miradolejs/c-band-downlink-analysis/measurement_stations/hardware/photos/README.md

# Hardware Photographs

This gallery documents the antenna installations, equipment setups, and custom electronics developed for the measurement stations.

Some photographs show assembly and testing stages. The final hardware configuration is specified in the [component list](../component_list.csv) and [measurement methodology](../../../docs/measurement_methodology.md).

## Urban antenna installation — Zlín

Front view of the urban antenna


*Front view of the urban antenna installation, with the faculty building and rooftop structures in the background.*

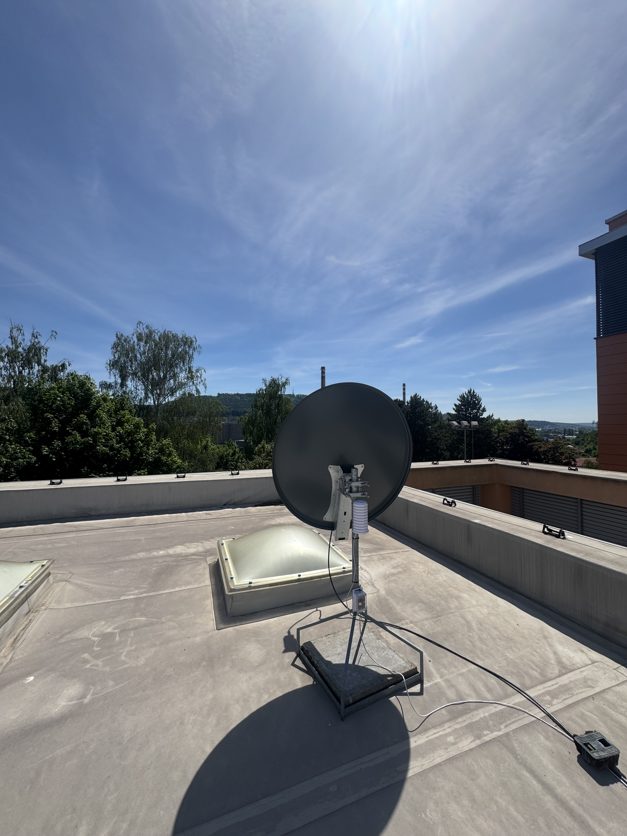
[picture p4: measurement_stations/hardware/photos/urban_antenna_rear.jpeg]
Rear view of the urban antenna


*Rear view showing the antenna support, environmental sensor radiation shield, outdoor enclosure, and cable routing.*

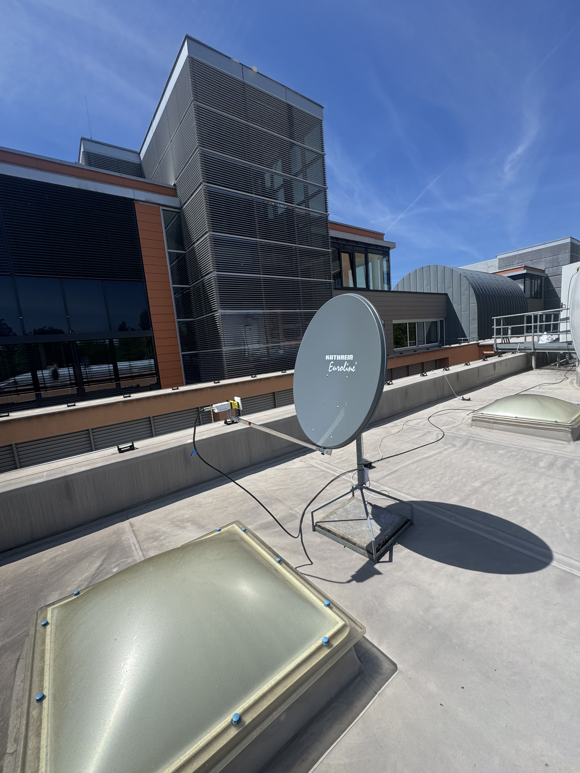
[picture p5: measurement_stations/hardware/photos/urban_antenna_side.jpeg]
Side view of the urban antenna


*Side view of the reflector, LNB assembly, and ballasted antenna support.*

## Rural antenna installation — Hošťálková

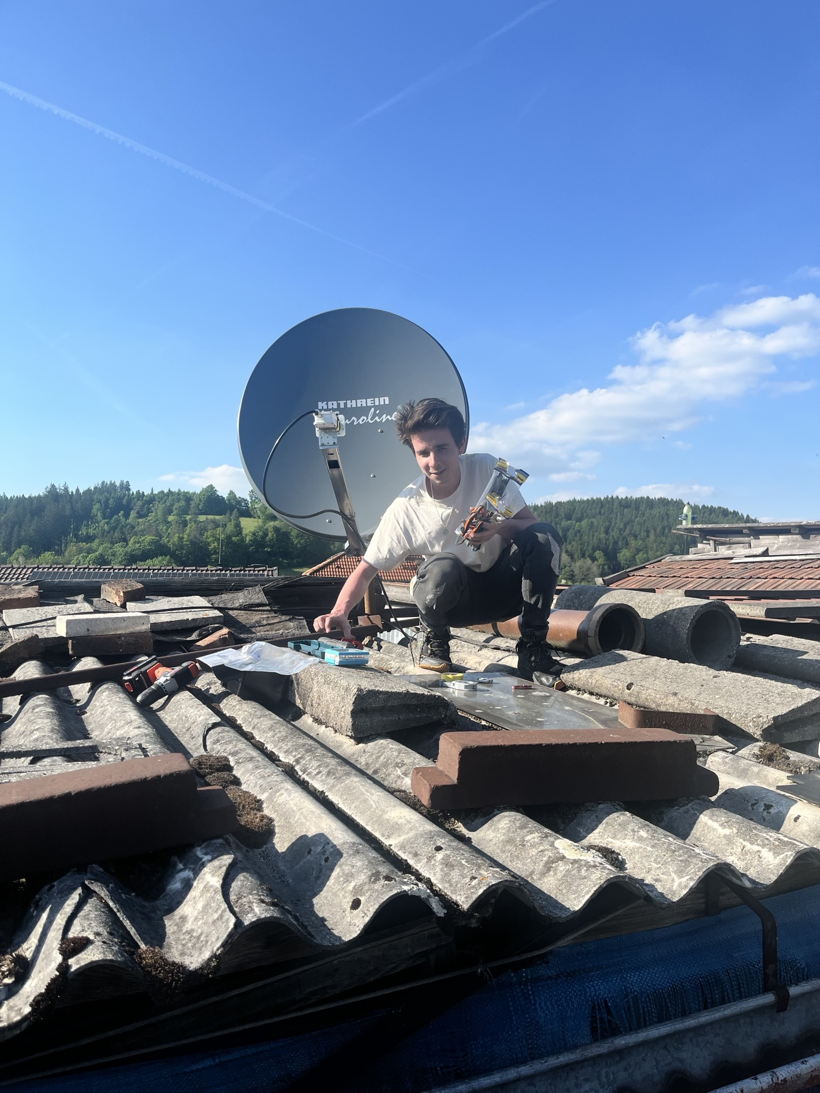
[picture p6: measurement_stations/hardware/photos/rural_antenna_installation.jpeg]
Installation of the rural antenna


*Installation work on the rural antenna, with nearby rooftops and wooded slopes in the background.*

## Rural site context — map imagery

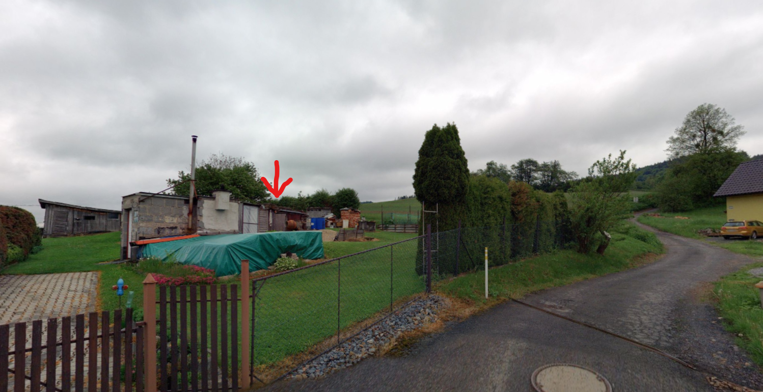
[picture p7: measurement_stations/hardware/photos/rural_installation_location.png]
Rural installation location


*Panorama image from [Mapy.com](https://mapy.com/) showing the rural installation area. The arrow marking the antenna installation location was added by the project team.*

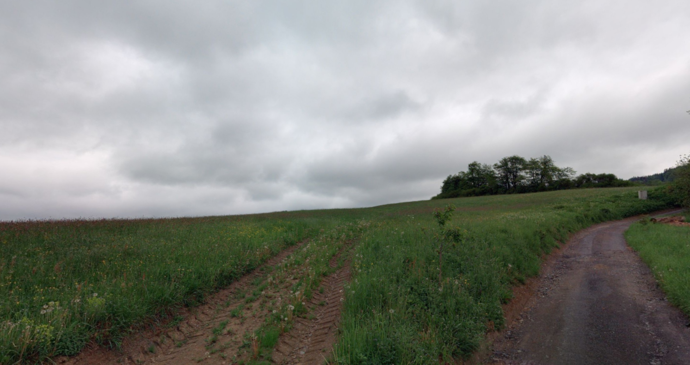
[picture p8: measurement_stations/hardware/photos/rural_reception_view.png]
Approximate rural reception direction


*Panorama image from [Mapy.com](https://mapy.com/) illustrating the approximate reception direction. The viewpoint differs from the antenna position and does not represent an exact boresight or measured horizon profile.*

## Equipment setups

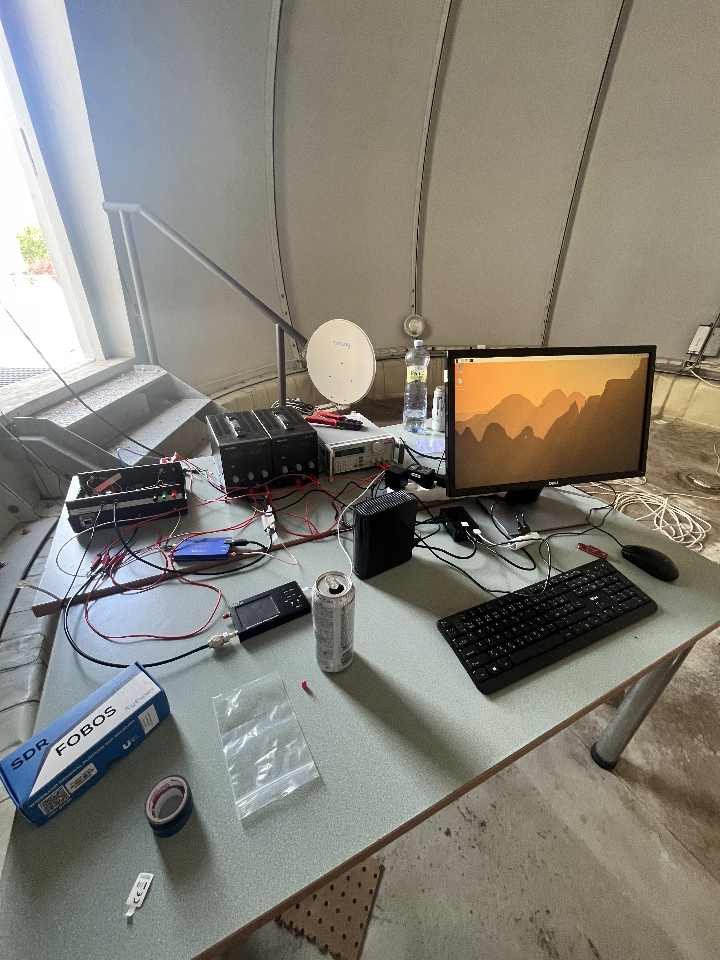
[picture p9: measurement_stations/hardware/photos/urban_equipment_setup.jpeg]
Urban equipment setup


*Equipment arrangement at the urban site during station setup, including power supplies, receiving equipment, storage, and the local computer interface.*

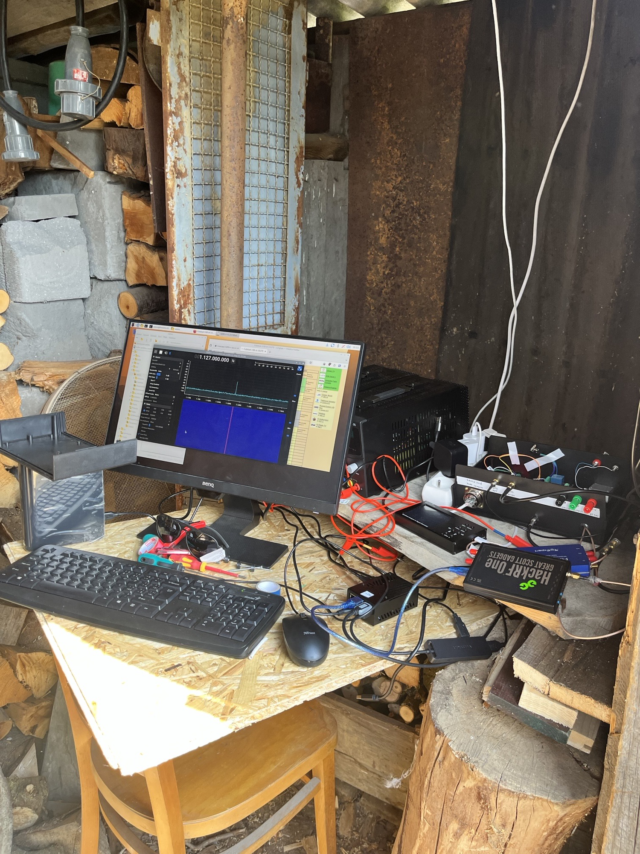
[picture p10: measurement_stations/hardware/photos/rural_equipment_setup.jpeg]
Rural equipment setup


*Equipment arrangement at the rural site during setup and testing. Additional test equipment visible in the photograph, including a HackRF One, is not part of the documented final FOBOS SDR acquisition chain.*

## Custom control electronics

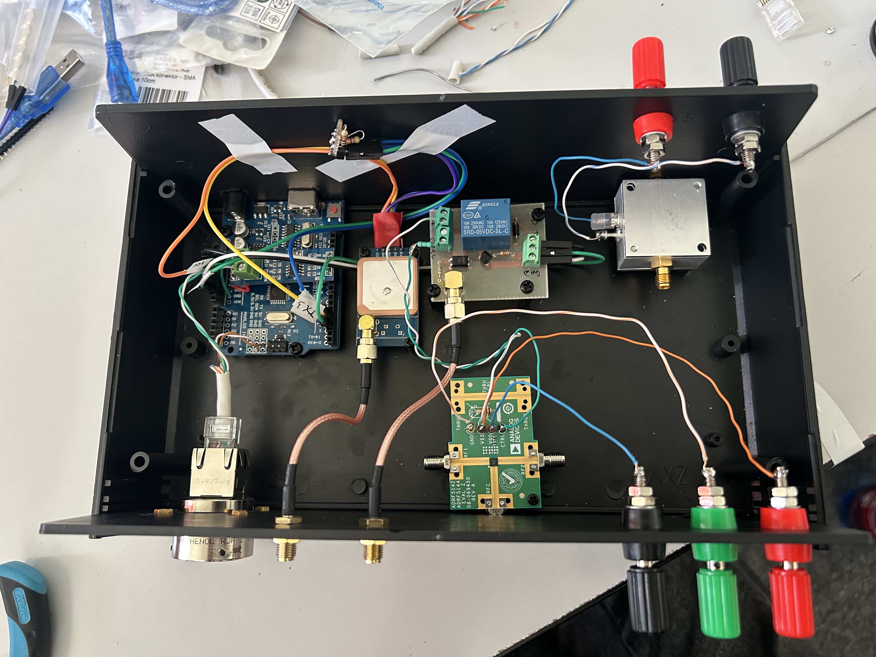
[picture p11: measurement_stations/hardware/photos/control_enclosure_interior.jpeg]
Interior of the control enclosure


*Internal arrangement of the control enclosure during assembly, showing microcontroller electronics, the GPS module, custom PPS control circuitry, RF switch board, bias tee, and panel connections.*

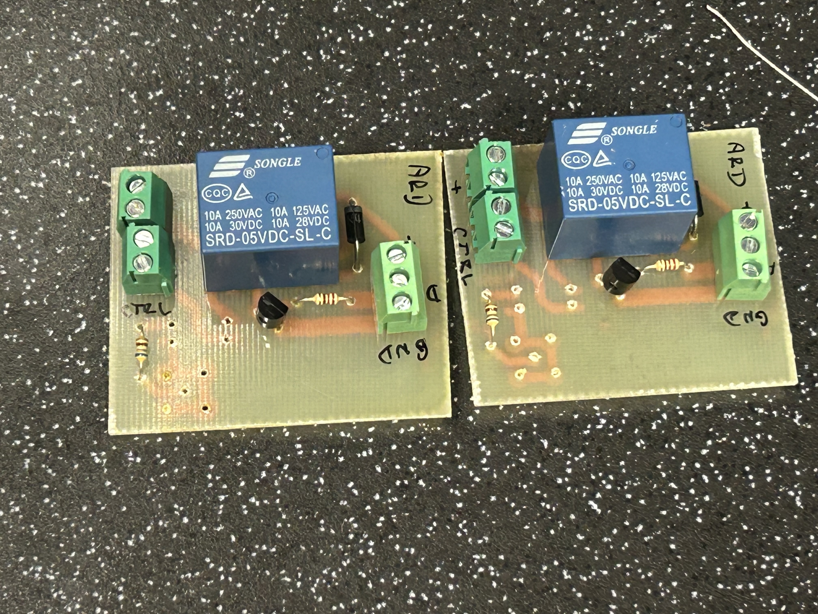
[picture p12: measurement_stations/hardware/photos/pps_control_boards_assembly.jpeg]
PPS control boards during assembly


*Two custom PPS control boards during assembly. The photograph shows the relay, transistor, protection diode, resistors, and terminal blocks; component population is not yet complete.*

## Enclosure panels

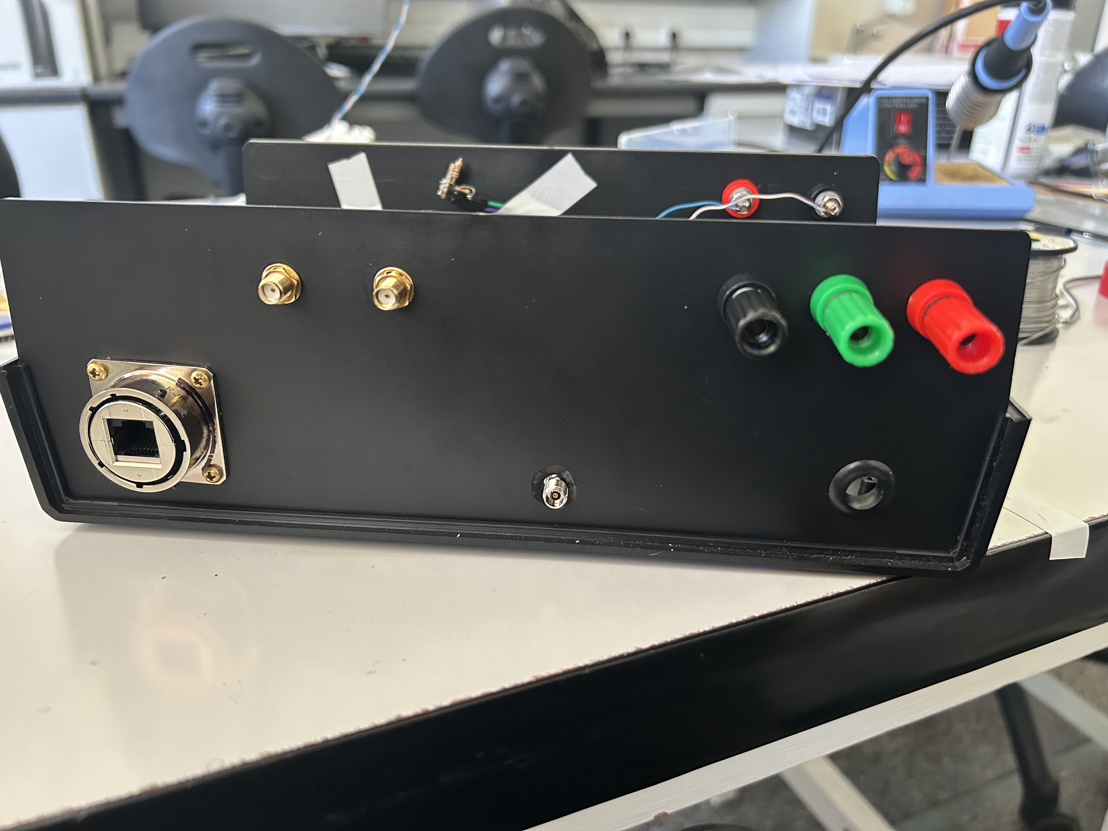
[picture p13: measurement_stations/hardware/photos/control_enclosure_panel_a.jpeg]
Control enclosure panel A


*One enclosure panel during assembly, showing the external signal, telemetry, and power connections.*

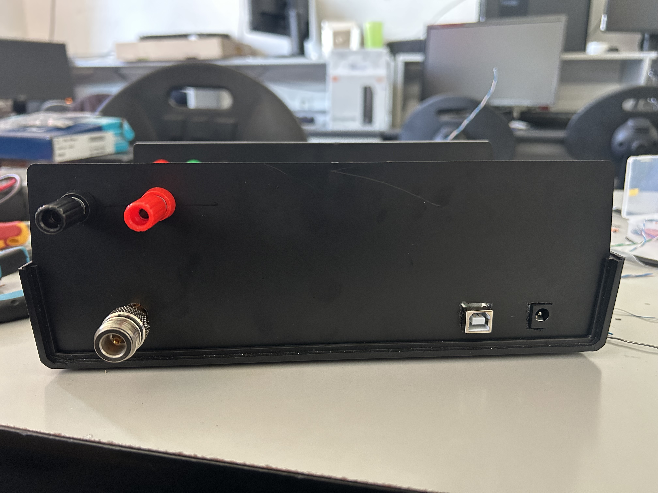
[picture p14: measurement_stations/hardware/photos/control_enclosure_panel_b.jpeg]
Control enclosure panel B


*Opposite enclosure panel during assembly, showing the N-type connector, USB interface, DC connector, and power terminals.*

## Environmental monitoring electronics

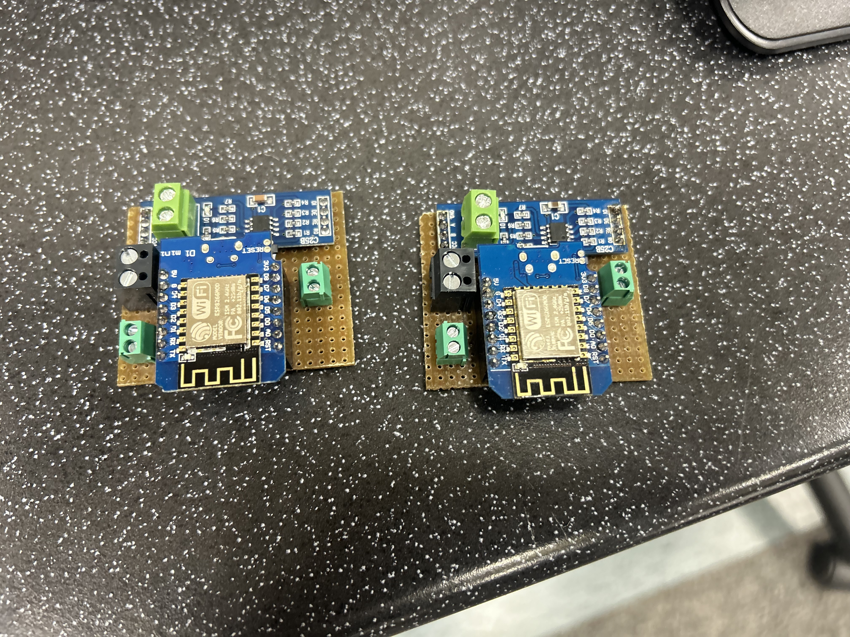
[picture p15: measurement_stations/hardware/photos/environmental_interface_boards.jpeg]
Environmental interface boards


*Two environmental interface assemblies based on Wemos D1 mini boards and RS-485 converter modules, with terminal connections for external wiring.*

## Related documentation

- [Hardware overview](../README.md)
- [Component list](../component_list.csv)
- [Station locations](../../../docs/station_locations.md)
- [Measurement methodology](../../../docs/measurement_methodology.md)
