miradolejs/c-band-downlink-analysis/results/downlink_frames/pps_inventory/2026-09-25_2026-09-30/PPS_overview.png

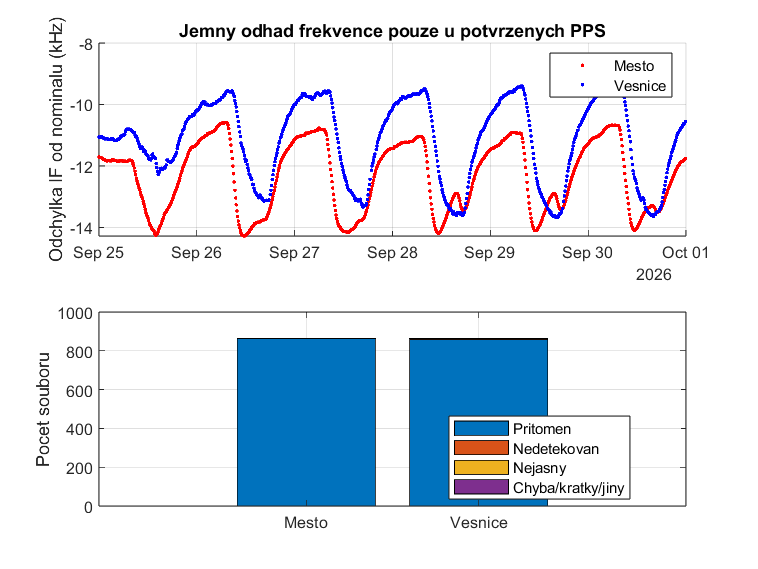
results/downlink_frames/pps_inventory/2026-09-25_2026-09-30/PPS_overview.png
