miradolejs/c-band-downlink-analysis/measurement_stations/hardware/component_list.csv

Category | Component | Model | Specification | Function | Quantity_City | Quantity_Village | Quantity_Total | Unit | Parent_Assembly | Notes
Reception | Parabolic reflector | Kathrein KEA 1000/G | 100 cm; aluminium reflector; graphite colour | Collect C-band satellite signals | 1 | 1 | 2 | piece
Reception | LNB | Norsat 3620N | C-band; linear polarization; LO 5150 MHz; 50 ohm output | Amplify and downconvert the received signal | 1 | 1 | 2 | piece
Reception | Bias tee | ZFBT-4R2GW-FT+ | 24 V DC supplied to the LNB | Supply DC power to the LNB and block DC towards the SDR | 1 | 1 | 2 | piece
Power | Linear laboratory power supply | VOLTCRAFT LPS1305 | LNB: 24 V DC; RF switch: +3.3 V and -3.3 V relative to common ground | Power the LNB and RF switch | 3 | 3 | 6 | piece |  | One supply for the 24 V LNB feed; two supplies for the RF switch bipolar supply (+3.3 V / -3.3 V).
Reception | Main coaxial cable | SSB Electronic Ecoflex 10 | 50 ohm | Connect the LNB to the SDR receiving chain | 17 | 10 | 27 | m |  | Cable length differs between sites.
Reception | N connector | SSB Electronic 7383 | For Ecoflex 10 / Aircom cable | Terminate the main coaxial cable | 2 | 2 | 4 | piece
Reception | SMA female to N female adapter | Amphenol 242115 |  | Adapt the bias tee connections | 2 | 2 | 4 | piece
Reception | SDR receiver | FOBOS SDR |  | Digitize the received IF signal | 1 | 1 | 2 | piece
Marker control | AND control assembly | Custom design | Relay and optocoupler implementation | Combine the Arduino enable signal and GPSDO PPS | 1 | 1 | 2 | piece |  | Assembly reference only; individual parts are listed separately. Quantity inferred as one assembly per station.
Marker control | Relay | Songle SRD-05VDC-SL-C | 5 V coil | Gate the control path under Arduino control | 1 | 1 | 2 | piece | Custom AND control assembly
Marker control | NPN transistor | 2N2222 | 40 V; 600 mA; TO-92 | Drive the relay from the Arduino | 1 | 1 | 2 | piece | Custom AND control assembly | Ratings reproduced from the supplied component list.
Marker control | Optocoupler | BPC-817 |  | Control the RF switch from PPS with galvanic isolation | 1 | 1 | 2 | piece | Custom AND control assembly
Marker control | Resistor | RC0204 | 680 ohm; 0.125 W; 5%; carbon | Limit optocoupler input current | 1 | 1 | 2 | piece | Custom AND control assembly
Marker control | Resistor | RC0204 | 220 ohm; 0.25 W; 5% | Limit transistor base current | 1 | 1 | 2 | piece | Custom AND control assembly
Marker control | Two-position PCB terminal block | CY350-3.5-2P | 3.5 mm pitch; green | Connect the RF switch | 2 | 2 | 4 | piece | Custom AND control assembly
Marker control | Three-position PCB terminal block | CY350-3.5-3P | 3.5 mm pitch; green | Connect the Arduino | 1 | 1 | 2 | piece | Custom AND control assembly
Marker control | PCB SMA connector | Taoglas PCB.SMAFRA.HT |  | Connect the GPSDO PPS input | 1 | 1 | 2 | piece | Custom AND control assembly
Control and telemetry | Microcontroller board | UNO R3 clone | ATmega328P; CH340 USB interface | Control PPS injection; collect environmental readings; forward data to Raspberry Pi | 1 | 1 | 2 | piece
Control and telemetry | Temperature and humidity sensor | AHT10 |  | Measure air temperature and relative humidity | 1 | 1 | 2 | piece
Control and telemetry | GPS receiver module | NEO-7M |  | Provide timing information to the Arduino | 1 | 1 | 2 | piece
Control and telemetry | Outdoor sensor microcontroller | WeMos D1 Mini | ESP8266 | Read the environmental sensor near the antenna | 1 | 1 | 2 | piece
Control and telemetry | TTL to RS-485 converter | MAX485 module |  | Provide the serial link between Wemos and Arduino | 2 | 2 | 4 | piece
Control and telemetry | GPS antenna for NEO-7M | EAN 8596425189878 | Magnetic base; 3 m cable; SMA connector | Receive GNSS signals for the Arduino GPS module | 1 | 1 | 2 | piece |  | Separate from the GPS antenna included with the GPSDO.
Enclosures | Outdoor enclosure | Not specified | IP66; ABS V0 body; PC V0 transparent cover; 132.2 x 68.7 x 50.1 mm | House the Wemos D1 mini | 1 | 1 | 2 | piece
Enclosures | Sensor radiation shield | TFA Dostmann 98.1114.02 |  | Shield the AHT10 environmental sensor | 1 | 1 | 2 | piece
Enclosures | Silica gel desiccant sachet | Not specified | 10 g per sachet; 72 x 57 x 3 mm | Reduce moisture inside the Wemos enclosure | 3 | 3 | 6 | piece |  | Three sachets per station.
Acquisition computer | Single-board computer | Raspberry Pi 5 | 16 GB RAM | Control IQ acquisition and metadata recording | 1 | 1 | 2 | piece
Acquisition computer | Computer and NVMe enclosure | Pimoroni case for NVMe Base and Raspberry Pi 5 |  | House the Raspberry Pi and NVMe Base | 1 | 1 | 2 | piece
Acquisition computer | NVMe adapter board | Pimoroni NVMe Base for Raspberry Pi 5 |  | Connect the NVMe SSD to Raspberry Pi | 1 | 1 | 2 | piece
Acquisition computer | Active cooler | Raspberry Pi 5 Active Cooler |  | Cool the Raspberry Pi | 1 | 1 | 2 | piece
Power | Raspberry Pi power supply | Raspberry Pi 27W USB-C Power Supply | EU plug; black | Power the Raspberry Pi | 1 | 1 | 2 | piece
Acquisition computer | Monitor cable | Raspberry Pi micro-HDMI cable | 1 m; black | Connect a monitor during setup or maintenance | 1 | 1 | 2 | piece
Storage | NVMe SSD | PATRIOT P310 | 240 GB; M.2 NVMe | Provide temporary recording storage during HDD replacement | 1 | 1 | 2 | piece
Storage | External hard disk | WD Elements Desktop WDBWLG0160HBK-EESN | 16 TB per drive; 3.5 inch | Store recorded IQ data | 2 | 2 | 4 | piece |  | Two drives used per station and exchanged manually. Acquisition was split between drives to allow analysis of collected data while recording continued. One 16 TB drive per station would have provided sufficient capacity for the documented campaign.
Timing reference | GPSDO with external GPS antenna | Leo Bodnar LBE-1425 | Two-port | Provide the SDR 10 MHz reference and PPS marker timing | 1 | 1 | 2 | piece |  | Quantity is a kit including its GPS antenna.
Marker injection | RF signal generator / spectrum analyzer | HTOOL SA8 |  | Generate the continuous-wave RF marker signal | 1 | 1 | 2 | piece
Marker injection | RF switch evaluation board | ADRF5144-EVALZ |  | Gate the RF marker according to the PPS control signal | 1 | 1 | 2 | piece
Interconnects | Banana test lead | VOLTCRAFT | 4 mm plugs at both ends; 1 m | Connect laboratory power supplies to the RF switch and bias tee | 6 | 6 | 12 | piece
Interconnects | SMA coaxial cable | CSE-SGAM-305-SGAM |  | Connect timing references and RF components | 5 | 5 | 10 | piece |  | PPS to AND assembly; 10 MHz to SDR; SDR to bias tee; generator to switch; switch output for capacitive injection.
Enclosures | Electronics enclosure | Z15 / KP13 | 148 x 250 x 90 mm; side panels | House the RF switch; bias tee; Arduino; NEO-7M; AND assembly | 1 | 1 | 2 | piece
Interconnects | SMA male to SMA female extension | Not specified | 10 cm | Route the GPS module and AND assembly SMA connections to the enclosure panel | 2 | 2 | 4 | piece
Interconnects | Panel banana terminal | Not specified |  | Expose RF switch and bias tee power connections on the enclosure panel | 5 | 5 | 10 | piece
