miradolejs/c-band-downlink-analysis/results/downlink_frames/pps_inventory/2026-09-25_2026-09-30/PPS_all_files.csv

Measurement_ID | Source_File | File_Name | Day_Folder | File_Start_Time | Filename_Time_Valid | File_Size_Bytes | Analyzed_Duration_s | Complete_First5s | Status | PPS_Detected | Pulse_Count | Candidate_Pulse_Count | Marker_IF_Hz | Marker_Offset_Hz | Pulse_Frequency_Spread_Hz | Coarse_Candidate_IF_Hz | FFT_Bin_Width_Hz | Max_Period_Residual_s | Median_Line_SNR_dB | Median_Temporal_Contrast_dB | Clipped_Sample_Fraction | Metadata_Status | Message | Location
250926/1013_000000_250926.raw | E:\iq_data\mesto_1_2509_3009_2026\250926\1013_000000_250926.raw | 1013_000000_250926.raw | 250926 | 25-Sep-2026 00:00:00 | 1 | 2391818240 | 5 | 1 | present | 1 | 4 | 4 | 1314988299.889 | -11700.111 | 0.011 | 1314988281.25 | 48.828125 | 0 | 34.415 | 34.435 | 0 | checked | Uzka prerusovana cara; pozadovany pocet pulzu splnuje periodu PPS. | city
250926/1014_001000_250926.raw | E:\iq_data\mesto_1_2509_3009_2026\250926\1014_001000_250926.raw | 1014_001000_250926.raw | 250926 | 25-Sep-2026 00:10:00 | 1 | 2399158272 | 5 | 1 | present | 1 | 4 | 5 | 1314988285.219 | -11714.781 | 0.078 | 1314988281.25 | 48.828125 | 0 | 34.846 | 34.279 | 0 | checked | Uzka prerusovana cara; pozadovany pocet pulzu splnuje periodu PPS. | city
250926/1015_002000_250926.raw | E:\iq_data\mesto_1_2509_3009_2026\250926\1015_002000_250926.raw | 1015_002000_250926.raw | 250926 | 25-Sep-2026 00:20:00 | 1 | 2399158272 | 5 | 1 | present | 1 | 4 | 5 | 1314988276.015 | -11723.985 | 0.033 | 1314988281.25 | 48.828125 | 0 | 34.514 | 33.996 | 0 | checked | Uzka prerusovana cara; pozadovany pocet pulzu splnuje periodu PPS. | city
250926/1016_003000_250926.raw | E:\iq_data\mesto_1_2509_3009_2026\250926\1016_003000_250926.raw | 1016_003000_250926.raw | 250926 | 25-Sep-2026 00:30:00 | 1 | 2399158272 | 5 | 1 | present | 1 | 5 | 5 | 1314988272.384 | -11727.616 | 0.2 | 1314988281.25 | 48.828125 | 0.035 | 34.71 | 34.665 | 0 | checked | Uzka prerusovana cara; pozadovany pocet pulzu splnuje periodu PPS. | city
250926/1017_004000_250926.raw | E:\iq_data\mesto_1_2509_3009_2026\250926\1017_004000_250926.raw | 1017_004000_250926.raw | 250926 | 25-Sep-2026 00:40:00 | 1 | 2400206848 | 5 | 1 | present | 1 | 4 | 4 | 1314988257.318 | -11742.682 | 0.024 | 1314988232.42188 | 48.828125 | 0 | 34.801 | 34.237 | 0 | checked | Uzka prerusovana cara; pozadovany pocet pulzu splnuje periodu PPS. | city
250926/1018_005000_250926.raw | E:\iq_data\mesto_1_2509_3009_2026\250926\1018_005000_250926.raw | 1018_005000_250926.raw | 250926 | 25-Sep-2026 00:50:00 | 1 | 2399158272 | 5 | 1 | present | 1 | 4 | 4 | 1314988243.792 | -11756.208 | 0.006 | 1314988232.42188 | 48.828125 | 0 | 36.021 | 35.416 | 0 | checked | Uzka prerusovana cara; pozadovany pocet pulzu splnuje periodu PPS. | city
250926/1019_010000_250926.raw | E:\iq_data\mesto_1_2509_3009_2026\250926\1019_010000_250926.raw | 1019_010000_250926.raw | 250926 | 25-Sep-2026 01:00:00 | 1 | 2399158272 | 5 | 1 | present | 1 | 4 | 4 | 1314988223.779 | -11776.221 | 0.1 | 1314988232.42188 | 48.828125 | 0 | 34.222 | 34.139 | 0 | checked | Uzka prerusovana cara; pozadovany pocet pulzu splnuje periodu PPS. | city
250926/1020_011000_250926.raw | E:\iq_data\mesto_1_2509_3009_2026\250926\1020_011000_250926.raw | 1020_011000_250926.raw | 250926 | 25-Sep-2026 01:10:00 | 1 | 2399158272 | 5 | 1 | present | 1 | 4 | 5 | 1314988209.459 | -11790.541 | 0.023 | 1314988232.42188 | 48.828125 | 0 | 35.454 | 34.809 | 0 | checked | Uzka prerusovana cara; pozadovany pocet pulzu splnuje periodu PPS. | city
250926/1021_012000_250926.raw | E:\iq_data\mesto_1_2509_3009_2026\250926\1021_012000_250926.raw | 1021_012000_250926.raw | 250926 | 25-Sep-2026 01:20:00 | 1 | 2399158272 | 5 | 1 | present | 1 | 4 | 5 | 1314988201.726 | -11798.274 | 0.075 | 1314988183.59375 | 48.828125 | 0 | 35.235 | 35.396 | 0 | checked | Uzka prerusovana cara; pozadovany pocet pulzu splnuje periodu PPS. | city
250926/1022_013000_250926.raw | E:\iq_data\mesto_1_2509_3009_2026\250926\1022_013000_250926.raw | 1022_013000_250926.raw | 250926 | 25-Sep-2026 01:30:00 | 1 | 2399158272 | 5 | 1 | present | 1 | 4 | 4 | 1314988191.488 | -11808.512 | 0.034 | 1314988183.59375 | 48.828125 | 0 | 36.584 | 35.672 | 0 | checked | Uzka prerusovana cara; pozadovany pocet pulzu splnuje periodu PPS. | city
250926/1023_014000_250926.raw | E:\iq_data\mesto_1_2509_3009_2026\250926\1023_014000_250926.raw | 1023_014000_250926.raw | 250926 | 25-Sep-2026 01:40:00 | 1 | 2399158272 | 5 | 1 | present | 1 | 4 | 4 | 1314988182.336 | -11817.664 | 0.141 | 1314988183.59375 | 48.828125 | 0 | 35.283 | 35.212 | 0 | checked | Uzka prerusovana cara; pozadovany pocet pulzu splnuje periodu PPS. | city
250926/1024_015000_250926.raw | E:\iq_data\mesto_1_2509_3009_2026\250926\1024_015000_250926.raw | 1024_015000_250926.raw | 250926 | 25-Sep-2026 01:50:00 | 1 | 2399158272 | 5 | 1 | present | 1 | 4 | 5 | 1314988166.579 | -11833.421 | 0.024 | 1314988134.76563 | 48.828125 | 0 | 33.532 | 33.214 | 0 | checked | Uzka prerusovana cara; pozadovany pocet pulzu splnuje periodu PPS. | city
250926/1025_020000_250926.raw | E:\iq_data\mesto_1_2509_3009_2026\250926\1025_020000_250926.raw | 1025_020000_250926.raw | 250926 | 25-Sep-2026 02:00:00 | 1 | 2400206848 | 5 | 1 | present | 1 | 4 | 5 | 1314988160.245 | -11839.755 | 0.045 | 1314988183.59375 | 48.828125 | 0 | 35.231 | 35.453 | 0 | checked | Uzka prerusovana cara; pozadovany pocet pulzu splnuje periodu PPS. | city
250926/1026_021000_250926.raw | E:\iq_data\mesto_1_2509_3009_2026\250926\1026_021000_250926.raw | 1026_021000_250926.raw | 250926 | 25-Sep-2026 02:10:00 | 1 | 2399158272 | 5 | 1 | present | 1 | 4 | 5 | 1314988172.767 | -11827.233 | 0.057 | 1314988183.59375 | 48.828125 | 0 | 35.486 | 34.345 | 0 | checked | Uzka prerusovana cara; pozadovany pocet pulzu splnuje periodu PPS. | city
250926/1027_022000_250926.raw | E:\iq_data\mesto_1_2509_3009_2026\250926\1027_022000_250926.raw | 1027_022000_250926.raw | 250926 | 25-Sep-2026 02:20:00 | 1 | 2399158272 | 5 | 1 | present | 1 | 4 | 4 | 1314988173.758 | -11826.242 | 0.057 | 1314988183.59375 | 48.828125 | 0 | 35.354 | 34.926 | 0 | checked | Uzka prerusovana cara; pozadovany pocet pulzu splnuje periodu PPS. | city
250926/1028_023000_250926.raw | E:\iq_data\mesto_1_2509_3009_2026\250926\1028_023000_250926.raw | 1028_023000_250926.raw | 250926 | 25-Sep-2026 02:30:00 | 1 | 2395619328 | 5 | 1 | present | 1 | 4 | 4 | 1314988168.571 | -11831.429 | 0.071 | 1314988183.59375 | 48.828125 | 0 | 36.503 | 35.561 | 0 | checked | Uzka prerusovana cara; pozadovany pocet pulzu splnuje periodu PPS. | city
250926/1029_024000_250926.raw | E:\iq_data\mesto_1_2509_3009_2026\250926\1029_024000_250926.raw | 1029_024000_250926.raw | 250926 | 25-Sep-2026 02:40:00 | 1 | 2396389376 | 5 | 1 | present | 1 | 4 | 5 | 1314988170.002 | -11829.998 | 0.038 | 1314988183.59375 | 48.828125 | 0 | 36.773 | 35.933 | 0 | checked | Uzka prerusovana cara; pozadovany pocet pulzu splnuje periodu PPS. | city
250926/1030_025000_250926.raw | E:\iq_data\mesto_1_2509_3009_2026\250926\1030_025000_250926.raw | 1030_025000_250926.raw | 250926 | 25-Sep-2026 02:50:00 | 1 | 2399158272 | 5 | 1 | present | 1 | 5 | 5 | 1314988162.563 | -11837.437 | 0.085 | 1314988134.76563 | 48.828125 | 0.025 | 36.32 | 35.785 | 0 | checked | Uzka prerusovana cara; pozadovany pocet pulzu splnuje periodu PPS. | city
250926/1031_030000_250926.raw | E:\iq_data\mesto_1_2509_3009_2026\250926\1031_030000_250926.raw | 1031_030000_250926.raw | 250926 | 25-Sep-2026 03:00:00 | 1 | 2399158272 | 5 | 1 | present | 1 | 4 | 4 | 1314988174.951 | -11825.049 | 0.099 | 1314988183.59375 | 48.828125 | 0 | 37.039 | 35.751 | 0 | checked | Uzka prerusovana cara; pozadovany pocet pulzu splnuje periodu PPS. | city
250926/1032_031000_250926.raw | E:\iq_data\mesto_1_2509_3009_2026\250926\1032_031000_250926.raw | 1032_031000_250926.raw | 250926 | 25-Sep-2026 03:10:00 | 1 | 2399158272 | 5 | 1 | present | 1 | 4 | 5 | 1314988195.184 | -11804.816 | 0.085 | 1314988183.59375 | 48.828125 | 0 | 36.849 | 35.671 | 0 | checked | Uzka prerusovana cara; pozadovany pocet pulzu splnuje periodu PPS. | city
250926/1033_032000_250926.raw | E:\iq_data\mesto_1_2509_3009_2026\250926\1033_032000_250926.raw | 1033_032000_250926.raw | 250926 | 25-Sep-2026 03:20:00 | 1 | 2399158272 | 5 | 1 | present | 1 | 4 | 5 | 1314988202.949 | -11797.051 | 0.036 | 1314988183.59375 | 48.828125 | 0 | 36.821 | 35.749 | 0 | checked | Uzka prerusovana cara; pozadovany pocet pulzu splnuje periodu PPS. | city
250926/1034_033000_250926.raw | E:\iq_data\mesto_1_2509_3009_2026\250926\1034_033000_250926.raw | 1034_033000_250926.raw | 250926 | 25-Sep-2026 03:30:00 | 1 | 2399158272 | 5 | 1 | present | 1 | 4 | 4 | 1314988199.419 | -11800.581 | 0.024 | 1314988183.59375 | 48.828125 | 0 | 36.658 | 35.649 | 0 | checked | Uzka prerusovana cara; pozadovany pocet pulzu splnuje periodu PPS. | city
250926/1035_034000_250926.raw | E:\iq_data\mesto_1_2509_3009_2026\250926\1035_034000_250926.raw | 1035_034000_250926.raw | 250926 | 25-Sep-2026 03:40:00 | 1 | 2399158272 | 5 | 1 | present | 1 | 4 | 4 | 1314988194.832 | -11805.168 | 0.209 | 1314988183.59375 | 48.828125 | 0 | 36.51 | 35.679 | 0 | checked | Uzka prerusovana cara; pozadovany pocet pulzu splnuje periodu PPS. | city
250926/1036_035000_250926.raw | E:\iq_data\mesto_1_2509_3009_2026\250926\1036_035000_250926.raw | 1036_035000_250926.raw | 250926 | 25-Sep-2026 03:50:00 | 1 | 2399158272 | 5 | 1 | present | 1 | 4 | 5 | 1314988188.261 | -11811.739 | 0.013 | 1314988183.59375 | 48.828125 | 0 | 36.62 | 36.024 | 0 | checked | Uzka prerusovana cara; pozadovany pocet pulzu splnuje periodu PPS. | city
250926/1037_040000_250926.raw | E:\iq_data\mesto_1_2509_3009_2026\250926\1037_040000_250926.raw | 1037_040000_250926.raw | 250926 | 25-Sep-2026 04:00:00 | 1 | 2399158272 | 5 | 1 | present | 1 | 4 | 5 | 1314988181.541 | -11818.459 | 0.026 | 1314988183.59375 | 48.828125 | 0.005 | 37.029 | 35.827 | 0 | checked | Uzka prerusovana cara; pozadovany pocet pulzu splnuje periodu PPS. | city
250926/1038_041000_250926.raw | E:\iq_data\mesto_1_2509_3009_2026\250926\1038_041000_250926.raw | 1038_041000_250926.raw | 250926 | 25-Sep-2026 04:10:00 | 1 | 2399158272 | 5 | 1 | present | 1 | 4 | 4 | 1314988175.801 | -11824.199 | 0.049 | 1314988183.59375 | 48.828125 | 0 | 36.668 | 35.783 | 0 | checked | Uzka prerusovana cara; pozadovany pocet pulzu splnuje periodu PPS. | city
250926/1039_042000_250926.raw | E:\iq_data\mesto_1_2509_3009_2026\250926\1039_042000_250926.raw | 1039_042000_250926.raw | 250926 | 25-Sep-2026 04:20:00 | 1 | 2399158272 | 5 | 1 | present | 1 | 4 | 4 | 1314988161.794 | -11838.206 | 0.05 | 1314988183.59375 | 48.828125 | 0 | 36.536 | 36.17 | 0 | checked | Uzka prerusovana cara; pozadovany pocet pulzu splnuje periodu PPS. | city
250926/1040_043000_250926.raw | E:\iq_data\mesto_1_2509_3009_2026\250926\1040_043000_250926.raw | 1040_043000_250926.raw | 250926 | 25-Sep-2026 04:30:00 | 1 | 2399158272 | 5 | 1 | present | 1 | 4 | 5 | 1314988153.761 | -11846.239 | 0.038 | 1314988183.59375 | 48.828125 | 0.005 | 36.108 | 36.151 | 0 | checked | Uzka prerusovana cara; pozadovany pocet pulzu splnuje periodu PPS. | city
250926/1041_044000_250926.raw | E:\iq_data\mesto_1_2509_3009_2026\250926\1041_044000_250926.raw | 1041_044000_250926.raw | 250926 | 25-Sep-2026 04:40:00 | 1 | 2398109696 | 5 | 1 | present | 1 | 5 | 5 | 1314988151.785 | -11848.215 | 0.047 | 1314988134.76563 | 48.828125 | 0.03 | 36.453 | 35.828 | 0 | checked | Uzka prerusovana cara; pozadovany pocet pulzu splnuje periodu PPS. | city
250926/1042_045000_250926.raw | E:\iq_data\mesto_1_2509_3009_2026\250926\1042_045000_250926.raw | 1042_045000_250926.raw | 250926 | 25-Sep-2026 04:50:00 | 1 | 2399158272 | 5 | 1 | present | 1 | 4 | 4 | 1314988155.797 | -11844.203 | 0.074 | 1314988134.76563 | 48.828125 | 0 | 37.168 | 36.212 | 0 | checked | Uzka prerusovana cara; pozadovany pocet pulzu splnuje periodu PPS. | city
250926/1043_050000_250926.raw | E:\iq_data\mesto_1_2509_3009_2026\250926\1043_050000_250926.raw | 1043_050000_250926.raw | 250926 | 25-Sep-2026 05:00:00 | 1 | 2399158272 | 5 | 1 | present | 1 | 4 | 5 | 1314988163.223 | -11836.777 | 0.05 | 1314988183.59375 | 48.828125 | 0 | 36.728 | 35.693 | 0 | checked | Uzka prerusovana cara; pozadovany pocet pulzu splnuje periodu PPS. | city
250926/1044_051000_250926.raw | E:\iq_data\mesto_1_2509_3009_2026\250926\1044_051000_250926.raw | 1044_051000_250926.raw | 250926 | 25-Sep-2026 05:10:00 | 1 | 2399158272 | 5 | 1 | present | 1 | 5 | 5 | 1314988170.407 | -11829.593 | 0.146 | 1314988183.59375 | 48.828125 | 0.035 | 36.644 | 36.34 | 0 | checked | Uzka prerusovana cara; pozadovany pocet pulzu splnuje periodu PPS. | city
250926/1045_052000_250926.raw | E:\iq_data\mesto_1_2509_3009_2026\250926\1045_052000_250926.raw | 1045_052000_250926.raw | 250926 | 25-Sep-2026 05:20:00 | 1 | 2397585408 | 5 | 1 | present | 1 | 4 | 4 | 1314988170.83 | -11829.17 | 0.118 | 1314988183.59375 | 48.828125 | 0 | 35.386 | 35.599 | 0 | checked | Uzka prerusovana cara; pozadovany pocet pulzu splnuje periodu PPS. | city
250926/1046_053000_250926.raw | E:\iq_data\mesto_1_2509_3009_2026\250926\1046_053000_250926.raw | 1046_053000_250926.raw | 250926 | 25-Sep-2026 05:30:00 | 1 | 2399158272 | 5 | 1 | present | 1 | 4 | 4 | 1314988174.478 | -11825.522 | 0.059 | 1314988183.59375 | 48.828125 | 0 | 35.113 | 35.425 | 0 | checked | Uzka prerusovana cara; pozadovany pocet pulzu splnuje periodu PPS. | city
250926/1047_054000_250926.raw | E:\iq_data\mesto_1_2509_3009_2026\250926\1047_054000_250926.raw | 1047_054000_250926.raw | 250926 | 25-Sep-2026 05:40:00 | 1 | 2399158272 | 5 | 1 | present | 1 | 4 | 5 | 1314988167.124 | -11832.876 | 0.069 | 1314988183.59375 | 48.828125 | 0 | 35.458 | 35.542 | 0 | checked | Uzka prerusovana cara; pozadovany pocet pulzu splnuje periodu PPS. | city
250926/1048_055000_250926.raw | E:\iq_data\mesto_1_2509_3009_2026\250926\1048_055000_250926.raw | 1048_055000_250926.raw | 250926 | 25-Sep-2026 05:50:00 | 1 | 2399158272 | 5 | 1 | present | 1 | 4 | 5 | 1314988163.571 | -11836.429 | 0.044 | 1314988183.59375 | 48.828125 | 0 | 35.143 | 35.27 | 0 | checked | Uzka prerusovana cara; pozadovany pocet pulzu splnuje periodu PPS. | city
250926/1049_060000_250926.raw | E:\iq_data\mesto_1_2509_3009_2026\250926\1049_060000_250926.raw | 1049_060000_250926.raw | 250926 | 25-Sep-2026 06:00:00 | 1 | 2400272384 | 5 | 1 | present | 1 | 4 | 4 | 1314988157.882 | -11842.118 | 0.038 | 1314988134.76563 | 48.828125 | 0 | 35.151 | 35.05 | 0 | checked | Uzka prerusovana cara; pozadovany pocet pulzu splnuje periodu PPS. | city
250926/1050_061000_250926.raw | E:\iq_data\mesto_1_2509_3009_2026\250926\1050_061000_250926.raw | 1050_061000_250926.raw | 250926 | 25-Sep-2026 06:10:00 | 1 | 2399158272 | 5 | 1 | present | 1 | 4 | 5 | 1314988160.069 | -11839.931 | 0.06 | 1314988134.76563 | 48.828125 | 0 | 35.331 | 35.129 | 0 | checked | Uzka prerusovana cara; pozadovany pocet pulzu splnuje periodu PPS. | city
250926/1051_062000_250926.raw | E:\iq_data\mesto_1_2509_3009_2026\250926\1051_062000_250926.raw | 1051_062000_250926.raw | 250926 | 25-Sep-2026 06:20:00 | 1 | 2399158272 | 5 | 1 | present | 1 | 4 | 5 | 1314988160.172 | -11839.828 | 0.08 | 1314988183.59375 | 48.828125 | 0 | 34.488 | 34.969 | 0 | checked | Uzka prerusovana cara; pozadovany pocet pulzu splnuje periodu PPS. | city
250926/1052_063000_250926.raw | E:\iq_data\mesto_1_2509_3009_2026\250926\1052_063000_250926.raw | 1052_063000_250926.raw | 250926 | 25-Sep-2026 06:30:00 | 1 | 2399158272 | 5 | 1 | present | 1 | 4 | 4 | 1314988149.195 | -11850.805 | 0.137 | 1314988134.76563 | 48.828125 | 0 | 31.283 | 31.481 | 0 | checked | Uzka prerusovana cara; pozadovany pocet pulzu splnuje periodu PPS. | city
250926/1053_064000_250926.raw | E:\iq_data\mesto_1_2509_3009_2026\250926\1053_064000_250926.raw | 1053_064000_250926.raw | 250926 | 25-Sep-2026 06:40:00 | 1 | 2399158272 | 5 | 1 | present | 1 | 4 | 4 | 1314988151.418 | -11848.582 | 0.073 | 1314988134.76563 | 48.828125 | 0 | 32.36 | 33.717 | 0 | checked | Uzka prerusovana cara; pozadovany pocet pulzu splnuje periodu PPS. | city
250926/1054_065000_250926.raw | E:\iq_data\mesto_1_2509_3009_2026\250926\1054_065000_250926.raw | 1054_065000_250926.raw | 250926 | 25-Sep-2026 06:50:00 | 1 | 2399158272 | 5 | 1 | present | 1 | 4 | 5 | 1314988152.914 | -11847.086 | 0.246 | 1314988134.76563 | 48.828125 | 0 | 32.354 | 32.284 | 0 | checked | Uzka prerusovana cara; pozadovany pocet pulzu splnuje periodu PPS. | city
250926/1055_070000_250926.raw | E:\iq_data\mesto_1_2509_3009_2026\250926\1055_070000_250926.raw | 1055_070000_250926.raw | 250926 | 25-Sep-2026 07:00:00 | 1 | 2399158272 | 5 | 1 | present | 1 | 5 | 5 | 1314988162.478 | -11837.522 | 0.116 | 1314988134.76563 | 48.828125 | 0.035 | 27.447 | 26.893 | 0 | checked | Uzka prerusovana cara; pozadovany pocet pulzu splnuje periodu PPS. | city
250926/1056_071000_250926.raw | E:\iq_data\mesto_1_2509_3009_2026\250926\1056_071000_250926.raw | 1056_071000_250926.raw | 250926 | 25-Sep-2026 07:10:00 | 1 | 2399158272 | 5 | 1 | present | 1 | 4 | 4 | 1314988180.235 | -11819.765 | 0.068 | 1314988183.59375 | 48.828125 | 0 | 31.474 | 31.814 | 0 | checked | Uzka prerusovana cara; pozadovany pocet pulzu splnuje periodu PPS. | city
250926/1057_072000_250926.raw | E:\iq_data\mesto_1_2509_3009_2026\250926\1057_072000_250926.raw | 1057_072000_250926.raw | 250926 | 25-Sep-2026 07:20:00 | 1 | 2400272384 | 5 | 1 | present | 1 | 4 | 4 | 1314988186.327 | -11813.673 | 0.071 | 1314988183.59375 | 48.828125 | 0 | 33.237 | 32.408 | 0 | checked | Uzka prerusovana cara; pozadovany pocet pulzu splnuje periodu PPS. | city
250926/1058_073000_250926.raw | E:\iq_data\mesto_1_2509_3009_2026\250926\1058_073000_250926.raw | 1058_073000_250926.raw | 250926 | 25-Sep-2026 07:30:00 | 1 | 2399158272 | 5 | 1 | present | 1 | 4 | 4 | 1314988193.4 | -11806.6 | 0.085 | 1314988183.59375 | 48.828125 | 0 | 32.011 | 31.705 | 0 | checked | Uzka prerusovana cara; pozadovany pocet pulzu splnuje periodu PPS. | city
250926/1059_074000_250926.raw | E:\iq_data\mesto_1_2509_3009_2026\250926\1059_074000_250926.raw | 1059_074000_250926.raw | 250926 | 25-Sep-2026 07:40:00 | 1 | 2399158272 | 5 | 1 | present | 1 | 4 | 4 | 1314988185.361 | -11814.639 | 0.024 | 1314988183.59375 | 48.828125 | 0 | 33.906 | 33.647 | 0 | checked | Uzka prerusovana cara; pozadovany pocet pulzu splnuje periodu PPS. | city
250926/1060_075000_250926.raw | E:\iq_data\mesto_1_2509_3009_2026\250926\1060_075000_250926.raw | 1060_075000_250926.raw | 250926 | 25-Sep-2026 07:50:00 | 1 | 2399158272 | 5 | 1 | present | 1 | 4 | 5 | 1314988175.917 | -11824.083 | 0.143 | 1314988183.59375 | 48.828125 | 0 | 34.499 | 33.048 | 0 | checked | Uzka prerusovana cara; pozadovany pocet pulzu splnuje periodu PPS. | city
250926/1061_080000_250926.raw | E:\iq_data\mesto_1_2509_3009_2026\250926\1061_080000_250926.raw | 1061_080000_250926.raw | 250926 | 25-Sep-2026 08:00:00 | 1 | 2399158272 | 5 | 1 | present | 1 | 5 | 5 | 1314988177.873 | -11822.127 | 0.113 | 1314988183.59375 | 48.828125 | 0.035 | 32.344 | 31.819 | 0 | checked | Uzka prerusovana cara; pozadovany pocet pulzu splnuje periodu PPS. | city
250926/1062_081000_250926.raw | E:\iq_data\mesto_1_2509_3009_2026\250926\1062_081000_250926.raw | 1062_081000_250926.raw | 250926 | 25-Sep-2026 08:10:00 | 1 | 2399158272 | 5 | 1 | present | 1 | 4 | 4 | 1314988156.053 | -11843.947 | 0.074 | 1314988134.76563 | 48.828125 | 0 | 31.533 | 31.951 | 0 | checked | Uzka prerusovana cara; pozadovany pocet pulzu splnuje periodu PPS. | city
250926/1063_082000_250926.raw | E:\iq_data\mesto_1_2509_3009_2026\250926\1063_082000_250926.raw | 1063_082000_250926.raw | 250926 | 25-Sep-2026 08:20:00 | 1 | 2399158272 | 5 | 1 | present | 1 | 4 | 5 | 1314988082.864 | -11917.136 | 0.195 | 1314988085.9375 | 48.828125 | 0 | 29.737 | 31.181 | 0 | checked | Uzka prerusovana cara; pozadovany pocet pulzu splnuje periodu PPS. | city
250926/1064_083000_250926.raw | E:\iq_data\mesto_1_2509_3009_2026\250926\1064_083000_250926.raw | 1064_083000_250926.raw | 250926 | 25-Sep-2026 08:30:00 | 1 | 2399158272 | 5 | 1 | present | 1 | 5 | 5 | 1314988022.338 | -11977.662 | 0.239 | 1314988037.10938 | 48.828125 | 0.03 | 30.166 | 31.359 | 0 | checked | Uzka prerusovana cara; pozadovany pocet pulzu splnuje periodu PPS. | city
250926/1065_084000_250926.raw | E:\iq_data\mesto_1_2509_3009_2026\250926\1065_084000_250926.raw | 1065_084000_250926.raw | 250926 | 25-Sep-2026 08:40:00 | 1 | 2400206848 | 5 | 1 | present | 1 | 4 | 4 | 1314987936.169 | -12063.831 | 0.099 | 1314987939.45313 | 48.828125 | 0 | 29.052 | 31.618 | 0 | checked | Uzka prerusovana cara; pozadovany pocet pulzu splnuje periodu PPS. | city
250926/1066_085000_250926.raw | E:\iq_data\mesto_1_2509_3009_2026\250926\1066_085000_250926.raw | 1066_085000_250926.raw | 250926 | 25-Sep-2026 08:50:00 | 1 | 2399158272 | 5 | 1 | present | 1 | 4 | 4 | 1314987825.609 | -12174.391 | 0.331 | 1314987841.79688 | 48.828125 | 0 | 32.54 | 31.933 | 0 | checked | Uzka prerusovana cara; pozadovany pocet pulzu splnuje periodu PPS. | city
250926/1067_090000_250926.raw | E:\iq_data\mesto_1_2509_3009_2026\250926\1067_090000_250926.raw | 1067_090000_250926.raw | 250926 | 25-Sep-2026 09:00:00 | 1 | 2399158272 | 5 | 1 | present | 1 | 4 | 5 | 1314987711.497 | -12288.503 | 0.152 | 1314987695.3125 | 48.828125 | 0.005 | 33.46 | 33.057 | 0 | checked | Uzka prerusovana cara; pozadovany pocet pulzu splnuje periodu PPS. | city
250926/1068_091000_250926.raw | E:\iq_data\mesto_1_2509_3009_2026\250926\1068_091000_250926.raw | 1068_091000_250926.raw | 250926 | 25-Sep-2026 09:10:00 | 1 | 2399158272 | 5 | 1 | present | 1 | 5 | 5 | 1314987605.345 | -12394.655 | 0.43 | 1314987597.65625 | 48.828125 | 0.03 | 33.441 | 32.966 | 0 | checked | Uzka prerusovana cara; pozadovany pocet pulzu splnuje periodu PPS. | city
250926/1069_092000_250926.raw | E:\iq_data\mesto_1_2509_3009_2026\250926\1069_092000_250926.raw | 1069_092000_250926.raw | 250926 | 25-Sep-2026 09:20:00 | 1 | 2399158272 | 5 | 1 | present | 1 | 4 | 4 | 1314987508.504 | -12491.496 | 0.148 | 1314987500 | 48.828125 | 0 | 30.534 | 30.333 | 0 | checked | Uzka prerusovana cara; pozadovany pocet pulzu splnuje periodu PPS. | city
250926/1070_093000_250926.raw | E:\iq_data\mesto_1_2509_3009_2026\250926\1070_093000_250926.raw | 1070_093000_250926.raw | 250926 | 25-Sep-2026 09:30:00 | 1 | 2399158272 | 5 | 1 | present | 1 | 4 | 5 | 1314987424.966 | -12575.034 | 0.147 | 1314987402.34375 | 48.828125 | 0 | 29.924 | 31.251 | 0 | checked | Uzka prerusovana cara; pozadovany pocet pulzu splnuje periodu PPS. | city
250926/1071_094000_250926.raw | E:\iq_data\mesto_1_2509_3009_2026\250926\1071_094000_250926.raw | 1071_094000_250926.raw | 250926 | 25-Sep-2026 09:40:00 | 1 | 2399158272 | 5 | 1 | present | 1 | 4 | 5 | 1314987352.442 | -12647.558 | 0.176 | 1314987353.51563 | 48.828125 | 0 | 32.234 | 31.981 | 0 | checked | Uzka prerusovana cara; pozadovany pocet pulzu splnuje periodu PPS. | city
250926/1072_095000_250926.raw | E:\iq_data\mesto_1_2509_3009_2026\250926\1072_095000_250926.raw | 1072_095000_250926.raw | 250926 | 25-Sep-2026 09:50:00 | 1 | 2399158272 | 5 | 1 | present | 1 | 4 | 4 | 1314987291.122 | -12708.878 | 0.171 | 1314987304.6875 | 48.828125 | 0 | 33.634 | 32.496 | 0 | checked | Uzka prerusovana cara; pozadovany pocet pulzu splnuje periodu PPS. | city
250926/1073_100000_250926.raw | E:\iq_data\mesto_1_2509_3009_2026\250926\1073_100000_250926.raw | 1073_100000_250926.raw | 250926 | 25-Sep-2026 10:00:00 | 1 | 2400075776 | 5 | 1 | present | 1 | 4 | 4 | 1314987225.52 | -12774.48 | 0.053 | 1314987207.03125 | 48.828125 | 0 | 31.631 | 31.932 | 0 | checked | Uzka prerusovana cara; pozadovany pocet pulzu splnuje periodu PPS. | city
250926/1074_101000_250926.raw | E:\iq_data\mesto_1_2509_3009_2026\250926\1074_101000_250926.raw | 1074_101000_250926.raw | 250926 | 25-Sep-2026 10:10:00 | 1 | 2399158272 | 5 | 1 | present | 1 | 4 | 4 | 1314987144.138 | -12855.862 | 0.1 | 1314987109.375 | 48.828125 | 0 | 30.52 | 30.33 | 0 | checked | Uzka prerusovana cara; pozadovany pocet pulzu splnuje periodu PPS. | city
250926/1075_102000_250926.raw | E:\iq_data\mesto_1_2509_3009_2026\250926\1075_102000_250926.raw | 1075_102000_250926.raw | 250926 | 25-Sep-2026 10:20:00 | 1 | 2399158272 | 5 | 1 | present | 1 | 4 | 5 | 1314987065.371 | -12934.629 | 0.084 | 1314987060.54688 | 48.828125 | 0 | 31.661 | 31.076 | 0 | checked | Uzka prerusovana cara; pozadovany pocet pulzu splnuje periodu PPS. | city
250926/1076_103000_250926.raw | E:\iq_data\mesto_1_2509_3009_2026\250926\1076_103000_250926.raw | 1076_103000_250926.raw | 250926 | 25-Sep-2026 10:30:00 | 1 | 2399158272 | 5 | 1 | present | 1 | 5 | 5 | 1314987000.728 | -12999.272 | 0.259 | 1314987011.71875 | 48.828125 | 0.025 | 31.397 | 30.919 | 0 | checked | Uzka prerusovana cara; pozadovany pocet pulzu splnuje periodu PPS. | city
250926/1077_104000_250926.raw | E:\iq_data\mesto_1_2509_3009_2026\250926\1077_104000_250926.raw | 1077_104000_250926.raw | 250926 | 25-Sep-2026 10:40:00 | 1 | 2399158272 | 5 | 1 | present | 1 | 5 | 5 | 1314986927.544 | -13072.456 | 0.195 | 1314986914.0625 | 48.828125 | 0.025 | 30.189 | 30.188 | 0 | checked | Uzka prerusovana cara; pozadovany pocet pulzu splnuje periodu PPS. | city
250926/1078_105000_250926.raw | E:\iq_data\mesto_1_2509_3009_2026\250926\1078_105000_250926.raw | 1078_105000_250926.raw | 250926 | 25-Sep-2026 10:50:00 | 1 | 2399158272 | 5 | 1 | present | 1 | 4 | 4 | 1314986845.065 | -13154.935 | 0.268 | 1314986865.23438 | 48.828125 | 0.005 | 30.534 | 30.056 | 0 | checked | Uzka prerusovana cara; pozadovany pocet pulzu splnuje periodu PPS. | city
250926/1079_110000_250926.raw | E:\iq_data\mesto_1_2509_3009_2026\250926\1079_110000_250926.raw | 1079_110000_250926.raw | 250926 | 25-Sep-2026 11:00:00 | 1 | 2399158272 | 5 | 1 | present | 1 | 4 | 5 | 1314986762.052 | -13237.948 | 0.138 | 1314986767.57813 | 48.828125 | 0 | 28.026 | 27.229 | 0 | checked | Uzka prerusovana cara; pozadovany pocet pulzu splnuje periodu PPS. | city
250926/1080_111000_250926.raw | E:\iq_data\mesto_1_2509_3009_2026\250926\1080_111000_250926.raw | 1080_111000_250926.raw | 250926 | 25-Sep-2026 11:10:00 | 1 | 2399158272 | 5 | 1 | present | 1 | 4 | 5 | 1314986679.156 | -13320.844 | 0.23 | 1314986669.92188 | 48.828125 | 0 | 26.71 | 26.389 | 0 | checked | Uzka prerusovana cara; pozadovany pocet pulzu splnuje periodu PPS. | city
250926/1081_112000_250926.raw | E:\iq_data\mesto_1_2509_3009_2026\250926\1081_112000_250926.raw | 1081_112000_250926.raw | 250926 | 25-Sep-2026 11:20:00 | 1 | 2400272384 | 5 | 1 | present | 1 | 4 | 4 | 1314986577.208 | -13422.792 | 0.131 | 1314986572.26563 | 48.828125 | 0.005 | 30.978 | 29.714 | 0 | checked | Uzka prerusovana cara; pozadovany pocet pulzu splnuje periodu PPS. | city
250926/1082_113000_250926.raw | E:\iq_data\mesto_1_2509_3009_2026\250926\1082_113000_250926.raw | 1082_113000_250926.raw | 250926 | 25-Sep-2026 11:30:00 | 1 | 2399158272 | 5 | 1 | present | 1 | 4 | 5 | 1314986489.743 | -13510.257 | 0.07 | 1314986474.60938 | 48.828125 | 0 | 30.318 | 30.32 | 0 | checked | Uzka prerusovana cara; pozadovany pocet pulzu splnuje periodu PPS. | city
250926/1083_114000_250926.raw | E:\iq_data\mesto_1_2509_3009_2026\250926\1083_114000_250926.raw | 1083_114000_250926.raw | 250926 | 25-Sep-2026 11:40:00 | 1 | 2399158272 | 5 | 1 | present | 1 | 4 | 4 | 1314986422.958 | -13577.042 | 0.068 | 1314986425.78125 | 48.828125 | 0 | 30.515 | 30.735 | 0 | checked | Uzka prerusovana cara; pozadovany pocet pulzu splnuje periodu PPS. | city
250926/1084_115000_250926.raw | E:\iq_data\mesto_1_2509_3009_2026\250926\1084_115000_250926.raw | 1084_115000_250926.raw | 250926 | 25-Sep-2026 11:50:00 | 1 | 2399158272 | 5 | 1 | present | 1 | 4 | 4 | 1314986358.214 | -13641.786 | 0.307 | 1314986376.95313 | 48.828125 | 0 | 29.856 | 29.709 | 0 | checked | Uzka prerusovana cara; pozadovany pocet pulzu splnuje periodu PPS. | city
250926/1085_120000_250926.raw | E:\iq_data\mesto_1_2509_3009_2026\250926\1085_120000_250926.raw | 1085_120000_250926.raw | 250926 | 25-Sep-2026 12:00:00 | 1 | 2399158272 | 5 | 1 | present | 1 | 4 | 5 | 1314986302.871 | -13697.129 | 0.189 | 1314986328.125 | 48.828125 | 0 | 32.608 | 31.292 | 0 | checked | Uzka prerusovana cara; pozadovany pocet pulzu splnuje periodu PPS. | city
250926/1086_121000_250926.raw | E:\iq_data\mesto_1_2509_3009_2026\250926\1086_121000_250926.raw | 1086_121000_250926.raw | 250926 | 25-Sep-2026 12:10:00 | 1 | 2399158272 | 5 | 1 | present | 1 | 4 | 4 | 1314986240.168 | -13759.832 | 0.179 | 1314986230.46875 | 48.828125 | 0 | 29.944 | 29.114 | 0 | checked | Uzka prerusovana cara; pozadovany pocet pulzu splnuje periodu PPS. | city
250926/1087_122000_250926.raw | E:\iq_data\mesto_1_2509_3009_2026\250926\1087_122000_250926.raw | 1087_122000_250926.raw | 250926 | 25-Sep-2026 12:20:00 | 1 | 2399158272 | 5 | 1 | present | 1 | 4 | 4 | 1314986147.487 | -13852.513 | 0.13 | 1314986132.8125 | 48.828125 | 0 | 30.652 | 30.568 | 0 | checked | Uzka prerusovana cara; pozadovany pocet pulzu splnuje periodu PPS. | city
250926/1088_123000_250926.raw | E:\iq_data\mesto_1_2509_3009_2026\250926\1088_123000_250926.raw | 1088_123000_250926.raw | 250926 | 25-Sep-2026 12:30:00 | 1 | 2399158272 | 5 | 1 | present | 1 | 4 | 5 | 1314986098.45 | -13901.55 | 0.052 | 1314986132.8125 | 48.828125 | 0 | 31.224 | 31.635 | 0 | checked | Uzka prerusovana cara; pozadovany pocet pulzu splnuje periodu PPS. | city
250926/1089_124000_250926.raw | E:\iq_data\mesto_1_2509_3009_2026\250926\1089_124000_250926.raw | 1089_124000_250926.raw | 250926 | 25-Sep-2026 12:40:00 | 1 | 2400206848 | 5 | 1 | present | 1 | 5 | 5 | 1314986058.39 | -13941.61 | 0.03 | 1314986035.15625 | 48.828125 | 0.035 | 30.871 | 30.413 | 0 | checked | Uzka prerusovana cara; pozadovany pocet pulzu splnuje periodu PPS. | city
250926/1090_125000_250926.raw | E:\iq_data\mesto_1_2509_3009_2026\250926\1090_125000_250926.raw | 1090_125000_250926.raw | 250926 | 25-Sep-2026 12:50:00 | 1 | 2399158272 | 5 | 1 | present | 1 | 5 | 5 | 1314985993.064 | -14006.936 | 0.223 | 1314985986.32813 | 48.828125 | 0.025 | 32.496 | 31.257 | 0 | checked | Uzka prerusovana cara; pozadovany pocet pulzu splnuje periodu PPS. | city
250926/1091_130000_250926.raw | E:\iq_data\mesto_1_2509_3009_2026\250926\1091_130000_250926.raw | 1091_130000_250926.raw | 250926 | 25-Sep-2026 13:00:00 | 1 | 2399158272 | 5 | 1 | present | 1 | 4 | 4 | 1314985957.692 | -14042.308 | 0.072 | 1314985937.5 | 48.828125 | 0.005 | 32.928 | 31.585 | 0 | checked | Uzka prerusovana cara; pozadovany pocet pulzu splnuje periodu PPS. | city
250926/1092_131000_250926.raw | E:\iq_data\mesto_1_2509_3009_2026\250926\1092_131000_250926.raw | 1092_131000_250926.raw | 250926 | 25-Sep-2026 13:10:00 | 1 | 2399158272 | 5 | 1 | present | 1 | 4 | 5 | 1314985934.534 | -14065.466 | 0.141 | 1314985937.5 | 48.828125 | 0 | 29.969 | 31.219 | 0 | checked | Uzka prerusovana cara; pozadovany pocet pulzu splnuje periodu PPS. | city
250926/1093_132000_250926.raw | E:\iq_data\mesto_1_2509_3009_2026\250926\1093_132000_250926.raw | 1093_132000_250926.raw | 250926 | 25-Sep-2026 13:20:00 | 1 | 2399158272 | 5 | 1 | present | 1 | 4 | 5 | 1314985903.461 | -14096.539 | 0.04 | 1314985888.67188 | 48.828125 | 0 | 30.269 | 29.415 | 0 | checked | Uzka prerusovana cara; pozadovany pocet pulzu splnuje periodu PPS. | city
250926/1094_133000_250926.raw | E:\iq_data\mesto_1_2509_3009_2026\250926\1094_133000_250926.raw | 1094_133000_250926.raw | 250926 | 25-Sep-2026 13:30:00 | 1 | 2399158272 | 5 | 1 | present | 1 | 4 | 4 | 1314985878.981 | -14121.019 | 0.277 | 1314985888.67188 | 48.828125 | 0 | 33.073 | 32.124 | 0 | checked | Uzka prerusovana cara; pozadovany pocet pulzu splnuje periodu PPS. | city
250926/1095_134000_250926.raw | E:\iq_data\mesto_1_2509_3009_2026\250926\1095_134000_250926.raw | 1095_134000_250926.raw | 250926 | 25-Sep-2026 13:40:00 | 1 | 2399158272 | 5 | 1 | present | 1 | 4 | 4 | 1314985812.883 | -14187.117 | 0.156 | 1314985791.01563 | 48.828125 | 0.005 | 31.308 | 32.147 | 0 | checked | Uzka prerusovana cara; pozadovany pocet pulzu splnuje periodu PPS. | city
250926/1096_135000_250926.raw | E:\iq_data\mesto_1_2509_3009_2026\250926\1096_135000_250926.raw | 1096_135000_250926.raw | 250926 | 25-Sep-2026 13:50:00 | 1 | 2399158272 | 5 | 1 | present | 1 | 4 | 5 | 1314985756.641 | -14243.359 | 0.033 | 1314985742.1875 | 48.828125 | 0 | 32.534 | 32.474 | 0 | checked | Uzka prerusovana cara; pozadovany pocet pulzu splnuje periodu PPS. | city
250926/1097_140000_250926.raw | E:\iq_data\mesto_1_2509_3009_2026\250926\1097_140000_250926.raw | 1097_140000_250926.raw | 250926 | 25-Sep-2026 14:00:00 | 1 | 2399158272 | 5 | 1 | present | 1 | 5 | 5 | 1314985746.063 | -14253.937 | 0.127 | 1314985742.1875 | 48.828125 | 0.03 | 31.336 | 30.504 | 0 | checked | Uzka prerusovana cara; pozadovany pocet pulzu splnuje periodu PPS. | city
250926/1098_141000_250926.raw | E:\iq_data\mesto_1_2509_3009_2026\250926\1098_141000_250926.raw | 1098_141000_250926.raw | 250926 | 25-Sep-2026 14:10:00 | 1 | 2399158272 | 5 | 1 | present | 1 | 5 | 5 | 1314985765.86 | -14234.14 | 0.116 | 1314985791.01563 | 48.828125 | 0.035 | 28.744 | 29.12 | 0 | checked | Uzka prerusovana cara; pozadovany pocet pulzu splnuje periodu PPS. | city
250926/1099_142000_250926.raw | E:\iq_data\mesto_1_2509_3009_2026\250926\1099_142000_250926.raw | 1099_142000_250926.raw | 250926 | 25-Sep-2026 14:20:00 | 1 | 2399158272 | 5 | 1 | present | 1 | 4 | 4 | 1314985805.698 | -14194.302 | 0.191 | 1314985791.01563 | 48.828125 | 0 | 31.443 | 31.299 | 0 | checked | Uzka prerusovana cara; pozadovany pocet pulzu splnuje periodu PPS. | city
250926/1100_143000_250926.raw | E:\iq_data\mesto_1_2509_3009_2026\250926\1100_143000_250926.raw | 1100_143000_250926.raw | 250926 | 25-Sep-2026 14:30:00 | 1 | 2399158272 | 5 | 1 | present | 1 | 4 | 4 | 1314985860.91 | -14139.09 | 0.276 | 1314985888.67188 | 48.828125 | 0 | 31.944 | 31.141 | 0 | checked | Uzka prerusovana cara; pozadovany pocet pulzu splnuje periodu PPS. | city
250926/1101_144000_250926.raw | E:\iq_data\mesto_1_2509_3009_2026\250926\1101_144000_250926.raw | 1101_144000_250926.raw | 250926 | 25-Sep-2026 14:40:00 | 1 | 2399158272 | 5 | 1 | present | 1 | 4 | 5 | 1314985927.659 | -14072.341 | 0.102 | 1314985937.5 | 48.828125 | 0 | 30.101 | 29.934 | 0 | checked | Uzka prerusovana cara; pozadovany pocet pulzu splnuje periodu PPS. | city
250926/1102_145000_250926.raw | E:\iq_data\mesto_1_2509_3009_2026\250926\1102_145000_250926.raw | 1102_145000_250926.raw | 250926 | 25-Sep-2026 14:50:00 | 1 | 2399158272 | 5 | 1 | present | 1 | 5 | 5 | 1314985988.883 | -14011.117 | 0.279 | 1314985986.32813 | 48.828125 | 0.025 | 31.368 | 31.191 | 0 | checked | Uzka prerusovana cara; pozadovany pocet pulzu splnuje periodu PPS. | city
250926/1103_150000_250926.raw | E:\iq_data\mesto_1_2509_3009_2026\250926\1103_150000_250926.raw | 1103_150000_250926.raw | 250926 | 25-Sep-2026 15:00:00 | 1 | 2399158272 | 5 | 1 | present | 1 | 4 | 4 | 1314986041.093 | -13958.907 | 0.285 | 1314986035.15625 | 48.828125 | 0.005 | 31.406 | 30.648 | 0 | checked | Uzka prerusovana cara; pozadovany pocet pulzu splnuje periodu PPS. | city
250926/1104_151000_250926.raw | E:\iq_data\mesto_1_2509_3009_2026\250926\1104_151000_250926.raw | 1104_151000_250926.raw | 250926 | 25-Sep-2026 15:10:00 | 1 | 2399158272 | 5 | 1 | present | 1 | 4 | 4 | 1314986087.76 | -13912.24 | 0.152 | 1314986083.98438 | 48.828125 | 0 | 30.044 | 30.074 | 0 | checked | Uzka prerusovana cara; pozadovany pocet pulzu splnuje periodu PPS. | city
250926/1105_152000_250926.raw | E:\iq_data\mesto_1_2509_3009_2026\250926\1105_152000_250926.raw | 1105_152000_250926.raw | 250926 | 25-Sep-2026 15:20:00 | 1 | 2400272384 | 5 | 1 | present | 1 | 4 | 5 | 1314986141.446 | -13858.554 | 0.162 | 1314986132.8125 | 48.828125 | 0 | 29.999 | 30.497 | 0 | checked | Uzka prerusovana cara; pozadovany pocet pulzu splnuje periodu PPS. | city
250926/1106_153000_250926.raw | E:\iq_data\mesto_1_2509_3009_2026\250926\1106_153000_250926.raw | 1106_153000_250926.raw | 250926 | 25-Sep-2026 15:30:00 | 1 | 2399158272 | 5 | 1 | present | 1 | 4 | 5 | 1314986208.355 | -13791.645 | 0.109 | 1314986181.64063 | 48.828125 | 0 | 32.38 | 31.402 | 0 | checked | Uzka prerusovana cara; pozadovany pocet pulzu splnuje periodu PPS. | city
250926/1107_154000_250926.raw | E:\iq_data\mesto_1_2509_3009_2026\250926\1107_154000_250926.raw | 1107_154000_250926.raw | 250926 | 25-Sep-2026 15:40:00 | 1 | 2399158272 | 5 | 1 | present | 1 | 4 | 5 | 1314986272.085 | -13727.915 | 0.16 | 1314986279.29688 | 48.828125 | 0 | 30.443 | 29.896 | 0 | checked | Uzka prerusovana cara; pozadovany pocet pulzu splnuje periodu PPS. | city
250926/1108_155000_250926.raw | E:\iq_data\mesto_1_2509_3009_2026\250926\1108_155000_250926.raw | 1108_155000_250926.raw | 250926 | 25-Sep-2026 15:50:00 | 1 | 2399158272 | 5 | 1 | present | 1 | 5 | 5 | 1314986333.365 | -13666.635 | 0.306 | 1314986328.125 | 48.828125 | 0.03 | 32.848 | 32.288 | 0 | checked | Uzka prerusovana cara; pozadovany pocet pulzu splnuje periodu PPS. | city
250926/1109_160000_250926.raw | E:\iq_data\mesto_1_2509_3009_2026\250926\1109_160000_250926.raw | 1109_160000_250926.raw | 250926 | 25-Sep-2026 16:00:00 | 1 | 2399158272 | 5 | 1 | present | 1 | 4 | 4 | 1314986412.608 | -13587.392 | 0.04 | 1314986425.78125 | 48.828125 | 0 | 28.571 | 29.078 | 0 | checked | Uzka prerusovana cara; pozadovany pocet pulzu splnuje periodu PPS. | city
250926/1110_161000_250926.raw | E:\iq_data\mesto_1_2509_3009_2026\250926\1110_161000_250926.raw | 1110_161000_250926.raw | 250926 | 25-Sep-2026 16:10:00 | 1 | 2399158272 | 5 | 1 | present | 1 | 4 | 4 | 1314986460.772 | -13539.228 | 0.14 | 1314986474.60938 | 48.828125 | 0.005 | 33.378 | 31.493 | 0 | checked | Uzka prerusovana cara; pozadovany pocet pulzu splnuje periodu PPS. | city
250926/1111_162000_250926.raw | E:\iq_data\mesto_1_2509_3009_2026\250926\1111_162000_250926.raw | 1111_162000_250926.raw | 250926 | 25-Sep-2026 16:20:00 | 1 | 2399158272 | 5 | 1 | present | 1 | 4 | 5 | 1314986486.902 | -13513.098 | 0.127 | 1314986474.60938 | 48.828125 | 0 | 33.866 | 31.998 | 0 | checked | Uzka prerusovana cara; pozadovany pocet pulzu splnuje periodu PPS. | city
250926/1112_163000_250926.raw | E:\iq_data\mesto_1_2509_3009_2026\250926\1112_163000_250926.raw | 1112_163000_250926.raw | 250926 | 25-Sep-2026 16:30:00 | 1 | 2399158272 | 5 | 1 | present | 1 | 4 | 5 | 1314986519.371 | -13480.629 | 0.132 | 1314986523.4375 | 48.828125 | 0 | 32.548 | 31.271 | 0 | checked | Uzka prerusovana cara; pozadovany pocet pulzu splnuje periodu PPS. | city
250926/1113_164000_250926.raw | E:\iq_data\mesto_1_2509_3009_2026\250926\1113_164000_250926.raw | 1113_164000_250926.raw | 250926 | 25-Sep-2026 16:40:00 | 1 | 2400272384 | 5 | 1 | present | 1 | 5 | 5 | 1314986553.844 | -13446.156 | 0.062 | 1314986572.26563 | 48.828125 | 0.03 | 33.329 | 31.177 | 0 | checked | Uzka prerusovana cara; pozadovany pocet pulzu splnuje periodu PPS. | city
250926/1114_165000_250926.raw | E:\iq_data\mesto_1_2509_3009_2026\250926\1114_165000_250926.raw | 1114_165000_250926.raw | 250926 | 25-Sep-2026 16:50:00 | 1 | 2399158272 | 5 | 1 | present | 1 | 4 | 5 | 1314986593.957 | -13406.043 | 0.012 | 1314986621.09375 | 48.828125 | 0 | 28.229 | 28.672 | 0 | checked | Uzka prerusovana cara; pozadovany pocet pulzu splnuje periodu PPS. | city
250926/1115_170000_250926.raw | E:\iq_data\mesto_1_2509_3009_2026\250926\1115_170000_250926.raw | 1115_170000_250926.raw | 250926 | 25-Sep-2026 17:00:00 | 1 | 2399158272 | 5 | 1 | present | 1 | 5 | 5 | 1314986639.056 | -13360.944 | 0.08 | 1314986621.09375 | 48.828125 | 0.03 | 31.907 | 31.437 | 0 | checked | Uzka prerusovana cara; pozadovany pocet pulzu splnuje periodu PPS. | city
250926/1116_171000_250926.raw | E:\iq_data\mesto_1_2509_3009_2026\250926\1116_171000_250926.raw | 1116_171000_250926.raw | 250926 | 25-Sep-2026 17:10:00 | 1 | 2399158272 | 5 | 1 | present | 1 | 4 | 4 | 1314986678.779 | -13321.221 | 0.155 | 1314986669.92188 | 48.828125 | 0 | 33.168 | 32.396 | 0 | checked | Uzka prerusovana cara; pozadovany pocet pulzu splnuje periodu PPS. | city
250926/1117_172000_250926.raw | E:\iq_data\mesto_1_2509_3009_2026\250926\1117_172000_250926.raw | 1117_172000_250926.raw | 250926 | 25-Sep-2026 17:20:00 | 1 | 2399158272 | 5 | 1 | present | 1 | 4 | 5 | 1314986715.944 | -13284.056 | 0.046 | 1314986718.75 | 48.828125 | 0 | 32.078 | 32.93 | 0 | checked | Uzka prerusovana cara; pozadovany pocet pulzu splnuje periodu PPS. | city
250926/1118_173000_250926.raw | E:\iq_data\mesto_1_2509_3009_2026\250926\1118_173000_250926.raw | 1118_173000_250926.raw | 250926 | 25-Sep-2026 17:30:00 | 1 | 2399158272 | 5 | 1 | present | 1 | 4 | 5 | 1314986749.813 | -13250.187 | 0.076 | 1314986767.57813 | 48.828125 | 0 | 33.039 | 32.445 | 0 | checked | Uzka prerusovana cara; pozadovany pocet pulzu splnuje periodu PPS. | city
250926/1119_174000_250926.raw | E:\iq_data\mesto_1_2509_3009_2026\250926\1119_174000_250926.raw | 1119_174000_250926.raw | 250926 | 25-Sep-2026 17:40:00 | 1 | 2399158272 | 5 | 1 | present | 1 | 4 | 4 | 1314986801.12 | -13198.88 | 0.313 | 1314986816.40625 | 48.828125 | 0 | 27.993 | 27.078 | 0 | checked | Uzka prerusovana cara; pozadovany pocet pulzu splnuje periodu PPS. | city
250926/1120_175000_250926.raw | E:\iq_data\mesto_1_2509_3009_2026\250926\1120_175000_250926.raw | 1120_175000_250926.raw | 250926 | 25-Sep-2026 17:50:00 | 1 | 2399158272 | 5 | 1 | present | 1 | 4 | 5 | 1314986853.842 | -13146.158 | 0.016 | 1314986816.40625 | 48.828125 | 0 | 30.044 | 31.371 | 0 | checked | Uzka prerusovana cara; pozadovany pocet pulzu splnuje periodu PPS. | city
250926/1121_180000_250926.raw | E:\iq_data\mesto_1_2509_3009_2026\250926\1121_180000_250926.raw | 1121_180000_250926.raw | 250926 | 25-Sep-2026 18:00:00 | 1 | 2400272384 | 5 | 1 | present | 1 | 5 | 5 | 1314986912.739 | -13087.261 | 0.159 | 1314986914.0625 | 48.828125 | 0.03 | 32.014 | 31.671 | 0 | checked | Uzka prerusovana cara; pozadovany pocet pulzu splnuje periodu PPS. | city
250926/1122_181000_250926.raw | E:\iq_data\mesto_1_2509_3009_2026\250926\1122_181000_250926.raw | 1122_181000_250926.raw | 250926 | 25-Sep-2026 18:10:00 | 1 | 2399158272 | 5 | 1 | present | 1 | 4 | 5 | 1314986976.945 | -13023.055 | 0.044 | 1314986962.89063 | 48.828125 | 0 | 32.889 | 32.183 | 0 | checked | Uzka prerusovana cara; pozadovany pocet pulzu splnuje periodu PPS. | city
250926/1123_182000_250926.raw | E:\iq_data\mesto_1_2509_3009_2026\250926\1123_182000_250926.raw | 1123_182000_250926.raw | 250926 | 25-Sep-2026 18:20:00 | 1 | 2399158272 | 5 | 1 | present | 1 | 5 | 5 | 1314987041.879 | -12958.121 | 0.14 | 1314987060.54688 | 48.828125 | 0.035 | 28.778 | 28.491 | 0 | checked | Uzka prerusovana cara; pozadovany pocet pulzu splnuje periodu PPS. | city
250926/1124_183000_250926.raw | E:\iq_data\mesto_1_2509_3009_2026\250926\1124_183000_250926.raw | 1124_183000_250926.raw | 250926 | 25-Sep-2026 18:30:00 | 1 | 2399158272 | 5 | 1 | present | 1 | 4 | 4 | 1314987094.632 | -12905.368 | 0.025 | 1314987109.375 | 48.828125 | 0 | 32.648 | 32.938 | 0 | checked | Uzka prerusovana cara; pozadovany pocet pulzu splnuje periodu PPS. | city
250926/1125_184000_250926.raw | E:\iq_data\mesto_1_2509_3009_2026\250926\1125_184000_250926.raw | 1125_184000_250926.raw | 250926 | 25-Sep-2026 18:40:00 | 1 | 2399158272 | 5 | 1 | present | 1 | 4 | 4 | 1314987145.224 | -12854.776 | 0.171 | 1314987158.20313 | 48.828125 | 0 | 34.216 | 33.9 | 0 | checked | Uzka prerusovana cara; pozadovany pocet pulzu splnuje periodu PPS. | city
250926/1126_185000_250926.raw | E:\iq_data\mesto_1_2509_3009_2026\250926\1126_185000_250926.raw | 1126_185000_250926.raw | 250926 | 25-Sep-2026 18:50:00 | 1 | 2399158272 | 5 | 1 | present | 1 | 4 | 5 | 1314987210.077 | -12789.923 | 0.279 | 1314987207.03125 | 48.828125 | 0 | 33.561 | 32.604 | 0 | checked | Uzka prerusovana cara; pozadovany pocet pulzu splnuje periodu PPS. | city
250926/1127_190000_250926.raw | E:\iq_data\mesto_1_2509_3009_2026\250926\1127_190000_250926.raw | 1127_190000_250926.raw | 250926 | 25-Sep-2026 19:00:00 | 1 | 2399158272 | 5 | 1 | present | 1 | 5 | 5 | 1314987269.902 | -12730.098 | 0.207 | 1314987255.85938 | 48.828125 | 0.035 | 33.914 | 33.213 | 0 | checked | Uzka prerusovana cara; pozadovany pocet pulzu splnuje periodu PPS. | city
250926/1128_191000_250926.raw | E:\iq_data\mesto_1_2509_3009_2026\250926\1128_191000_250926.raw | 1128_191000_250926.raw | 250926 | 25-Sep-2026 19:10:00 | 1 | 2399158272 | 5 | 1 | present | 1 | 4 | 4 | 1314987335.107 | -12664.893 | 0.09 | 1314987353.51563 | 48.828125 | 0 | 34.342 | 33.635 | 0 | checked | Uzka prerusovana cara; pozadovany pocet pulzu splnuje periodu PPS. | city
250926/1129_192000_250926.raw | E:\iq_data\mesto_1_2509_3009_2026\250926\1129_192000_250926.raw | 1129_192000_250926.raw | 250926 | 25-Sep-2026 19:20:00 | 1 | 2400206848 | 5 | 1 | present | 1 | 4 | 4 | 1314987399.995 | -12600.005 | 0.142 | 1314987402.34375 | 48.828125 | 0 | 32.791 | 32.825 | 0 | checked | Uzka prerusovana cara; pozadovany pocet pulzu splnuje periodu PPS. | city
250926/1130_193000_250926.raw | E:\iq_data\mesto_1_2509_3009_2026\250926\1130_193000_250926.raw | 1130_193000_250926.raw | 250926 | 25-Sep-2026 19:30:00 | 1 | 2399158272 | 5 | 1 | present | 1 | 4 | 4 | 1314987460.644 | -12539.356 | 0.13 | 1314987451.17188 | 48.828125 | 0 | 33.737 | 33.073 | 0 | checked | Uzka prerusovana cara; pozadovany pocet pulzu splnuje periodu PPS. | city
250926/1131_194000_250926.raw | E:\iq_data\mesto_1_2509_3009_2026\250926\1131_194000_250926.raw | 1131_194000_250926.raw | 250926 | 25-Sep-2026 19:40:00 | 1 | 2399158272 | 5 | 1 | present | 1 | 4 | 5 | 1314987519.719 | -12480.281 | 0.148 | 1314987548.82813 | 48.828125 | 0 | 34.033 | 32.352 | 0 | checked | Uzka prerusovana cara; pozadovany pocet pulzu splnuje periodu PPS. | city
250926/1132_195000_250926.raw | E:\iq_data\mesto_1_2509_3009_2026\250926\1132_195000_250926.raw | 1132_195000_250926.raw | 250926 | 25-Sep-2026 19:50:00 | 1 | 2399158272 | 5 | 1 | present | 1 | 5 | 5 | 1314987592.648 | -12407.352 | 0.164 | 1314987597.65625 | 48.828125 | 0.035 | 33.53 | 33.571 | 0 | checked | Uzka prerusovana cara; pozadovany pocet pulzu splnuje periodu PPS. | city
250926/1133_200000_250926.raw | E:\iq_data\mesto_1_2509_3009_2026\250926\1133_200000_250926.raw | 1133_200000_250926.raw | 250926 | 25-Sep-2026 20:00:00 | 1 | 2399158272 | 5 | 1 | present | 1 | 4 | 4 | 1314987679.088 | -12320.912 | 0.212 | 1314987695.3125 | 48.828125 | 0 | 31.589 | 32.107 | 0 | checked | Uzka prerusovana cara; pozadovany pocet pulzu splnuje periodu PPS. | city
250926/1134_201000_250926.raw | E:\iq_data\mesto_1_2509_3009_2026\250926\1134_201000_250926.raw | 1134_201000_250926.raw | 250926 | 25-Sep-2026 20:10:00 | 1 | 2399158272 | 5 | 1 | present | 1 | 4 | 5 | 1314987765.13 | -12234.87 | 0.162 | 1314987744.14063 | 48.828125 | 0 | 32.62 | 33.052 | 0 | checked | Uzka prerusovana cara; pozadovany pocet pulzu splnuje periodu PPS. | city
250926/1135_202000_250926.raw | E:\iq_data\mesto_1_2509_3009_2026\250926\1135_202000_250926.raw | 1135_202000_250926.raw | 250926 | 25-Sep-2026 20:20:00 | 1 | 2399158272 | 5 | 1 | present | 1 | 4 | 5 | 1314987844.766 | -12155.234 | 0.139 | 1314987841.79688 | 48.828125 | 0 | 32.341 | 32.026 | 0 | checked | Uzka prerusovana cara; pozadovany pocet pulzu splnuje periodu PPS. | city
250926/1136_203000_250926.raw | E:\iq_data\mesto_1_2509_3009_2026\250926\1136_203000_250926.raw | 1136_203000_250926.raw | 250926 | 25-Sep-2026 20:30:00 | 1 | 2399158272 | 5 | 1 | present | 1 | 4 | 4 | 1314987917.497 | -12082.503 | 0.036 | 1314987939.45313 | 48.828125 | 0 | 31.301 | 32.562 | 0 | checked | Uzka prerusovana cara; pozadovany pocet pulzu splnuje periodu PPS. | city
250926/1137_204000_250926.raw | E:\iq_data\mesto_1_2509_3009_2026\250926\1137_204000_250926.raw | 1137_204000_250926.raw | 250926 | 25-Sep-2026 20:40:00 | 1 | 2400239616 | 5 | 1 | present | 1 | 4 | 4 | 1314987977.53 | -12022.47 | 0.023 | 1314987988.28125 | 48.828125 | 0 | 30.423 | 31.59 | 0 | checked | Uzka prerusovana cara; pozadovany pocet pulzu splnuje periodu PPS. | city
250926/1138_205000_250926.raw | E:\iq_data\mesto_1_2509_3009_2026\250926\1138_205000_250926.raw | 1138_205000_250926.raw | 250926 | 25-Sep-2026 20:50:00 | 1 | 2399158272 | 5 | 1 | present | 1 | 4 | 5 | 1314988035.749 | -11964.251 | 0.175 | 1314988037.10938 | 48.828125 | 0 | 32.185 | 30.986 | 0 | checked | Uzka prerusovana cara; pozadovany pocet pulzu splnuje periodu PPS. | city
250926/1139_210000_250926.raw | E:\iq_data\mesto_1_2509_3009_2026\250926\1139_210000_250926.raw | 1139_210000_250926.raw | 250926 | 25-Sep-2026 21:00:00 | 1 | 2399158272 | 5 | 1 | present | 1 | 5 | 5 | 1314988096.289 | -11903.711 | 0.118 | 1314988085.9375 | 48.828125 | 0.035 | 28.882 | 28.395 | 0 | checked | Uzka prerusovana cara; pozadovany pocet pulzu splnuje periodu PPS. | city
250926/1140_211000_250926.raw | E:\iq_data\mesto_1_2509_3009_2026\250926\1140_211000_250926.raw | 1140_211000_250926.raw | 250926 | 25-Sep-2026 21:10:00 | 1 | 2399158272 | 5 | 1 | present | 1 | 4 | 4 | 1314988145.301 | -11854.699 | 0.075 | 1314988134.76563 | 48.828125 | 0 | 29.56 | 29.986 | 0 | checked | Uzka prerusovana cara; pozadovany pocet pulzu splnuje periodu PPS. | city
250926/1141_212000_250926.raw | E:\iq_data\mesto_1_2509_3009_2026\250926\1141_212000_250926.raw | 1141_212000_250926.raw | 250926 | 25-Sep-2026 21:20:00 | 1 | 2399158272 | 5 | 1 | present | 1 | 4 | 4 | 1314988192.925 | -11807.075 | 0.042 | 1314988183.59375 | 48.828125 | 0 | 33.612 | 33.278 | 0 | checked | Uzka prerusovana cara; pozadovany pocet pulzu splnuje periodu PPS. | city
250926/1142_213000_250926.raw | E:\iq_data\mesto_1_2509_3009_2026\250926\1142_213000_250926.raw | 1142_213000_250926.raw | 250926 | 25-Sep-2026 21:30:00 | 1 | 2399158272 | 5 | 1 | present | 1 | 4 | 4 | 1314988242.748 | -11757.252 | 0.125 | 1314988232.42188 | 48.828125 | 0 | 33.695 | 32.751 | 0 | checked | Uzka prerusovana cara; pozadovany pocet pulzu splnuje periodu PPS. | city
250926/1143_214000_250926.raw | E:\iq_data\mesto_1_2509_3009_2026\250926\1143_214000_250926.raw | 1143_214000_250926.raw | 250926 | 25-Sep-2026 21:40:00 | 1 | 2399158272 | 5 | 1 | present | 1 | 4 | 5 | 1314988308.284 | -11691.716 | 0.222 | 1314988281.25 | 48.828125 | 0 | 33.669 | 32.591 | 0 | checked | Uzka prerusovana cara; pozadovany pocet pulzu splnuje periodu PPS. | city
250926/1144_215000_250926.raw | E:\iq_data\mesto_1_2509_3009_2026\250926\1144_215000_250926.raw | 1144_215000_250926.raw | 250926 | 25-Sep-2026 21:50:00 | 1 | 2399158272 | 5 | 1 | present | 1 | 5 | 5 | 1314988376.583 | -11623.417 | 0.158 | 1314988378.90625 | 48.828125 | 0.035 | 34.805 | 34.404 | 0 | checked | Uzka prerusovana cara; pozadovany pocet pulzu splnuje periodu PPS. | city
250926/1145_220000_250926.raw | E:\iq_data\mesto_1_2509_3009_2026\250926\1145_220000_250926.raw | 1145_220000_250926.raw | 250926 | 25-Sep-2026 22:00:00 | 1 | 2400206848 | 5 | 1 | present | 1 | 4 | 4 | 1314988435.445 | -11564.555 | 0.163 | 1314988427.73438 | 48.828125 | 0 | 33.3 | 33.057 | 0 | checked | Uzka prerusovana cara; pozadovany pocet pulzu splnuje periodu PPS. | city
250926/1146_221000_250926.raw | E:\iq_data\mesto_1_2509_3009_2026\250926\1146_221000_250926.raw | 1146_221000_250926.raw | 250926 | 25-Sep-2026 22:10:00 | 1 | 2399158272 | 5 | 1 | present | 1 | 4 | 4 | 1314988490.157 | -11509.843 | 0.089 | 1314988476.5625 | 48.828125 | 0 | 34.326 | 33.83 | 0 | checked | Uzka prerusovana cara; pozadovany pocet pulzu splnuje periodu PPS. | city
250926/1147_222000_250926.raw | E:\iq_data\mesto_1_2509_3009_2026\250926\1147_222000_250926.raw | 1147_222000_250926.raw | 250926 | 25-Sep-2026 22:20:00 | 1 | 2399158272 | 5 | 1 | present | 1 | 4 | 4 | 1314988528.602 | -11471.398 | 0.129 | 1314988525.39063 | 48.828125 | 0 | 33.765 | 33.277 | 0 | checked | Uzka prerusovana cara; pozadovany pocet pulzu splnuje periodu PPS. | city
250926/1148_223000_250926.raw | E:\iq_data\mesto_1_2509_3009_2026\250926\1148_223000_250926.raw | 1148_223000_250926.raw | 250926 | 25-Sep-2026 22:30:00 | 1 | 2399158272 | 5 | 1 | present | 1 | 4 | 5 | 1314988564.959 | -11435.041 | 0.144 | 1314988574.21875 | 48.828125 | 0 | 33.279 | 33.047 | 0 | checked | Uzka prerusovana cara; pozadovany pocet pulzu splnuje periodu PPS. | city
250926/1149_224000_250926.raw | E:\iq_data\mesto_1_2509_3009_2026\250926\1149_224000_250926.raw | 1149_224000_250926.raw | 250926 | 25-Sep-2026 22:40:00 | 1 | 2399158272 | 5 | 1 | present | 1 | 4 | 5 | 1314988588.139 | -11411.861 | 0.083 | 1314988574.21875 | 48.828125 | 0 | 33.378 | 33.297 | 0 | checked | Uzka prerusovana cara; pozadovany pocet pulzu splnuje periodu PPS. | city
250926/1150_225000_250926.raw | E:\iq_data\mesto_1_2509_3009_2026\250926\1150_225000_250926.raw | 1150_225000_250926.raw | 250926 | 25-Sep-2026 22:50:00 | 1 | 2399158272 | 5 | 1 | present | 1 | 4 | 4 | 1314988615.74 | -11384.26 | 0.067 | 1314988623.04688 | 48.828125 | 0 | 32.477 | 33.309 | 0 | checked | Uzka prerusovana cara; pozadovany pocet pulzu splnuje periodu PPS. | city
250926/1151_230000_250926.raw | E:\iq_data\mesto_1_2509_3009_2026\250926\1151_230000_250926.raw | 1151_230000_250926.raw | 250926 | 25-Sep-2026 23:00:00 | 1 | 2399158272 | 5 | 1 | present | 1 | 4 | 4 | 1314988611.873 | -11388.127 | 0.055 | 1314988623.04688 | 48.828125 | 0 | 33.761 | 33.845 | 0 | checked | Uzka prerusovana cara; pozadovany pocet pulzu splnuje periodu PPS. | city
250926/1152_231000_250926.raw | E:\iq_data\mesto_1_2509_3009_2026\250926\1152_231000_250926.raw | 1152_231000_250926.raw | 250926 | 25-Sep-2026 23:10:00 | 1 | 2399158272 | 5 | 1 | present | 1 | 4 | 5 | 1314988626.423 | -11373.577 | 0.123 | 1314988623.04688 | 48.828125 | 0 | 34.268 | 33.508 | 0 | checked | Uzka prerusovana cara; pozadovany pocet pulzu splnuje periodu PPS. | city
250926/1153_232000_250926.raw | E:\iq_data\mesto_1_2509_3009_2026\250926\1153_232000_250926.raw | 1153_232000_250926.raw | 250926 | 25-Sep-2026 23:20:00 | 1 | 2400272384 | 5 | 1 | present | 1 | 5 | 5 | 1314988637.682 | -11362.318 | 0.062 | 1314988623.04688 | 48.828125 | 0.035 | 34.346 | 34.229 | 0 | checked | Uzka prerusovana cara; pozadovany pocet pulzu splnuje periodu PPS. | city
250926/1154_233000_250926.raw | E:\iq_data\mesto_1_2509_3009_2026\250926\1154_233000_250926.raw | 1154_233000_250926.raw | 250926 | 25-Sep-2026 23:30:00 | 1 | 2399158272 | 5 | 1 | present | 1 | 4 | 5 | 1314988653.424 | -11346.576 | 0.1 | 1314988671.875 | 48.828125 | 0 | 33.159 | 33.795 | 0 | checked | Uzka prerusovana cara; pozadovany pocet pulzu splnuje periodu PPS. | city
250926/1155_234000_250926.raw | E:\iq_data\mesto_1_2509_3009_2026\250926\1155_234000_250926.raw | 1155_234000_250926.raw | 250926 | 25-Sep-2026 23:40:00 | 1 | 2399158272 | 5 | 1 | present | 1 | 4 | 5 | 1314988677.349 | -11322.651 | 0.105 | 1314988671.875 | 48.828125 | 0 | 33.911 | 33.247 | 0 | checked | Uzka prerusovana cara; pozadovany pocet pulzu splnuje periodu PPS. | city
250926/1156_235000_250926.raw | E:\iq_data\mesto_1_2509_3009_2026\250926\1156_235000_250926.raw | 1156_235000_250926.raw | 250926 | 25-Sep-2026 23:50:00 | 1 | 2399158272 | 5 | 1 | present | 1 | 4 | 4 | 1314988685.213 | -11314.787 | 0.042 | 1314988671.875 | 48.828125 | 0.005 | 34.151 | 34.368 | 0 | checked | Uzka prerusovana cara; pozadovany pocet pulzu splnuje periodu PPS. | city
260926/1157_000000_260926.raw | E:\iq_data\mesto_1_2509_3009_2026\260926\1157_000000_260926.raw | 1157_000000_260926.raw | 260926 | 26-Sep-2026 00:00:00 | 1 | 2399158272 | 5 | 1 | present | 1 | 4 | 5 | 1314988702.092 | -11297.908 | 0.045 | 1314988720.70313 | 48.828125 | 0.005 | 35.039 | 35.012 | 0 | checked | Uzka prerusovana cara; pozadovany pocet pulzu splnuje periodu PPS. | city
260926/1158_001000_260926.raw | E:\iq_data\mesto_1_2509_3009_2026\260926\1158_001000_260926.raw | 1158_001000_260926.raw | 260926 | 26-Sep-2026 00:10:00 | 1 | 2399158272 | 5 | 1 | present | 1 | 4 | 5 | 1314988728.803 | -11271.197 | 0.11 | 1314988720.70313 | 48.828125 | 0 | 34.176 | 33.744 | 0 | checked | Uzka prerusovana cara; pozadovany pocet pulzu splnuje periodu PPS. | city
260926/1159_002000_260926.raw | E:\iq_data\mesto_1_2509_3009_2026\260926\1159_002000_260926.raw | 1159_002000_260926.raw | 260926 | 26-Sep-2026 00:20:00 | 1 | 2399158272 | 5 | 1 | present | 1 | 5 | 5 | 1314988752.478 | -11247.522 | 0.168 | 1314988769.53125 | 48.828125 | 0.035 | 35.516 | 34.642 | 0 | checked | Uzka prerusovana cara; pozadovany pocet pulzu splnuje periodu PPS. | city
260926/1160_003000_260926.raw | E:\iq_data\mesto_1_2509_3009_2026\260926\1160_003000_260926.raw | 1160_003000_260926.raw | 260926 | 26-Sep-2026 00:30:00 | 1 | 2399158272 | 5 | 1 | present | 1 | 4 | 4 | 1314988805.543 | -11194.457 | 0.155 | 1314988818.35938 | 48.828125 | 0 | 35.451 | 35.233 | 0 | checked | Uzka prerusovana cara; pozadovany pocet pulzu splnuje periodu PPS. | city
260926/1161_004000_260926.raw | E:\iq_data\mesto_1_2509_3009_2026\260926\1161_004000_260926.raw | 1161_004000_260926.raw | 260926 | 26-Sep-2026 00:40:00 | 1 | 2399158272 | 5 | 1 | present | 1 | 4 | 4 | 1314988837.613 | -11162.387 | 0.046 | 1314988818.35938 | 48.828125 | 0 | 36.113 | 34.743 | 0 | checked | Uzka prerusovana cara; pozadovany pocet pulzu splnuje periodu PPS. | city
260926/1162_005000_260926.raw | E:\iq_data\mesto_1_2509_3009_2026\260926\1162_005000_260926.raw | 1162_005000_260926.raw | 260926 | 26-Sep-2026 00:50:00 | 1 | 2399158272 | 5 | 1 | present | 1 | 4 | 5 | 1314988871.589 | -11128.411 | 0.08 | 1314988867.1875 | 48.828125 | 0 | 36.334 | 35.338 | 0 | checked | Uzka prerusovana cara; pozadovany pocet pulzu splnuje periodu PPS. | city
260926/1163_010000_260926.raw | E:\iq_data\mesto_1_2509_3009_2026\260926\1163_010000_260926.raw | 1163_010000_260926.raw | 260926 | 26-Sep-2026 01:00:00 | 1 | 2399158272 | 5 | 1 | present | 1 | 4 | 5 | 1314988876.238 | -11123.762 | 0.032 | 1314988867.1875 | 48.828125 | 0 | 35.883 | 35.084 | 0 | checked | Uzka prerusovana cara; pozadovany pocet pulzu splnuje periodu PPS. | city
260926/1164_011000_260926.raw | E:\iq_data\mesto_1_2509_3009_2026\260926\1164_011000_260926.raw | 1164_011000_260926.raw | 260926 | 26-Sep-2026 01:10:00 | 1 | 2399158272 | 5 | 1 | present | 1 | 5 | 5 | 1314988898.642 | -11101.358 | 0.028 | 1314988916.01563 | 48.828125 | 0.03 | 35.914 | 35.297 | 0 | checked | Uzka prerusovana cara; pozadovany pocet pulzu splnuje periodu PPS. | city
260926/1165_012000_260926.raw | E:\iq_data\mesto_1_2509_3009_2026\260926\1165_012000_260926.raw | 1165_012000_260926.raw | 260926 | 26-Sep-2026 01:20:00 | 1 | 2396454912 | 5 | 1 | present | 1 | 4 | 4 | 1314988907.122 | -11092.878 | 0.07 | 1314988916.01563 | 48.828125 | 0 | 35.911 | 35.076 | 0 | checked | Uzka prerusovana cara; pozadovany pocet pulzu splnuje periodu PPS. | city
260926/1166_013000_260926.raw | E:\iq_data\mesto_1_2509_3009_2026\260926\1166_013000_260926.raw | 1166_013000_260926.raw | 260926 | 26-Sep-2026 01:30:00 | 1 | 2399158272 | 5 | 1 | present | 1 | 4 | 5 | 1314988922.721 | -11077.279 | 0.087 | 1314988916.01563 | 48.828125 | 0 | 36.111 | 35.387 | 0 | checked | Uzka prerusovana cara; pozadovany pocet pulzu splnuje periodu PPS. | city
260926/1167_014000_260926.raw | E:\iq_data\mesto_1_2509_3009_2026\260926\1167_014000_260926.raw | 1167_014000_260926.raw | 260926 | 26-Sep-2026 01:40:00 | 1 | 2399158272 | 5 | 1 | present | 1 | 4 | 5 | 1314988945.399 | -11054.601 | 0.051 | 1314988964.84375 | 48.828125 | 0 | 36.076 | 35.391 | 0 | checked | Uzka prerusovana cara; pozadovany pocet pulzu splnuje periodu PPS. | city
260926/1168_015000_260926.raw | E:\iq_data\mesto_1_2509_3009_2026\260926\1168_015000_260926.raw | 1168_015000_260926.raw | 260926 | 26-Sep-2026 01:50:00 | 1 | 2399158272 | 5 | 1 | present | 1 | 4 | 4 | 1314988958.486 | -11041.514 | 0.072 | 1314988964.84375 | 48.828125 | 0 | 36.362 | 34.882 | 0 | checked | Uzka prerusovana cara; pozadovany pocet pulzu splnuje periodu PPS. | city
260926/1169_020000_260926.raw | E:\iq_data\mesto_1_2509_3009_2026\260926\1169_020000_260926.raw | 1169_020000_260926.raw | 260926 | 26-Sep-2026 02:00:00 | 1 | 2399158272 | 5 | 1 | present | 1 | 4 | 4 | 1314988961.18 | -11038.82 | 0.079 | 1314988964.84375 | 48.828125 | 0 | 36.623 | 35.912 | 0 | checked | Uzka prerusovana cara; pozadovany pocet pulzu splnuje periodu PPS. | city
260926/1170_021000_260926.raw | E:\iq_data\mesto_1_2509_3009_2026\260926\1170_021000_260926.raw | 1170_021000_260926.raw | 260926 | 26-Sep-2026 02:10:00 | 1 | 2399158272 | 5 | 1 | present | 1 | 4 | 5 | 1314988987.67 | -11012.33 | 0.044 | 1314989013.67188 | 48.828125 | 0.005 | 34.711 | 34.327 | 0 | checked | Uzka prerusovana cara; pozadovany pocet pulzu splnuje periodu PPS. | city
260926/1171_022000_260926.raw | E:\iq_data\mesto_1_2509_3009_2026\260926\1171_022000_260926.raw | 1171_022000_260926.raw | 260926 | 26-Sep-2026 02:20:00 | 1 | 2399158272 | 5 | 1 | present | 1 | 5 | 5 | 1314989004.322 | -10995.678 | 0.046 | 1314989013.67188 | 48.828125 | 0.035 | 35.086 | 34.656 | 0 | checked | Uzka prerusovana cara; pozadovany pocet pulzu splnuje periodu PPS. | city
260926/1172_023000_260926.raw | E:\iq_data\mesto_1_2509_3009_2026\260926\1172_023000_260926.raw | 1172_023000_260926.raw | 260926 | 26-Sep-2026 02:30:00 | 1 | 2399158272 | 5 | 1 | present | 1 | 4 | 4 | 1314989023.363 | -10976.637 | 0.082 | 1314989013.67188 | 48.828125 | 0 | 36.444 | 35.716 | 0 | checked | Uzka prerusovana cara; pozadovany pocet pulzu splnuje periodu PPS. | city
260926/1173_024000_260926.raw | E:\iq_data\mesto_1_2509_3009_2026\260926\1173_024000_260926.raw | 1173_024000_260926.raw | 260926 | 26-Sep-2026 02:40:00 | 1 | 2399158272 | 5 | 1 | present | 1 | 4 | 4 | 1314989051.041 | -10948.959 | 0.066 | 1314989062.5 | 48.828125 | 0 | 36.932 | 36.09 | 0 | checked | Uzka prerusovana cara; pozadovany pocet pulzu splnuje periodu PPS. | city
260926/1174_025000_260926.raw | E:\iq_data\mesto_1_2509_3009_2026\260926\1174_025000_260926.raw | 1174_025000_260926.raw | 260926 | 26-Sep-2026 02:50:00 | 1 | 2399158272 | 5 | 1 | present | 1 | 4 | 5 | 1314989067.712 | -10932.288 | 0.012 | 1314989062.5 | 48.828125 | 0 | 36.915 | 35.804 | 0 | checked | Uzka prerusovana cara; pozadovany pocet pulzu splnuje periodu PPS. | city
260926/1175_030000_260926.raw | E:\iq_data\mesto_1_2509_3009_2026\260926\1175_030000_260926.raw | 1175_030000_260926.raw | 260926 | 26-Sep-2026 03:00:00 | 1 | 2399158272 | 5 | 1 | present | 1 | 5 | 5 | 1314989063.769 | -10936.231 | 0.019 | 1314989062.5 | 48.828125 | 0.03 | 36.626 | 36.04 | 0 | checked | Uzka prerusovana cara; pozadovany pocet pulzu splnuje periodu PPS. | city
260926/1176_031000_260926.raw | E:\iq_data\mesto_1_2509_3009_2026\260926\1176_031000_260926.raw | 1176_031000_260926.raw | 260926 | 26-Sep-2026 03:10:00 | 1 | 2399158272 | 5 | 1 | present | 1 | 4 | 4 | 1314989071.744 | -10928.256 | 0.055 | 1314989062.5 | 48.828125 | 0 | 36.957 | 36.19 | 0 | checked | Uzka prerusovana cara; pozadovany pocet pulzu splnuje periodu PPS. | city
260926/1177_032000_260926.raw | E:\iq_data\mesto_1_2509_3009_2026\260926\1177_032000_260926.raw | 1177_032000_260926.raw | 260926 | 26-Sep-2026 03:20:00 | 1 | 2399158272 | 5 | 1 | present | 1 | 4 | 4 | 1314989084.948 | -10915.052 | 0.027 | 1314989062.5 | 48.828125 | 0 | 36.61 | 35.831 | 0 | checked | Uzka prerusovana cara; pozadovany pocet pulzu splnuje periodu PPS. | city
260926/1178_033000_260926.raw | E:\iq_data\mesto_1_2509_3009_2026\260926\1178_033000_260926.raw | 1178_033000_260926.raw | 260926 | 26-Sep-2026 03:30:00 | 1 | 2399158272 | 5 | 1 | present | 1 | 4 | 5 | 1314989091.661 | -10908.339 | 0.048 | 1314989111.32813 | 48.828125 | 0 | 35.325 | 35.825 | 0 | checked | Uzka prerusovana cara; pozadovany pocet pulzu splnuje periodu PPS. | city
260926/1179_034000_260926.raw | E:\iq_data\mesto_1_2509_3009_2026\260926\1179_034000_260926.raw | 1179_034000_260926.raw | 260926 | 26-Sep-2026 03:40:00 | 1 | 2399158272 | 5 | 1 | present | 1 | 4 | 5 | 1314989092.198 | -10907.802 | 0.069 | 1314989111.32813 | 48.828125 | 0 | 35.01 | 35.496 | 0 | checked | Uzka prerusovana cara; pozadovany pocet pulzu splnuje periodu PPS. | city
260926/1180_035000_260926.raw | E:\iq_data\mesto_1_2509_3009_2026\260926\1180_035000_260926.raw | 1180_035000_260926.raw | 260926 | 26-Sep-2026 03:50:00 | 1 | 2399158272 | 5 | 1 | present | 1 | 4 | 4 | 1314989115.435 | -10884.565 | 0.122 | 1314989111.32813 | 48.828125 | 0 | 35.251 | 35.818 | 0 | checked | Uzka prerusovana cara; pozadovany pocet pulzu splnuje periodu PPS. | city
260926/1181_040000_260926.raw | E:\iq_data\mesto_1_2509_3009_2026\260926\1181_040000_260926.raw | 1181_040000_260926.raw | 260926 | 26-Sep-2026 04:00:00 | 1 | 2399158272 | 5 | 1 | present | 1 | 4 | 4 | 1314989127.668 | -10872.332 | 0.078 | 1314989111.32813 | 48.828125 | 0.005 | 35.437 | 35.583 | 0 | checked | Uzka prerusovana cara; pozadovany pocet pulzu splnuje periodu PPS. | city
260926/1182_041000_260926.raw | E:\iq_data\mesto_1_2509_3009_2026\260926\1182_041000_260926.raw | 1182_041000_260926.raw | 260926 | 26-Sep-2026 04:10:00 | 1 | 2396340224 | 5 | 1 | present | 1 | 4 | 4 | 1314989135.946 | -10864.054 | 0.114 | 1314989111.32813 | 48.828125 | 0 | 35.461 | 34.693 | 0 | checked | Uzka prerusovana cara; pozadovany pocet pulzu splnuje periodu PPS. | city
260926/1183_042000_260926.raw | E:\iq_data\mesto_1_2509_3009_2026\260926\1183_042000_260926.raw | 1183_042000_260926.raw | 260926 | 26-Sep-2026 04:20:00 | 1 | 2399158272 | 5 | 1 | present | 1 | 4 | 5 | 1314989164.961 | -10835.039 | 0.059 | 1314989160.15625 | 48.828125 | 0 | 35.68 | 35.574 | 0 | checked | Uzka prerusovana cara; pozadovany pocet pulzu splnuje periodu PPS. | city
260926/1184_043000_260926.raw | E:\iq_data\mesto_1_2509_3009_2026\260926\1184_043000_260926.raw | 1184_043000_260926.raw | 260926 | 26-Sep-2026 04:30:00 | 1 | 2399158272 | 5 | 1 | present | 1 | 4 | 4 | 1314989183.938 | -10816.062 | 0.033 | 1314989208.98438 | 48.828125 | 0 | 36.384 | 36.14 | 0 | checked | Uzka prerusovana cara; pozadovany pocet pulzu splnuje periodu PPS. | city
260926/1185_044000_260926.raw | E:\iq_data\mesto_1_2509_3009_2026\260926\1185_044000_260926.raw | 1185_044000_260926.raw | 260926 | 26-Sep-2026 04:40:00 | 1 | 2399158272 | 5 | 1 | present | 1 | 4 | 4 | 1314989208.184 | -10791.816 | 0.07 | 1314989208.98438 | 48.828125 | 0 | 36.809 | 36.484 | 0 | checked | Uzka prerusovana cara; pozadovany pocet pulzu splnuje periodu PPS. | city
260926/1186_045000_260926.raw | E:\iq_data\mesto_1_2509_3009_2026\260926\1186_045000_260926.raw | 1186_045000_260926.raw | 260926 | 26-Sep-2026 04:50:00 | 1 | 2399158272 | 5 | 1 | present | 1 | 4 | 5 | 1314989240.559 | -10759.441 | 0.048 | 1314989257.8125 | 48.828125 | 0 | 36.237 | 36.186 | 0 | checked | Uzka prerusovana cara; pozadovany pocet pulzu splnuje periodu PPS. | city
260926/1187_050000_260926.raw | E:\iq_data\mesto_1_2509_3009_2026\260926\1187_050000_260926.raw | 1187_050000_260926.raw | 260926 | 26-Sep-2026 05:00:00 | 1 | 2399158272 | 5 | 1 | present | 1 | 4 | 5 | 1314989288.819 | -10711.181 | 0.105 | 1314989306.64063 | 48.828125 | 0 | 37.015 | 35.689 | 0 | checked | Uzka prerusovana cara; pozadovany pocet pulzu splnuje periodu PPS. | city
260926/1188_051000_260926.raw | E:\iq_data\mesto_1_2509_3009_2026\260926\1188_051000_260926.raw | 1188_051000_260926.raw | 260926 | 26-Sep-2026 05:10:00 | 1 | 2399158272 | 5 | 1 | present | 1 | 4 | 4 | 1314989303.86 | -10696.14 | 0.013 | 1314989306.64063 | 48.828125 | 0 | 37.009 | 36.032 | 0 | checked | Uzka prerusovana cara; pozadovany pocet pulzu splnuje periodu PPS. | city
260926/1189_052000_260926.raw | E:\iq_data\mesto_1_2509_3009_2026\260926\1189_052000_260926.raw | 1189_052000_260926.raw | 260926 | 26-Sep-2026 05:20:00 | 1 | 2398633984 | 5 | 1 | present | 1 | 4 | 4 | 1314989312.858 | -10687.142 | 0.276 | 1314989306.64063 | 48.828125 | 0 | 36.53 | 35.989 | 0 | checked | Uzka prerusovana cara; pozadovany pocet pulzu splnuje periodu PPS. | city
260926/1190_053000_260926.raw | E:\iq_data\mesto_1_2509_3009_2026\260926\1190_053000_260926.raw | 1190_053000_260926.raw | 260926 | 26-Sep-2026 05:30:00 | 1 | 2399158272 | 5 | 1 | present | 1 | 4 | 5 | 1314989355.27 | -10644.73 | 0.074 | 1314989355.46875 | 48.828125 | 0 | 37.179 | 36.012 | 0 | checked | Uzka prerusovana cara; pozadovany pocet pulzu splnuje periodu PPS. | city
260926/1191_054000_260926.raw | E:\iq_data\mesto_1_2509_3009_2026\260926\1191_054000_260926.raw | 1191_054000_260926.raw | 260926 | 26-Sep-2026 05:40:00 | 1 | 2399158272 | 5 | 1 | present | 1 | 5 | 5 | 1314989365.21 | -10634.79 | 0.072 | 1314989355.46875 | 48.828125 | 0.035 | 36.71 | 36.153 | 0 | checked | Uzka prerusovana cara; pozadovany pocet pulzu splnuje periodu PPS. | city
260926/1192_055000_260926.raw | E:\iq_data\mesto_1_2509_3009_2026\260926\1192_055000_260926.raw | 1192_055000_260926.raw | 260926 | 26-Sep-2026 05:50:00 | 1 | 2399158272 | 5 | 1 | present | 1 | 4 | 4 | 1314989374.841 | -10625.159 | 0.137 | 1314989404.29688 | 48.828125 | 0 | 36.198 | 35.289 | 0 | checked | Uzka prerusovana cara; pozadovany pocet pulzu splnuje periodu PPS. | city
260926/1193_060000_260926.raw | E:\iq_data\mesto_1_2509_3009_2026\260926\1193_060000_260926.raw | 1193_060000_260926.raw | 260926 | 26-Sep-2026 06:00:00 | 1 | 2399158272 | 5 | 1 | present | 1 | 4 | 4 | 1314989393.093 | -10606.907 | 0.145 | 1314989404.29688 | 48.828125 | 0.005 | 36.706 | 36.143 | 0 | checked | Uzka prerusovana cara; pozadovany pocet pulzu splnuje periodu PPS. | city
260926/1194_061000_260926.raw | E:\iq_data\mesto_1_2509_3009_2026\260926\1194_061000_260926.raw | 1194_061000_260926.raw | 260926 | 26-Sep-2026 06:10:00 | 1 | 2399158272 | 5 | 1 | present | 1 | 4 | 5 | 1314989396.103 | -10603.897 | 0.043 | 1314989404.29688 | 48.828125 | 0 | 35.857 | 35.578 | 0 | checked | Uzka prerusovana cara; pozadovany pocet pulzu splnuje periodu PPS. | city
260926/1195_062000_260926.raw | E:\iq_data\mesto_1_2509_3009_2026\260926\1195_062000_260926.raw | 1195_062000_260926.raw | 260926 | 26-Sep-2026 06:20:00 | 1 | 2399158272 | 5 | 1 | present | 1 | 4 | 4 | 1314989392.132 | -10607.868 | 0.061 | 1314989404.29688 | 48.828125 | 0 | 36.631 | 35.749 | 0 | checked | Uzka prerusovana cara; pozadovany pocet pulzu splnuje periodu PPS. | city
260926/1196_063000_260926.raw | E:\iq_data\mesto_1_2509_3009_2026\260926\1196_063000_260926.raw | 1196_063000_260926.raw | 260926 | 26-Sep-2026 06:30:00 | 1 | 2399158272 | 5 | 1 | present | 1 | 4 | 4 | 1314989393.949 | -10606.051 | 0.01 | 1314989404.29688 | 48.828125 | 0 | 35.315 | 35.367 | 0 | checked | Uzka prerusovana cara; pozadovany pocet pulzu splnuje periodu PPS. | city
260926/1197_064000_260926.raw | E:\iq_data\mesto_1_2509_3009_2026\260926\1197_064000_260926.raw | 1197_064000_260926.raw | 260926 | 26-Sep-2026 06:40:00 | 1 | 2399158272 | 5 | 1 | present | 1 | 4 | 5 | 1314989414.344 | -10585.656 | 0.063 | 1314989404.29688 | 48.828125 | 0 | 34.953 | 34.308 | 0 | checked | Uzka prerusovana cara; pozadovany pocet pulzu splnuje periodu PPS. | city
260926/1198_065000_260926.raw | E:\iq_data\mesto_1_2509_3009_2026\260926\1198_065000_260926.raw | 1198_065000_260926.raw | 260926 | 26-Sep-2026 06:50:00 | 1 | 2399158272 | 5 | 1 | present | 1 | 5 | 5 | 1314989409.587 | -10590.413 | 0.032 | 1314989404.29688 | 48.828125 | 0.035 | 34.24 | 33.892 | 0 | checked | Uzka prerusovana cara; pozadovany pocet pulzu splnuje periodu PPS. | city
260926/1199_070000_260926.raw | E:\iq_data\mesto_1_2509_3009_2026\260926\1199_070000_260926.raw | 1199_070000_260926.raw | 260926 | 26-Sep-2026 07:00:00 | 1 | 2399158272 | 5 | 1 | present | 1 | 4 | 4 | 1314989408.863 | -10591.137 | 0.154 | 1314989404.29688 | 48.828125 | 0 | 35.559 | 35.347 | 0 | checked | Uzka prerusovana cara; pozadovany pocet pulzu splnuje periodu PPS. | city
260926/1200_071000_260926.raw | E:\iq_data\mesto_1_2509_3009_2026\260926\1200_071000_260926.raw | 1200_071000_260926.raw | 260926 | 26-Sep-2026 07:10:00 | 1 | 2399158272 | 5 | 1 | present | 1 | 4 | 4 | 1314989408.938 | -10591.062 | 0.017 | 1314989404.29688 | 48.828125 | 0 | 35.026 | 35.747 | 0 | checked | Uzka prerusovana cara; pozadovany pocet pulzu splnuje periodu PPS. | city
260926/1201_072000_260926.raw | E:\iq_data\mesto_1_2509_3009_2026\260926\1201_072000_260926.raw | 1201_072000_260926.raw | 260926 | 26-Sep-2026 07:20:00 | 1 | 2399158272 | 5 | 1 | present | 1 | 4 | 4 | 1314989419.412 | -10580.588 | 0.096 | 1314989453.125 | 48.828125 | 0 | 34.487 | 34.933 | 0 | checked | Uzka prerusovana cara; pozadovany pocet pulzu splnuje periodu PPS. | city
260926/1202_073000_260926.raw | E:\iq_data\mesto_1_2509_3009_2026\260926\1202_073000_260926.raw | 1202_073000_260926.raw | 260926 | 26-Sep-2026 07:30:00 | 1 | 2399158272 | 5 | 1 | present | 1 | 4 | 5 | 1314989388.768 | -10611.232 | 0.04 | 1314989404.29688 | 48.828125 | 0 | 34.953 | 34.869 | 0 | checked | Uzka prerusovana cara; pozadovany pocet pulzu splnuje periodu PPS. | city
260926/1203_074000_260926.raw | E:\iq_data\mesto_1_2509_3009_2026\260926\1203_074000_260926.raw | 1203_074000_260926.raw | 260926 | 26-Sep-2026 07:40:00 | 1 | 2399158272 | 5 | 1 | present | 1 | 5 | 5 | 1314989321.752 | -10678.248 | 0.02 | 1314989306.64063 | 48.828125 | 0.025 | 33.958 | 34.189 | 0 | checked | Uzka prerusovana cara; pozadovany pocet pulzu splnuje periodu PPS. | city
260926/1204_075000_260926.raw | E:\iq_data\mesto_1_2509_3009_2026\260926\1204_075000_260926.raw | 1204_075000_260926.raw | 260926 | 26-Sep-2026 07:50:00 | 1 | 2399158272 | 5 | 1 | present | 1 | 4 | 4 | 1314989214.424 | -10785.576 | 0.315 | 1314989208.98438 | 48.828125 | 0.005 | 33.856 | 34.157 | 0 | checked | Uzka prerusovana cara; pozadovany pocet pulzu splnuje periodu PPS. | city
260926/1205_080000_260926.raw | E:\iq_data\mesto_1_2509_3009_2026\260926\1205_080000_260926.raw | 1205_080000_260926.raw | 260926 | 26-Sep-2026 08:00:00 | 1 | 2399158272 | 5 | 1 | present | 1 | 4 | 5 | 1314989054.62 | -10945.38 | 0.423 | 1314989062.5 | 48.828125 | 0 | 33.985 | 33.978 | 0 | checked | Uzka prerusovana cara; pozadovany pocet pulzu splnuje periodu PPS. | city
260926/1206_081000_260926.raw | E:\iq_data\mesto_1_2509_3009_2026\260926\1206_081000_260926.raw | 1206_081000_260926.raw | 260926 | 26-Sep-2026 08:10:00 | 1 | 2399158272 | 5 | 1 | present | 1 | 4 | 5 | 1314988876.602 | -11123.398 | 0.438 | 1314988867.1875 | 48.828125 | 0 | 34.743 | 34.149 | 0 | checked | Uzka prerusovana cara; pozadovany pocet pulzu splnuje periodu PPS. | city
260926/1207_082000_260926.raw | E:\iq_data\mesto_1_2509_3009_2026\260926\1207_082000_260926.raw | 1207_082000_260926.raw | 260926 | 26-Sep-2026 08:20:00 | 1 | 2399158272 | 5 | 1 | present | 1 | 4 | 4 | 1314988679.405 | -11320.595 | 0.448 | 1314988671.875 | 48.828125 | 0 | 33.863 | 33.086 | 0 | checked | Uzka prerusovana cara; pozadovany pocet pulzu splnuje periodu PPS. | city
260926/1208_083000_260926.raw | E:\iq_data\mesto_1_2509_3009_2026\260926\1208_083000_260926.raw | 1208_083000_260926.raw | 260926 | 26-Sep-2026 08:30:00 | 1 | 2399158272 | 5 | 1 | present | 1 | 4 | 4 | 1314988467.125 | -11532.875 | 0.508 | 1314988476.5625 | 48.828125 | 0 | 34.336 | 33.98 | 0 | checked | Uzka prerusovana cara; pozadovany pocet pulzu splnuje periodu PPS. | city
260926/1209_084000_260926.raw | E:\iq_data\mesto_1_2509_3009_2026\260926\1209_084000_260926.raw | 1209_084000_260926.raw | 260926 | 26-Sep-2026 08:40:00 | 1 | 2399158272 | 5 | 1 | present | 1 | 4 | 4 | 1314988241.903 | -11758.097 | 0.536 | 1314988232.42188 | 48.828125 | 0 | 33.844 | 33.547 | 0 | checked | Uzka prerusovana cara; pozadovany pocet pulzu splnuje periodu PPS. | city
260926/1210_085000_260926.raw | E:\iq_data\mesto_1_2509_3009_2026\260926\1210_085000_260926.raw | 1210_085000_260926.raw | 260926 | 26-Sep-2026 08:50:00 | 1 | 2399158272 | 5 | 1 | present | 1 | 4 | 5 | 1314987995.672 | -12004.328 | 0.505 | 1314987988.28125 | 48.828125 | 0 | 33.88 | 33.604 | 0 | checked | Uzka prerusovana cara; pozadovany pocet pulzu splnuje periodu PPS. | city
260926/1211_090000_260926.raw | E:\iq_data\mesto_1_2509_3009_2026\260926\1211_090000_260926.raw | 1211_090000_260926.raw | 260926 | 26-Sep-2026 09:00:00 | 1 | 2399158272 | 5 | 1 | present | 1 | 5 | 5 | 1314987748.059 | -12251.941 | 0.801 | 1314987744.14063 | 48.828125 | 0.035 | 34.306 | 33.827 | 0 | checked | Uzka prerusovana cara; pozadovany pocet pulzu splnuje periodu PPS. | city
260926/1212_091000_260926.raw | E:\iq_data\mesto_1_2509_3009_2026\260926\1212_091000_260926.raw | 1212_091000_260926.raw | 260926 | 26-Sep-2026 09:10:00 | 1 | 2399158272 | 5 | 1 | present | 1 | 4 | 4 | 1314987481.064 | -12518.936 | 0.694 | 1314987500 | 48.828125 | 0 | 32.834 | 33.279 | 0 | checked | Uzka prerusovana cara; pozadovany pocet pulzu splnuje periodu PPS. | city
260926/1213_092000_260926.raw | E:\iq_data\mesto_1_2509_3009_2026\260926\1213_092000_260926.raw | 1213_092000_260926.raw | 260926 | 26-Sep-2026 09:20:00 | 1 | 2399158272 | 5 | 1 | present | 1 | 4 | 5 | 1314987210.363 | -12789.637 | 0.735 | 1314987207.03125 | 48.828125 | 0 | 33.178 | 31.983 | 0 | checked | Uzka prerusovana cara; pozadovany pocet pulzu splnuje periodu PPS. | city
260926/1214_093000_260926.raw | E:\iq_data\mesto_1_2509_3009_2026\260926\1214_093000_260926.raw | 1214_093000_260926.raw | 260926 | 26-Sep-2026 09:30:00 | 1 | 2399158272 | 5 | 1 | present | 1 | 5 | 5 | 1314986959.845 | -13040.155 | 0.502 | 1314986962.89063 | 48.828125 | 0.035 | 33.158 | 32.599 | 0 | checked | Uzka prerusovana cara; pozadovany pocet pulzu splnuje periodu PPS. | city
260926/1215_094000_260926.raw | E:\iq_data\mesto_1_2509_3009_2026\260926\1215_094000_260926.raw | 1215_094000_260926.raw | 260926 | 26-Sep-2026 09:40:00 | 1 | 2399158272 | 5 | 1 | present | 1 | 4 | 4 | 1314986737.065 | -13262.935 | 0.346 | 1314986718.75 | 48.828125 | 0 | 33.64 | 32.967 | 0 | checked | Uzka prerusovana cara; pozadovany pocet pulzu splnuje periodu PPS. | city
260926/1216_095000_260926.raw | E:\iq_data\mesto_1_2509_3009_2026\260926\1216_095000_260926.raw | 1216_095000_260926.raw | 260926 | 26-Sep-2026 09:50:00 | 1 | 2399158272 | 5 | 1 | present | 1 | 4 | 4 | 1314986539.537 | -13460.463 | 0.508 | 1314986523.4375 | 48.828125 | 0 | 34.027 | 33.37 | 0 | checked | Uzka prerusovana cara; pozadovany pocet pulzu splnuje periodu PPS. | city
260926/1217_100000_260926.raw | E:\iq_data\mesto_1_2509_3009_2026\260926\1217_100000_260926.raw | 1217_100000_260926.raw | 260926 | 26-Sep-2026 10:00:00 | 1 | 2397061120 | 5 | 1 | present | 1 | 4 | 5 | 1314986363.029 | -13636.971 | 0.373 | 1314986376.95313 | 48.828125 | 0 | 31.352 | 31.419 | 0 | checked | Uzka prerusovana cara; pozadovany pocet pulzu splnuje periodu PPS. | city
260926/1218_101000_260926.raw | E:\iq_data\mesto_1_2509_3009_2026\260926\1218_101000_260926.raw | 1218_101000_260926.raw | 260926 | 26-Sep-2026 10:10:00 | 1 | 2399158272 | 5 | 1 | present | 1 | 4 | 5 | 1314986210.792 | -13789.208 | 0.257 | 1314986230.46875 | 48.828125 | 0 | 34.452 | 33.423 | 0 | checked | Uzka prerusovana cara; pozadovany pocet pulzu splnuje periodu PPS. | city
260926/1219_102000_260926.raw | E:\iq_data\mesto_1_2509_3009_2026\260926\1219_102000_260926.raw | 1219_102000_260926.raw | 260926 | 26-Sep-2026 10:20:00 | 1 | 2399158272 | 5 | 1 | present | 1 | 5 | 5 | 1314986087.476 | -13912.524 | 0.415 | 1314986083.98438 | 48.828125 | 0.025 | 34.027 | 33.463 | 0 | checked | Uzka prerusovana cara; pozadovany pocet pulzu splnuje periodu PPS. | city
260926/1220_103000_260926.raw | E:\iq_data\mesto_1_2509_3009_2026\260926\1220_103000_260926.raw | 1220_103000_260926.raw | 260926 | 26-Sep-2026 10:30:00 | 1 | 2399158272 | 5 | 1 | present | 1 | 4 | 4 | 1314985982.731 | -14017.269 | 0.175 | 1314985986.32813 | 48.828125 | 0 | 33.312 | 32.86 | 0 | checked | Uzka prerusovana cara; pozadovany pocet pulzu splnuje periodu PPS. | city
260926/1221_104000_260926.raw | E:\iq_data\mesto_1_2509_3009_2026\260926\1221_104000_260926.raw | 1221_104000_260926.raw | 260926 | 26-Sep-2026 10:40:00 | 1 | 2399158272 | 5 | 1 | present | 1 | 4 | 5 | 1314985899.929 | -14100.071 | 0.079 | 1314985888.67188 | 48.828125 | 0 | 31.59 | 32.011 | 0 | checked | Uzka prerusovana cara; pozadovany pocet pulzu splnuje periodu PPS. | city
260926/1222_105000_260926.raw | E:\iq_data\mesto_1_2509_3009_2026\260926\1222_105000_260926.raw | 1222_105000_260926.raw | 260926 | 26-Sep-2026 10:50:00 | 1 | 2399158272 | 5 | 1 | present | 1 | 4 | 5 | 1314985832.862 | -14167.138 | 0.072 | 1314985839.84375 | 48.828125 | 0 | 32.296 | 30.345 | 0 | checked | Uzka prerusovana cara; pozadovany pocet pulzu splnuje periodu PPS. | city
260926/1223_110000_260926.raw | E:\iq_data\mesto_1_2509_3009_2026\260926\1223_110000_260926.raw | 1223_110000_260926.raw | 260926 | 26-Sep-2026 11:00:00 | 1 | 2399158272 | 5 | 1 | present | 1 | 4 | 4 | 1314985783.124 | -14216.876 | 0.248 | 1314985791.01563 | 48.828125 | 0 | 32.64 | 32.108 | 0 | checked | Uzka prerusovana cara; pozadovany pocet pulzu splnuje periodu PPS. | city
260926/1224_111000_260926.raw | E:\iq_data\mesto_1_2509_3009_2026\260926\1224_111000_260926.raw | 1224_111000_260926.raw | 260926 | 26-Sep-2026 11:10:00 | 1 | 2399158272 | 5 | 1 | present | 1 | 4 | 4 | 1314985756.772 | -14243.228 | 0.076 | 1314985742.1875 | 48.828125 | 0 | 29.85 | 29.776 | 0 | checked | Uzka prerusovana cara; pozadovany pocet pulzu splnuje periodu PPS. | city
260926/1225_112000_260926.raw | E:\iq_data\mesto_1_2509_3009_2026\260926\1225_112000_260926.raw | 1225_112000_260926.raw | 260926 | 26-Sep-2026 11:20:00 | 1 | 2399158272 | 5 | 1 | present | 1 | 4 | 4 | 1314985735.663 | -14264.337 | 0.026 | 1314985742.1875 | 48.828125 | 0.005 | 32.321 | 31.809 | 0 | checked | Uzka prerusovana cara; pozadovany pocet pulzu splnuje periodu PPS. | city
260926/1226_113000_260926.raw | E:\iq_data\mesto_1_2509_3009_2026\260926\1226_113000_260926.raw | 1226_113000_260926.raw | 260926 | 26-Sep-2026 11:30:00 | 1 | 2399158272 | 5 | 1 | present | 1 | 4 | 5 | 1314985723.189 | -14276.811 | 0.053 | 1314985742.1875 | 48.828125 | 0 | 33.157 | 33.052 | 0 | checked | Uzka prerusovana cara; pozadovany pocet pulzu splnuje periodu PPS. | city
260926/1227_114000_260926.raw | E:\iq_data\mesto_1_2509_3009_2026\260926\1227_114000_260926.raw | 1227_114000_260926.raw | 260926 | 26-Sep-2026 11:40:00 | 1 | 2399158272 | 5 | 1 | present | 1 | 5 | 5 | 1314985723.926 | -14276.074 | 0.057 | 1314985742.1875 | 48.828125 | 0.03 | 32.663 | 32.675 | 0 | checked | Uzka prerusovana cara; pozadovany pocet pulzu splnuje periodu PPS. | city
260926/1228_115000_260926.raw | E:\iq_data\mesto_1_2509_3009_2026\260926\1228_115000_260926.raw | 1228_115000_260926.raw | 260926 | 26-Sep-2026 11:50:00 | 1 | 2399158272 | 5 | 1 | present | 1 | 4 | 4 | 1314985731.501 | -14268.499 | 0.051 | 1314985742.1875 | 48.828125 | 0 | 32.613 | 32.15 | 0 | checked | Uzka prerusovana cara; pozadovany pocet pulzu splnuje periodu PPS. | city
260926/1229_120000_260926.raw | E:\iq_data\mesto_1_2509_3009_2026\260926\1229_120000_260926.raw | 1229_120000_260926.raw | 260926 | 26-Sep-2026 12:00:00 | 1 | 2399158272 | 5 | 1 | present | 1 | 4 | 4 | 1314985744.173 | -14255.827 | 0.033 | 1314985742.1875 | 48.828125 | 0 | 32.941 | 31.643 | 0 | checked | Uzka prerusovana cara; pozadovany pocet pulzu splnuje periodu PPS. | city
260926/1230_121000_260926.raw | E:\iq_data\mesto_1_2509_3009_2026\260926\1230_121000_260926.raw | 1230_121000_260926.raw | 260926 | 26-Sep-2026 12:10:00 | 1 | 2399158272 | 5 | 1 | present | 1 | 4 | 5 | 1314985762.002 | -14237.998 | 0.05 | 1314985742.1875 | 48.828125 | 0 | 32.54 | 31.993 | 0 | checked | Uzka prerusovana cara; pozadovany pocet pulzu splnuje periodu PPS. | city
260926/1231_122000_260926.raw | E:\iq_data\mesto_1_2509_3009_2026\260926\1231_122000_260926.raw | 1231_122000_260926.raw | 260926 | 26-Sep-2026 12:20:00 | 1 | 2399158272 | 5 | 1 | present | 1 | 4 | 5 | 1314985783.238 | -14216.762 | 0.072 | 1314985791.01563 | 48.828125 | 0 | 33.028 | 32.831 | 0 | checked | Uzka prerusovana cara; pozadovany pocet pulzu splnuje periodu PPS. | city
260926/1232_123000_260926.raw | E:\iq_data\mesto_1_2509_3009_2026\260926\1232_123000_260926.raw | 1232_123000_260926.raw | 260926 | 26-Sep-2026 12:30:00 | 1 | 2399158272 | 5 | 1 | present | 1 | 4 | 4 | 1314985807.387 | -14192.613 | 0.07 | 1314985791.01563 | 48.828125 | 0 | 33.316 | 33.403 | 0 | checked | Uzka prerusovana cara; pozadovany pocet pulzu splnuje periodu PPS. | city
260926/1233_124000_260926.raw | E:\iq_data\mesto_1_2509_3009_2026\260926\1233_124000_260926.raw | 1233_124000_260926.raw | 260926 | 26-Sep-2026 12:40:00 | 1 | 2399158272 | 5 | 1 | present | 1 | 4 | 4 | 1314985834.469 | -14165.531 | 0.047 | 1314985839.84375 | 48.828125 | 0 | 34.824 | 33.983 | 0 | checked | Uzka prerusovana cara; pozadovany pocet pulzu splnuje periodu PPS. | city
260926/1234_125000_260926.raw | E:\iq_data\mesto_1_2509_3009_2026\260926\1234_125000_260926.raw | 1234_125000_260926.raw | 260926 | 26-Sep-2026 12:50:00 | 1 | 2399158272 | 5 | 1 | present | 1 | 4 | 5 | 1314985865.895 | -14134.105 | 0.079 | 1314985888.67188 | 48.828125 | 0.005 | 33.283 | 33.671 | 0 | checked | Uzka prerusovana cara; pozadovany pocet pulzu splnuje periodu PPS. | city
260926/1235_130000_260926.raw | E:\iq_data\mesto_1_2509_3009_2026\260926\1235_130000_260926.raw | 1235_130000_260926.raw | 260926 | 26-Sep-2026 13:00:00 | 1 | 2399158272 | 5 | 1 | present | 1 | 4 | 5 | 1314985903.474 | -14096.526 | 0.041 | 1314985888.67188 | 48.828125 | 0.005 | 33.875 | 33.743 | 0 | checked | Uzka prerusovana cara; pozadovany pocet pulzu splnuje periodu PPS. | city
260926/1236_131000_260926.raw | E:\iq_data\mesto_1_2509_3009_2026\260926\1236_131000_260926.raw | 1236_131000_260926.raw | 260926 | 26-Sep-2026 13:10:00 | 1 | 2399158272 | 5 | 1 | present | 1 | 4 | 4 | 1314985940.085 | -14059.915 | 0.127 | 1314985937.5 | 48.828125 | 0 | 32.227 | 33.648 | 0 | checked | Uzka prerusovana cara; pozadovany pocet pulzu splnuje periodu PPS. | city
260926/1237_132000_260926.raw | E:\iq_data\mesto_1_2509_3009_2026\260926\1237_132000_260926.raw | 1237_132000_260926.raw | 260926 | 26-Sep-2026 13:20:00 | 1 | 2399158272 | 5 | 1 | present | 1 | 4 | 4 | 1314985969.281 | -14030.719 | 0.021 | 1314985986.32813 | 48.828125 | 0 | 34.754 | 33.545 | 0 | checked | Uzka prerusovana cara; pozadovany pocet pulzu splnuje periodu PPS. | city
260926/1238_133000_260926.raw | E:\iq_data\mesto_1_2509_3009_2026\260926\1238_133000_260926.raw | 1238_133000_260926.raw | 260926 | 26-Sep-2026 13:30:00 | 1 | 2399158272 | 5 | 1 | present | 1 | 4 | 5 | 1314986002.842 | -13997.158 | 0.112 | 1314985986.32813 | 48.828125 | 0 | 33.716 | 33.786 | 0 | checked | Uzka prerusovana cara; pozadovany pocet pulzu splnuje periodu PPS. | city
260926/1239_134000_260926.raw | E:\iq_data\mesto_1_2509_3009_2026\260926\1239_134000_260926.raw | 1239_134000_260926.raw | 260926 | 26-Sep-2026 13:40:00 | 1 | 2399158272 | 5 | 1 | present | 1 | 4 | 5 | 1314986030.829 | -13969.171 | 0.092 | 1314986035.15625 | 48.828125 | 0 | 32.789 | 33.266 | 0 | checked | Uzka prerusovana cara; pozadovany pocet pulzu splnuje periodu PPS. | city
260926/1240_135000_260926.raw | E:\iq_data\mesto_1_2509_3009_2026\260926\1240_135000_260926.raw | 1240_135000_260926.raw | 260926 | 26-Sep-2026 13:50:00 | 1 | 2399158272 | 5 | 1 | present | 1 | 4 | 4 | 1314986056.091 | -13943.909 | 0.048 | 1314986035.15625 | 48.828125 | 0 | 33.877 | 32.959 | 0 | checked | Uzka prerusovana cara; pozadovany pocet pulzu splnuje periodu PPS. | city
260926/1241_140000_260926.raw | E:\iq_data\mesto_1_2509_3009_2026\260926\1241_140000_260926.raw | 1241_140000_260926.raw | 260926 | 26-Sep-2026 14:00:00 | 1 | 2399158272 | 5 | 1 | present | 1 | 4 | 4 | 1314986086.746 | -13913.254 | 0.093 | 1314986083.98438 | 48.828125 | 0 | 32.019 | 32.142 | 0 | checked | Uzka prerusovana cara; pozadovany pocet pulzu splnuje periodu PPS. | city
260926/1242_141000_260926.raw | E:\iq_data\mesto_1_2509_3009_2026\260926\1242_141000_260926.raw | 1242_141000_260926.raw | 260926 | 26-Sep-2026 14:10:00 | 1 | 2399158272 | 5 | 1 | present | 1 | 4 | 4 | 1314986119.477 | -13880.523 | 0.191 | 1314986132.8125 | 48.828125 | 0 | 33.801 | 33.286 | 0 | checked | Uzka prerusovana cara; pozadovany pocet pulzu splnuje periodu PPS. | city
260926/1243_142000_260926.raw | E:\iq_data\mesto_1_2509_3009_2026\260926\1243_142000_260926.raw | 1243_142000_260926.raw | 260926 | 26-Sep-2026 14:20:00 | 1 | 2399158272 | 5 | 1 | present | 1 | 4 | 5 | 1314986138.447 | -13861.553 | 0.062 | 1314986132.8125 | 48.828125 | 0 | 32.464 | 31.854 | 0 | checked | Uzka prerusovana cara; pozadovany pocet pulzu splnuje periodu PPS. | city
260926/1244_143000_260926.raw | E:\iq_data\mesto_1_2509_3009_2026\260926\1244_143000_260926.raw | 1244_143000_260926.raw | 260926 | 26-Sep-2026 14:30:00 | 1 | 2399158272 | 5 | 1 | present | 1 | 4 | 4 | 1314986148.579 | -13851.421 | 0.06 | 1314986132.8125 | 48.828125 | 0 | 34.093 | 33.431 | 0 | checked | Uzka prerusovana cara; pozadovany pocet pulzu splnuje periodu PPS. | city
260926/1245_144000_260926.raw | E:\iq_data\mesto_1_2509_3009_2026\260926\1245_144000_260926.raw | 1245_144000_260926.raw | 260926 | 26-Sep-2026 14:40:00 | 1 | 2399158272 | 5 | 1 | present | 1 | 4 | 4 | 1314986154.257 | -13845.743 | 0.098 | 1314986181.64063 | 48.828125 | 0 | 34.606 | 33.827 | 0 | checked | Uzka prerusovana cara; pozadovany pocet pulzu splnuje periodu PPS. | city
260926/1246_145000_260926.raw | E:\iq_data\mesto_1_2509_3009_2026\260926\1246_145000_260926.raw | 1246_145000_260926.raw | 260926 | 26-Sep-2026 14:50:00 | 1 | 2399158272 | 5 | 1 | present | 1 | 4 | 5 | 1314986164.487 | -13835.513 | 0.02 | 1314986181.64063 | 48.828125 | 0 | 32.219 | 31.784 | 0 | checked | Uzka prerusovana cara; pozadovany pocet pulzu splnuje periodu PPS. | city
260926/1247_150000_260926.raw | E:\iq_data\mesto_1_2509_3009_2026\260926\1247_150000_260926.raw | 1247_150000_260926.raw | 260926 | 26-Sep-2026 15:00:00 | 1 | 2399158272 | 5 | 1 | present | 1 | 4 | 5 | 1314986173.683 | -13826.317 | 0.157 | 1314986181.64063 | 48.828125 | 0.005 | 33.465 | 33.633 | 0 | checked | Uzka prerusovana cara; pozadovany pocet pulzu splnuje periodu PPS. | city
260926/1248_151000_260926.raw | E:\iq_data\mesto_1_2509_3009_2026\260926\1248_151000_260926.raw | 1248_151000_260926.raw | 260926 | 26-Sep-2026 15:10:00 | 1 | 2399158272 | 5 | 1 | present | 1 | 4 | 4 | 1314986175.201 | -13824.799 | 0.106 | 1314986181.64063 | 48.828125 | 0 | 34.91 | 33.899 | 0 | checked | Uzka prerusovana cara; pozadovany pocet pulzu splnuje periodu PPS. | city
260926/1249_152000_260926.raw | E:\iq_data\mesto_1_2509_3009_2026\260926\1249_152000_260926.raw | 1249_152000_260926.raw | 260926 | 26-Sep-2026 15:20:00 | 1 | 2399158272 | 5 | 1 | present | 1 | 4 | 4 | 1314986176.334 | -13823.666 | 0.07 | 1314986181.64063 | 48.828125 | 0 | 35.15 | 34.04 | 0 | checked | Uzka prerusovana cara; pozadovany pocet pulzu splnuje periodu PPS. | city
260926/1250_153000_260926.raw | E:\iq_data\mesto_1_2509_3009_2026\260926\1250_153000_260926.raw | 1250_153000_260926.raw | 260926 | 26-Sep-2026 15:30:00 | 1 | 2399158272 | 5 | 1 | present | 1 | 4 | 5 | 1314986182.962 | -13817.038 | 0.012 | 1314986181.64063 | 48.828125 | 0 | 35.154 | 33.847 | 0 | checked | Uzka prerusovana cara; pozadovany pocet pulzu splnuje periodu PPS. | city
260926/1251_154000_260926.raw | E:\iq_data\mesto_1_2509_3009_2026\260926\1251_154000_260926.raw | 1251_154000_260926.raw | 260926 | 26-Sep-2026 15:40:00 | 1 | 2399158272 | 5 | 1 | present | 1 | 4 | 5 | 1314986196.368 | -13803.632 | 0.251 | 1314986181.64063 | 48.828125 | 0.005 | 33.198 | 32.518 | 0 | checked | Uzka prerusovana cara; pozadovany pocet pulzu splnuje periodu PPS. | city
260926/1252_155000_260926.raw | E:\iq_data\mesto_1_2509_3009_2026\260926\1252_155000_260926.raw | 1252_155000_260926.raw | 260926 | 26-Sep-2026 15:50:00 | 1 | 2399158272 | 5 | 1 | present | 1 | 5 | 5 | 1314986214.079 | -13785.921 | 0.071 | 1314986181.64063 | 48.828125 | 0.025 | 33.066 | 32.821 | 0 | checked | Uzka prerusovana cara; pozadovany pocet pulzu splnuje periodu PPS. | city
260926/1253_160000_260926.raw | E:\iq_data\mesto_1_2509_3009_2026\260926\1253_160000_260926.raw | 1253_160000_260926.raw | 260926 | 26-Sep-2026 16:00:00 | 1 | 2399158272 | 5 | 1 | present | 1 | 4 | 4 | 1314986230.597 | -13769.403 | 0.073 | 1314986230.46875 | 48.828125 | 0 | 32.577 | 32.456 | 0 | checked | Uzka prerusovana cara; pozadovany pocet pulzu splnuje periodu PPS. | city
260926/1254_161000_260926.raw | E:\iq_data\mesto_1_2509_3009_2026\260926\1254_161000_260926.raw | 1254_161000_260926.raw | 260926 | 26-Sep-2026 16:10:00 | 1 | 2398322688 | 5 | 1 | present | 1 | 4 | 5 | 1314986241.316 | -13758.684 | 0.091 | 1314986230.46875 | 48.828125 | 0 | 34.981 | 34.218 | 0 | checked | Uzka prerusovana cara; pozadovany pocet pulzu splnuje periodu PPS. | city
260926/1255_162000_260926.raw | E:\iq_data\mesto_1_2509_3009_2026\260926\1255_162000_260926.raw | 1255_162000_260926.raw | 260926 | 26-Sep-2026 16:20:00 | 1 | 2399158272 | 5 | 1 | present | 1 | 4 | 5 | 1314986246.596 | -13753.404 | 0.029 | 1314986230.46875 | 48.828125 | 0.005 | 34.7 | 34.176 | 0 | checked | Uzka prerusovana cara; pozadovany pocet pulzu splnuje periodu PPS. | city
260926/1256_163000_260926.raw | E:\iq_data\mesto_1_2509_3009_2026\260926\1256_163000_260926.raw | 1256_163000_260926.raw | 260926 | 26-Sep-2026 16:30:00 | 1 | 2399158272 | 5 | 1 | present | 1 | 4 | 4 | 1314986249.964 | -13750.036 | 0.068 | 1314986230.46875 | 48.828125 | 0 | 32.557 | 32.975 | 0 | checked | Uzka prerusovana cara; pozadovany pocet pulzu splnuje periodu PPS. | city
260926/1257_164000_260926.raw | E:\iq_data\mesto_1_2509_3009_2026\260926\1257_164000_260926.raw | 1257_164000_260926.raw | 260926 | 26-Sep-2026 16:40:00 | 1 | 2399158272 | 5 | 1 | present | 1 | 4 | 5 | 1314986253.751 | -13746.249 | 0.066 | 1314986230.46875 | 48.828125 | 0 | 32.238 | 32.057 | 0 | checked | Uzka prerusovana cara; pozadovany pocet pulzu splnuje periodu PPS. | city
260926/1258_165000_260926.raw | E:\iq_data\mesto_1_2509_3009_2026\260926\1258_165000_260926.raw | 1258_165000_260926.raw | 260926 | 26-Sep-2026 16:50:00 | 1 | 2399158272 | 5 | 1 | present | 1 | 4 | 5 | 1314986264.725 | -13735.275 | 0.066 | 1314986279.29688 | 48.828125 | 0 | 33.226 | 33.021 | 0 | checked | Uzka prerusovana cara; pozadovany pocet pulzu splnuje periodu PPS. | city
260926/1259_170000_260926.raw | E:\iq_data\mesto_1_2509_3009_2026\260926\1259_170000_260926.raw | 1259_170000_260926.raw | 260926 | 26-Sep-2026 17:00:00 | 1 | 2398633984 | 5 | 1 | present | 1 | 4 | 4 | 1314986286.985 | -13713.015 | 0.089 | 1314986279.29688 | 48.828125 | 0 | 34.412 | 33.158 | 0 | checked | Uzka prerusovana cara; pozadovany pocet pulzu splnuje periodu PPS. | city
260926/1260_171000_260926.raw | E:\iq_data\mesto_1_2509_3009_2026\260926\1260_171000_260926.raw | 1260_171000_260926.raw | 260926 | 26-Sep-2026 17:10:00 | 1 | 2399158272 | 5 | 1 | present | 1 | 4 | 4 | 1314986325.975 | -13674.025 | 0.182 | 1314986328.125 | 48.828125 | 0 | 34.833 | 33.844 | 0 | checked | Uzka prerusovana cara; pozadovany pocet pulzu splnuje periodu PPS. | city
260926/1261_172000_260926.raw | E:\iq_data\mesto_1_2509_3009_2026\260926\1261_172000_260926.raw | 1261_172000_260926.raw | 260926 | 26-Sep-2026 17:20:00 | 1 | 2399158272 | 5 | 1 | present | 1 | 4 | 5 | 1314986373.835 | -13626.165 | 0.178 | 1314986376.95313 | 48.828125 | 0 | 34.773 | 33.555 | 0 | checked | Uzka prerusovana cara; pozadovany pocet pulzu splnuje periodu PPS. | city
260926/1262_173000_260926.raw | E:\iq_data\mesto_1_2509_3009_2026\260926\1262_173000_260926.raw | 1262_173000_260926.raw | 260926 | 26-Sep-2026 17:30:00 | 1 | 2399158272 | 5 | 1 | present | 1 | 4 | 5 | 1314986432.339 | -13567.661 | 0.009 | 1314986425.78125 | 48.828125 | 0 | 28.748 | 30.041 | 0 | checked | Uzka prerusovana cara; pozadovany pocet pulzu splnuje periodu PPS. | city
260926/1263_174000_260926.raw | E:\iq_data\mesto_1_2509_3009_2026\260926\1263_174000_260926.raw | 1263_174000_260926.raw | 260926 | 26-Sep-2026 17:40:00 | 1 | 2399158272 | 5 | 1 | present | 1 | 4 | 4 | 1314986495.961 | -13504.039 | 0.253 | 1314986474.60938 | 48.828125 | 0 | 34.091 | 33.756 | 0 | checked | Uzka prerusovana cara; pozadovany pocet pulzu splnuje periodu PPS. | city
260926/1264_175000_260926.raw | E:\iq_data\mesto_1_2509_3009_2026\260926\1264_175000_260926.raw | 1264_175000_260926.raw | 260926 | 26-Sep-2026 17:50:00 | 1 | 2399158272 | 5 | 1 | present | 1 | 4 | 4 | 1314986569.812 | -13430.188 | 0.241 | 1314986572.26563 | 48.828125 | 0 | 33.72 | 33.442 | 0 | checked | Uzka prerusovana cara; pozadovany pocet pulzu splnuje periodu PPS. | city
260926/1265_180000_260926.raw | E:\iq_data\mesto_1_2509_3009_2026\260926\1265_180000_260926.raw | 1265_180000_260926.raw | 260926 | 26-Sep-2026 18:00:00 | 1 | 2399158272 | 5 | 1 | present | 1 | 4 | 5 | 1314986644.717 | -13355.283 | 0.207 | 1314986621.09375 | 48.828125 | 0 | 33.829 | 33.211 | 0 | checked | Uzka prerusovana cara; pozadovany pocet pulzu splnuje periodu PPS. | city
260926/1266_181000_260926.raw | E:\iq_data\mesto_1_2509_3009_2026\260926\1266_181000_260926.raw | 1266_181000_260926.raw | 260926 | 26-Sep-2026 18:10:00 | 1 | 2399158272 | 5 | 1 | present | 1 | 4 | 4 | 1314986728.904 | -13271.096 | 0.186 | 1314986718.75 | 48.828125 | 0 | 31.034 | 30.565 | 0 | checked | Uzka prerusovana cara; pozadovany pocet pulzu splnuje periodu PPS. | city
260926/1267_182000_260926.raw | E:\iq_data\mesto_1_2509_3009_2026\260926\1267_182000_260926.raw | 1267_182000_260926.raw | 260926 | 26-Sep-2026 18:20:00 | 1 | 2399158272 | 5 | 1 | present | 1 | 4 | 4 | 1314986816.507 | -13183.493 | 0.151 | 1314986816.40625 | 48.828125 | 0 | 33.893 | 33.509 | 0 | checked | Uzka prerusovana cara; pozadovany pocet pulzu splnuje periodu PPS. | city
260926/1268_183000_260926.raw | E:\iq_data\mesto_1_2509_3009_2026\260926\1268_183000_260926.raw | 1268_183000_260926.raw | 260926 | 26-Sep-2026 18:30:00 | 1 | 2399158272 | 5 | 1 | present | 1 | 4 | 5 | 1314986907.707 | -13092.293 | 0.332 | 1314986914.0625 | 48.828125 | 0 | 32.791 | 33.036 | 0 | checked | Uzka prerusovana cara; pozadovany pocet pulzu splnuje periodu PPS. | city
260926/1269_184000_260926.raw | E:\iq_data\mesto_1_2509_3009_2026\260926\1269_184000_260926.raw | 1269_184000_260926.raw | 260926 | 26-Sep-2026 18:40:00 | 1 | 2399158272 | 5 | 1 | present | 1 | 4 | 5 | 1314987005.068 | -12994.932 | 0.142 | 1314987011.71875 | 48.828125 | 0 | 34.003 | 33.357 | 0 | checked | Uzka prerusovana cara; pozadovany pocet pulzu splnuje periodu PPS. | city
260926/1270_185000_260926.raw | E:\iq_data\mesto_1_2509_3009_2026\260926\1270_185000_260926.raw | 1270_185000_260926.raw | 260926 | 26-Sep-2026 18:50:00 | 1 | 2399158272 | 5 | 1 | present | 1 | 4 | 4 | 1314987104.164 | -12895.836 | 0.241 | 1314987109.375 | 48.828125 | 0 | 32.789 | 33.023 | 0 | checked | Uzka prerusovana cara; pozadovany pocet pulzu splnuje periodu PPS. | city
260926/1271_190000_260926.raw | E:\iq_data\mesto_1_2509_3009_2026\260926\1271_190000_260926.raw | 1271_190000_260926.raw | 260926 | 26-Sep-2026 19:00:00 | 1 | 2399158272 | 5 | 1 | present | 1 | 4 | 4 | 1314987211.861 | -12788.139 | 0.265 | 1314987207.03125 | 48.828125 | 0 | 33.703 | 33.121 | 0 | checked | Uzka prerusovana cara; pozadovany pocet pulzu splnuje periodu PPS. | city
260926/1272_191000_260926.raw | E:\iq_data\mesto_1_2509_3009_2026\260926\1272_191000_260926.raw | 1272_191000_260926.raw | 260926 | 26-Sep-2026 19:10:00 | 1 | 2399158272 | 5 | 1 | present | 1 | 4 | 5 | 1314987316.438 | -12683.562 | 0.267 | 1314987304.6875 | 48.828125 | 0 | 32.834 | 33.107 | 0 | checked | Uzka prerusovana cara; pozadovany pocet pulzu splnuje periodu PPS. | city
260926/1273_192000_260926.raw | E:\iq_data\mesto_1_2509_3009_2026\260926\1273_192000_260926.raw | 1273_192000_260926.raw | 260926 | 26-Sep-2026 19:20:00 | 1 | 2399158272 | 5 | 1 | present | 1 | 4 | 5 | 1314987418.656 | -12581.344 | 0.406 | 1314987451.17188 | 48.828125 | 0.005 | 33.02 | 32.793 | 0 | checked | Uzka prerusovana cara; pozadovany pocet pulzu splnuje periodu PPS. | city
260926/1274_193000_260926.raw | E:\iq_data\mesto_1_2509_3009_2026\260926\1274_193000_260926.raw | 1274_193000_260926.raw | 260926 | 26-Sep-2026 19:30:00 | 1 | 2399256576 | 5 | 1 | present | 1 | 4 | 5 | 1314987528.357 | -12471.643 | 0.324 | 1314987548.82813 | 48.828125 | 0 | 32.709 | 32.146 | 0 | checked | Uzka prerusovana cara; pozadovany pocet pulzu splnuje periodu PPS. | city
260926/1275_194000_260926.raw | E:\iq_data\mesto_1_2509_3009_2026\260926\1275_194000_260926.raw | 1275_194000_260926.raw | 260926 | 26-Sep-2026 19:40:00 | 1 | 2399158272 | 5 | 1 | present | 1 | 4 | 4 | 1314987635.772 | -12364.228 | 0.053 | 1314987646.48438 | 48.828125 | 0.005 | 32.055 | 32.388 | 0 | checked | Uzka prerusovana cara; pozadovany pocet pulzu splnuje periodu PPS. | city
260926/1276_195000_260926.raw | E:\iq_data\mesto_1_2509_3009_2026\260926\1276_195000_260926.raw | 1276_195000_260926.raw | 260926 | 26-Sep-2026 19:50:00 | 1 | 2399158272 | 5 | 1 | present | 1 | 4 | 4 | 1314987740.474 | -12259.526 | 0.18 | 1314987744.14063 | 48.828125 | 0 | 33.004 | 33.442 | 0 | checked | Uzka prerusovana cara; pozadovany pocet pulzu splnuje periodu PPS. | city
260926/1277_200000_260926.raw | E:\iq_data\mesto_1_2509_3009_2026\260926\1277_200000_260926.raw | 1277_200000_260926.raw | 260926 | 26-Sep-2026 20:00:00 | 1 | 2399158272 | 5 | 1 | present | 1 | 4 | 5 | 1314987842.762 | -12157.238 | 0.145 | 1314987841.79688 | 48.828125 | 0 | 31.684 | 32.016 | 0 | checked | Uzka prerusovana cara; pozadovany pocet pulzu splnuje periodu PPS. | city
260926/1278_201000_260926.raw | E:\iq_data\mesto_1_2509_3009_2026\260926\1278_201000_260926.raw | 1278_201000_260926.raw | 260926 | 26-Sep-2026 20:10:00 | 1 | 2399158272 | 5 | 1 | present | 1 | 5 | 5 | 1314987938.639 | -12061.361 | 0.345 | 1314987939.45313 | 48.828125 | 0.03 | 32.099 | 31.507 | 0 | checked | Uzka prerusovana cara; pozadovany pocet pulzu splnuje periodu PPS. | city
260926/1279_202000_260926.raw | E:\iq_data\mesto_1_2509_3009_2026\260926\1279_202000_260926.raw | 1279_202000_260926.raw | 260926 | 26-Sep-2026 20:20:00 | 1 | 2399158272 | 5 | 1 | present | 1 | 4 | 4 | 1314988027.519 | -11972.481 | 0.091 | 1314988037.10938 | 48.828125 | 0 | 34.5 | 33.843 | 0 | checked | Uzka prerusovana cara; pozadovany pocet pulzu splnuje periodu PPS. | city
260926/1280_203000_260926.raw | E:\iq_data\mesto_1_2509_3009_2026\260926\1280_203000_260926.raw | 1280_203000_260926.raw | 260926 | 26-Sep-2026 20:30:00 | 1 | 2399158272 | 5 | 1 | present | 1 | 4 | 5 | 1314988102.162 | -11897.838 | 0.033 | 1314988085.9375 | 48.828125 | 0 | 33.543 | 33.311 | 0 | checked | Uzka prerusovana cara; pozadovany pocet pulzu splnuje periodu PPS. | city
260926/1281_204000_260926.raw | E:\iq_data\mesto_1_2509_3009_2026\260926\1281_204000_260926.raw | 1281_204000_260926.raw | 260926 | 26-Sep-2026 20:40:00 | 1 | 2397061120 | 5 | 1 | present | 1 | 4 | 5 | 1314988175.577 | -11824.423 | 0.33 | 1314988183.59375 | 48.828125 | 0 | 32.317 | 32.633 | 0 | checked | Uzka prerusovana cara; pozadovany pocet pulzu splnuje periodu PPS. | city
260926/1282_205000_260926.raw | E:\iq_data\mesto_1_2509_3009_2026\260926\1282_205000_260926.raw | 1282_205000_260926.raw | 260926 | 26-Sep-2026 20:50:00 | 1 | 2399158272 | 5 | 1 | present | 1 | 4 | 4 | 1314988223.445 | -11776.555 | 0.144 | 1314988232.42188 | 48.828125 | 0 | 30.915 | 31.708 | 0 | checked | Uzka prerusovana cara; pozadovany pocet pulzu splnuje periodu PPS. | city
260926/1283_210000_260926.raw | E:\iq_data\mesto_1_2509_3009_2026\260926\1283_210000_260926.raw | 1283_210000_260926.raw | 260926 | 26-Sep-2026 21:00:00 | 1 | 2399158272 | 5 | 1 | present | 1 | 4 | 4 | 1314988274.002 | -11725.998 | 0.078 | 1314988281.25 | 48.828125 | 0 | 31.318 | 32.499 | 0 | checked | Uzka prerusovana cara; pozadovany pocet pulzu splnuje periodu PPS. | city
260926/1284_211000_260926.raw | E:\iq_data\mesto_1_2509_3009_2026\260926\1284_211000_260926.raw | 1284_211000_260926.raw | 260926 | 26-Sep-2026 21:10:00 | 1 | 2399158272 | 5 | 1 | present | 1 | 4 | 5 | 1314988310.289 | -11689.711 | 0.046 | 1314988330.07813 | 48.828125 | 0 | 33.578 | 32.92 | 0 | checked | Uzka prerusovana cara; pozadovany pocet pulzu splnuje periodu PPS. | city
260926/1285_212000_260926.raw | E:\iq_data\mesto_1_2509_3009_2026\260926\1285_212000_260926.raw | 1285_212000_260926.raw | 260926 | 26-Sep-2026 21:20:00 | 1 | 2399158272 | 5 | 1 | present | 1 | 4 | 5 | 1314988350.492 | -11649.508 | 0.012 | 1314988330.07813 | 48.828125 | 0 | 30.599 | 30.932 | 0 | checked | Uzka prerusovana cara; pozadovany pocet pulzu splnuje periodu PPS. | city
260926/1286_213000_260926.raw | E:\iq_data\mesto_1_2509_3009_2026\260926\1286_213000_260926.raw | 1286_213000_260926.raw | 260926 | 26-Sep-2026 21:30:00 | 1 | 2399158272 | 5 | 1 | present | 1 | 5 | 5 | 1314988381.362 | -11618.638 | 0.083 | 1314988378.90625 | 48.828125 | 0.03 | 33.304 | 32.552 | 0 | checked | Uzka prerusovana cara; pozadovany pocet pulzu splnuje periodu PPS. | city
260926/1287_214000_260926.raw | E:\iq_data\mesto_1_2509_3009_2026\260926\1287_214000_260926.raw | 1287_214000_260926.raw | 260926 | 26-Sep-2026 21:40:00 | 1 | 2399158272 | 5 | 1 | present | 1 | 4 | 4 | 1314988421.933 | -11578.067 | 0.11 | 1314988427.73438 | 48.828125 | 0 | 33.673 | 31.148 | 0 | checked | Uzka prerusovana cara; pozadovany pocet pulzu splnuje periodu PPS. | city
260926/1288_215000_260926.raw | E:\iq_data\mesto_1_2509_3009_2026\260926\1288_215000_260926.raw | 1288_215000_260926.raw | 260926 | 26-Sep-2026 21:50:00 | 1 | 2399158272 | 5 | 1 | present | 1 | 4 | 4 | 1314988454.961 | -11545.039 | 0.117 | 1314988476.5625 | 48.828125 | 0 | 33.27 | 31.974 | 0 | checked | Uzka prerusovana cara; pozadovany pocet pulzu splnuje periodu PPS. | city
260926/1289_220000_260926.raw | E:\iq_data\mesto_1_2509_3009_2026\260926\1289_220000_260926.raw | 1289_220000_260926.raw | 260926 | 26-Sep-2026 22:00:00 | 1 | 2399158272 | 5 | 1 | present | 1 | 4 | 5 | 1314988489.806 | -11510.194 | 0.146 | 1314988476.5625 | 48.828125 | 0 | 34.056 | 32.872 | 0 | checked | Uzka prerusovana cara; pozadovany pocet pulzu splnuje periodu PPS. | city
260926/1290_221000_260926.raw | E:\iq_data\mesto_1_2509_3009_2026\260926\1290_221000_260926.raw | 1290_221000_260926.raw | 260926 | 26-Sep-2026 22:10:00 | 1 | 2399158272 | 5 | 1 | present | 1 | 5 | 5 | 1314988519.925 | -11480.075 | 0.046 | 1314988525.39063 | 48.828125 | 0.025 | 33.208 | 32.446 | 0 | checked | Uzka prerusovana cara; pozadovany pocet pulzu splnuje periodu PPS. | city
260926/1291_222000_260926.raw | E:\iq_data\mesto_1_2509_3009_2026\260926\1291_222000_260926.raw | 1291_222000_260926.raw | 260926 | 26-Sep-2026 22:20:00 | 1 | 2399158272 | 5 | 1 | present | 1 | 4 | 4 | 1314988548.385 | -11451.615 | 0.156 | 1314988525.39063 | 48.828125 | 0 | 33.784 | 32.896 | 0 | checked | Uzka prerusovana cara; pozadovany pocet pulzu splnuje periodu PPS. | city
260926/1292_223000_260926.raw | E:\iq_data\mesto_1_2509_3009_2026\260926\1292_223000_260926.raw | 1292_223000_260926.raw | 260926 | 26-Sep-2026 22:30:00 | 1 | 2399158272 | 5 | 1 | present | 1 | 4 | 4 | 1314988578.485 | -11421.515 | 0.086 | 1314988574.21875 | 48.828125 | 0 | 31.085 | 32.222 | 0 | checked | Uzka prerusovana cara; pozadovany pocet pulzu splnuje periodu PPS. | city
260926/1293_224000_260926.raw | E:\iq_data\mesto_1_2509_3009_2026\260926\1293_224000_260926.raw | 1293_224000_260926.raw | 260926 | 26-Sep-2026 22:40:00 | 1 | 2399158272 | 5 | 1 | present | 1 | 4 | 5 | 1314988613.677 | -11386.323 | 0.09 | 1314988623.04688 | 48.828125 | 0 | 34.253 | 33.322 | 0 | checked | Uzka prerusovana cara; pozadovany pocet pulzu splnuje periodu PPS. | city
260926/1294_225000_260926.raw | E:\iq_data\mesto_1_2509_3009_2026\260926\1294_225000_260926.raw | 1294_225000_260926.raw | 260926 | 26-Sep-2026 22:50:00 | 1 | 2399158272 | 5 | 1 | present | 1 | 5 | 5 | 1314988640.433 | -11359.567 | 0.063 | 1314988623.04688 | 48.828125 | 0.025 | 33.927 | 33.16 | 0 | checked | Uzka prerusovana cara; pozadovany pocet pulzu splnuje periodu PPS. | city
260926/1295_230000_260926.raw | E:\iq_data\mesto_1_2509_3009_2026\260926\1295_230000_260926.raw | 1295_230000_260926.raw | 260926 | 26-Sep-2026 23:00:00 | 1 | 2399158272 | 5 | 1 | present | 1 | 4 | 4 | 1314988671.04 | -11328.96 | 0.032 | 1314988671.875 | 48.828125 | 0 | 33.547 | 32.915 | 0 | checked | Uzka prerusovana cara; pozadovany pocet pulzu splnuje periodu PPS. | city
260926/1296_231000_260926.raw | E:\iq_data\mesto_1_2509_3009_2026\260926\1296_231000_260926.raw | 1296_231000_260926.raw | 260926 | 26-Sep-2026 23:10:00 | 1 | 2397585408 | 5 | 1 | present | 1 | 4 | 5 | 1314988707.452 | -11292.548 | 0.032 | 1314988720.70313 | 48.828125 | 0 | 34.845 | 33.958 | 0 | checked | Uzka prerusovana cara; pozadovany pocet pulzu splnuje periodu PPS. | city
260926/1297_232000_260926.raw | E:\iq_data\mesto_1_2509_3009_2026\260926\1297_232000_260926.raw | 1297_232000_260926.raw | 260926 | 26-Sep-2026 23:20:00 | 1 | 2398109696 | 5 | 1 | present | 1 | 4 | 5 | 1314988739.249 | -11260.751 | 0.064 | 1314988769.53125 | 48.828125 | 0 | 34.387 | 33.785 | 0 | checked | Uzka prerusovana cara; pozadovany pocet pulzu splnuje periodu PPS. | city
260926/1298_233000_260926.raw | E:\iq_data\mesto_1_2509_3009_2026\260926\1298_233000_260926.raw | 1298_233000_260926.raw | 260926 | 26-Sep-2026 23:30:00 | 1 | 2399158272 | 5 | 1 | present | 1 | 4 | 4 | 1314988764.665 | -11235.335 | 0.016 | 1314988769.53125 | 48.828125 | 0 | 34.352 | 33.636 | 0 | checked | Uzka prerusovana cara; pozadovany pocet pulzu splnuje periodu PPS. | city
260926/1299_234000_260926.raw | E:\iq_data\mesto_1_2509_3009_2026\260926\1299_234000_260926.raw | 1299_234000_260926.raw | 260926 | 26-Sep-2026 23:40:00 | 1 | 2399158272 | 5 | 1 | present | 1 | 4 | 4 | 1314988802.309 | -11197.691 | 0.099 | 1314988818.35938 | 48.828125 | 0 | 32.876 | 32.858 | 0 | checked | Uzka prerusovana cara; pozadovany pocet pulzu splnuje periodu PPS. | city
260926/1300_235000_260926.raw | E:\iq_data\mesto_1_2509_3009_2026\260926\1300_235000_260926.raw | 1300_235000_260926.raw | 260926 | 26-Sep-2026 23:50:00 | 1 | 2399158272 | 5 | 1 | present | 1 | 4 | 5 | 1314988836.405 | -11163.595 | 0.08 | 1314988818.35938 | 48.828125 | 0 | 34.627 | 33.618 | 0 | checked | Uzka prerusovana cara; pozadovany pocet pulzu splnuje periodu PPS. | city
270926/1301_000000_270926.raw | E:\iq_data\mesto_1_2509_3009_2026\270926\1301_000000_270926.raw | 1301_000000_270926.raw | 270926 | 27-Sep-2026 00:00:00 | 1 | 2399158272 | 5 | 1 | present | 1 | 5 | 5 | 1314988860.99 | -11139.01 | 0.083 | 1314988867.1875 | 48.828125 | 0.025 | 34.144 | 33.57 | 0 | checked | Uzka prerusovana cara; pozadovany pocet pulzu splnuje periodu PPS. | city
270926/1302_001000_270926.raw | E:\iq_data\mesto_1_2509_3009_2026\270926\1302_001000_270926.raw | 1302_001000_270926.raw | 270926 | 27-Sep-2026 00:10:00 | 1 | 2399158272 | 5 | 1 | present | 1 | 4 | 4 | 1314988885.633 | -11114.367 | 0.084 | 1314988867.1875 | 48.828125 | 0 | 34.443 | 34.102 | 0 | checked | Uzka prerusovana cara; pozadovany pocet pulzu splnuje periodu PPS. | city
270926/1303_002000_270926.raw | E:\iq_data\mesto_1_2509_3009_2026\270926\1303_002000_270926.raw | 1303_002000_270926.raw | 270926 | 27-Sep-2026 00:20:00 | 1 | 2399158272 | 5 | 1 | present | 1 | 4 | 4 | 1314988904.099 | -11095.901 | 0.111 | 1314988916.01563 | 48.828125 | 0.005 | 34.687 | 34.225 | 0 | checked | Uzka prerusovana cara; pozadovany pocet pulzu splnuje periodu PPS. | city
270926/1304_003000_270926.raw | E:\iq_data\mesto_1_2509_3009_2026\270926\1304_003000_270926.raw | 1304_003000_270926.raw | 270926 | 27-Sep-2026 00:30:00 | 1 | 2400206848 | 5 | 1 | present | 1 | 4 | 5 | 1314988922.539 | -11077.461 | 0.019 | 1314988916.01563 | 48.828125 | 0 | 34.535 | 34.804 | 0 | checked | Uzka prerusovana cara; pozadovany pocet pulzu splnuje periodu PPS. | city
270926/1305_004000_270926.raw | E:\iq_data\mesto_1_2509_3009_2026\270926\1305_004000_270926.raw | 1305_004000_270926.raw | 270926 | 27-Sep-2026 00:40:00 | 1 | 2399158272 | 5 | 1 | present | 1 | 4 | 5 | 1314988945.549 | -11054.451 | 0.025 | 1314988964.84375 | 48.828125 | 0 | 35.422 | 35.176 | 0 | checked | Uzka prerusovana cara; pozadovany pocet pulzu splnuje periodu PPS. | city
270926/1306_005000_270926.raw | E:\iq_data\mesto_1_2509_3009_2026\270926\1306_005000_270926.raw | 1306_005000_270926.raw | 270926 | 27-Sep-2026 00:50:00 | 1 | 2399158272 | 5 | 1 | present | 1 | 5 | 5 | 1314988949.823 | -11050.177 | 0.043 | 1314988964.84375 | 48.828125 | 0.03 | 34.888 | 34.912 | 0 | checked | Uzka prerusovana cara; pozadovany pocet pulzu splnuje periodu PPS. | city
270926/1307_010000_270926.raw | E:\iq_data\mesto_1_2509_3009_2026\270926\1307_010000_270926.raw | 1307_010000_270926.raw | 270926 | 27-Sep-2026 01:00:00 | 1 | 2399158272 | 5 | 1 | present | 1 | 4 | 4 | 1314988961.668 | -11038.332 | 0.082 | 1314988964.84375 | 48.828125 | 0.005 | 34.876 | 35.056 | 0 | checked | Uzka prerusovana cara; pozadovany pocet pulzu splnuje periodu PPS. | city
270926/1308_011000_270926.raw | E:\iq_data\mesto_1_2509_3009_2026\270926\1308_011000_270926.raw | 1308_011000_270926.raw | 270926 | 27-Sep-2026 01:10:00 | 1 | 2399158272 | 5 | 1 | present | 1 | 4 | 4 | 1314988968.335 | -11031.665 | 0.144 | 1314988964.84375 | 48.828125 | 0 | 32.869 | 32.593 | 0 | checked | Uzka prerusovana cara; pozadovany pocet pulzu splnuje periodu PPS. | city
270926/1309_012000_270926.raw | E:\iq_data\mesto_1_2509_3009_2026\270926\1309_012000_270926.raw | 1309_012000_270926.raw | 270926 | 27-Sep-2026 01:20:00 | 1 | 2399158272 | 5 | 1 | present | 1 | 4 | 5 | 1314988963.034 | -11036.966 | 0.054 | 1314988964.84375 | 48.828125 | 0 | 36.523 | 35.738 | 0 | checked | Uzka prerusovana cara; pozadovany pocet pulzu splnuje periodu PPS. | city
270926/1310_013000_270926.raw | E:\iq_data\mesto_1_2509_3009_2026\270926\1310_013000_270926.raw | 1310_013000_270926.raw | 270926 | 27-Sep-2026 01:30:00 | 1 | 2399158272 | 5 | 1 | present | 1 | 4 | 5 | 1314988980.731 | -11019.269 | 0.109 | 1314989013.67188 | 48.828125 | 0 | 35.123 | 34.63 | 0 | checked | Uzka prerusovana cara; pozadovany pocet pulzu splnuje periodu PPS. | city
270926/1311_014000_270926.raw | E:\iq_data\mesto_1_2509_3009_2026\270926\1311_014000_270926.raw | 1311_014000_270926.raw | 270926 | 27-Sep-2026 01:40:00 | 1 | 2399158272 | 5 | 1 | present | 1 | 4 | 4 | 1314988984.974 | -11015.026 | 0.087 | 1314989013.67188 | 48.828125 | 0 | 35.582 | 34.519 | 0 | checked | Uzka prerusovana cara; pozadovany pocet pulzu splnuje periodu PPS. | city
270926/1312_015000_270926.raw | E:\iq_data\mesto_1_2509_3009_2026\270926\1312_015000_270926.raw | 1312_015000_270926.raw | 270926 | 27-Sep-2026 01:50:00 | 1 | 2399158272 | 5 | 1 | present | 1 | 4 | 4 | 1314988987.43 | -11012.57 | 0.098 | 1314989013.67188 | 48.828125 | 0 | 35.493 | 35.686 | 0 | checked | Uzka prerusovana cara; pozadovany pocet pulzu splnuje periodu PPS. | city
270926/1313_020000_270926.raw | E:\iq_data\mesto_1_2509_3009_2026\270926\1313_020000_270926.raw | 1313_020000_270926.raw | 270926 | 27-Sep-2026 02:00:00 | 1 | 2399158272 | 5 | 1 | present | 1 | 4 | 5 | 1314988986.646 | -11013.354 | 0.077 | 1314988964.84375 | 48.828125 | 0 | 35.963 | 34.892 | 0 | checked | Uzka prerusovana cara; pozadovany pocet pulzu splnuje periodu PPS. | city
270926/1314_021000_270926.raw | E:\iq_data\mesto_1_2509_3009_2026\270926\1314_021000_270926.raw | 1314_021000_270926.raw | 270926 | 27-Sep-2026 02:10:00 | 1 | 2399158272 | 5 | 1 | present | 1 | 4 | 5 | 1314988998.024 | -11001.976 | 0.081 | 1314989013.67188 | 48.828125 | 0 | 33.695 | 32.835 | 0 | checked | Uzka prerusovana cara; pozadovany pocet pulzu splnuje periodu PPS. | city
270926/1315_022000_270926.raw | E:\iq_data\mesto_1_2509_3009_2026\270926\1315_022000_270926.raw | 1315_022000_270926.raw | 270926 | 27-Sep-2026 02:20:00 | 1 | 2399158272 | 5 | 1 | present | 1 | 4 | 4 | 1314988996.651 | -11003.349 | 0.056 | 1314989013.67188 | 48.828125 | 0.005 | 34.634 | 34.318 | 0 | checked | Uzka prerusovana cara; pozadovany pocet pulzu splnuje periodu PPS. | city
270926/1316_023000_270926.raw | E:\iq_data\mesto_1_2509_3009_2026\270926\1316_023000_270926.raw | 1316_023000_270926.raw | 270926 | 27-Sep-2026 02:30:00 | 1 | 2399158272 | 5 | 1 | present | 1 | 4 | 4 | 1314989008.583 | -10991.417 | 0.051 | 1314989013.67188 | 48.828125 | 0 | 35.405 | 36.004 | 0 | checked | Uzka prerusovana cara; pozadovany pocet pulzu splnuje periodu PPS. | city
270926/1317_024000_270926.raw | E:\iq_data\mesto_1_2509_3009_2026\270926\1317_024000_270926.raw | 1317_024000_270926.raw | 270926 | 27-Sep-2026 02:40:00 | 1 | 2399158272 | 5 | 1 | present | 1 | 4 | 5 | 1314989047.136 | -10952.864 | 0.133 | 1314989062.5 | 48.828125 | 0 | 36.465 | 35.849 | 0 | checked | Uzka prerusovana cara; pozadovany pocet pulzu splnuje periodu PPS. | city
270926/1318_025000_270926.raw | E:\iq_data\mesto_1_2509_3009_2026\270926\1318_025000_270926.raw | 1318_025000_270926.raw | 270926 | 27-Sep-2026 02:50:00 | 1 | 2399158272 | 5 | 1 | present | 1 | 4 | 4 | 1314989071.267 | -10928.733 | 0.113 | 1314989062.5 | 48.828125 | 0 | 36.51 | 35.999 | 0 | checked | Uzka prerusovana cara; pozadovany pocet pulzu splnuje periodu PPS. | city
270926/1319_030000_270926.raw | E:\iq_data\mesto_1_2509_3009_2026\270926\1319_030000_270926.raw | 1319_030000_270926.raw | 270926 | 27-Sep-2026 03:00:00 | 1 | 2399158272 | 5 | 1 | present | 1 | 4 | 4 | 1314989068.979 | -10931.021 | 0.02 | 1314989062.5 | 48.828125 | 0 | 36.287 | 35.744 | 0 | checked | Uzka prerusovana cara; pozadovany pocet pulzu splnuje periodu PPS. | city
270926/1320_031000_270926.raw | E:\iq_data\mesto_1_2509_3009_2026\270926\1320_031000_270926.raw | 1320_031000_270926.raw | 270926 | 27-Sep-2026 03:10:00 | 1 | 2394439680 | 5 | 1 | present | 1 | 4 | 5 | 1314989060.775 | -10939.225 | 0.077 | 1314989062.5 | 48.828125 | 0 | 36.701 | 36.179 | 0 | checked | Uzka prerusovana cara; pozadovany pocet pulzu splnuje periodu PPS. | city
270926/1321_032000_270926.raw | E:\iq_data\mesto_1_2509_3009_2026\270926\1321_032000_270926.raw | 1321_032000_270926.raw | 270926 | 27-Sep-2026 03:20:00 | 1 | 2399158272 | 5 | 1 | present | 1 | 4 | 5 | 1314989073.952 | -10926.048 | 0.123 | 1314989062.5 | 48.828125 | 0.005 | 36.838 | 35.998 | 0 | checked | Uzka prerusovana cara; pozadovany pocet pulzu splnuje periodu PPS. | city
270926/1322_033000_270926.raw | E:\iq_data\mesto_1_2509_3009_2026\270926\1322_033000_270926.raw | 1322_033000_270926.raw | 270926 | 27-Sep-2026 03:30:00 | 1 | 2399158272 | 5 | 1 | present | 1 | 5 | 5 | 1314989073.133 | -10926.867 | 0.105 | 1314989062.5 | 48.828125 | 0.035 | 36.307 | 35.881 | 0 | checked | Uzka prerusovana cara; pozadovany pocet pulzu splnuje periodu PPS. | city
270926/1323_034000_270926.raw | E:\iq_data\mesto_1_2509_3009_2026\270926\1323_034000_270926.raw | 1323_034000_270926.raw | 270926 | 27-Sep-2026 03:40:00 | 1 | 2399158272 | 5 | 1 | present | 1 | 4 | 4 | 1314989078.123 | -10921.877 | 0.087 | 1314989062.5 | 48.828125 | 0 | 36.32 | 35.725 | 0 | checked | Uzka prerusovana cara; pozadovany pocet pulzu splnuje periodu PPS. | city
270926/1324_035000_270926.raw | E:\iq_data\mesto_1_2509_3009_2026\270926\1324_035000_270926.raw | 1324_035000_270926.raw | 270926 | 27-Sep-2026 03:50:00 | 1 | 2399158272 | 5 | 1 | present | 1 | 4 | 4 | 1314989100.731 | -10899.269 | 0.05 | 1314989111.32813 | 48.828125 | 0 | 36.644 | 35.423 | 0 | checked | Uzka prerusovana cara; pozadovany pocet pulzu splnuje periodu PPS. | city
270926/1325_040000_270926.raw | E:\iq_data\mesto_1_2509_3009_2026\270926\1325_040000_270926.raw | 1325_040000_270926.raw | 270926 | 27-Sep-2026 04:00:00 | 1 | 2399158272 | 5 | 1 | present | 1 | 4 | 5 | 1314989114.411 | -10885.589 | 0.047 | 1314989111.32813 | 48.828125 | 0 | 35.479 | 35.619 | 0 | checked | Uzka prerusovana cara; pozadovany pocet pulzu splnuje periodu PPS. | city
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
