miradolejs/c-band-downlink-analysis/results/downlink_frames/long_term_analysis/2026-09-25_2026-09-30/pair_audit.csv

File_Name | Status | Message | Result_File | Selected_Stable_Seconds | Analyzed_Seconds | Last_Scanned_Second | City_Record_SNR_dB | Village_Record_SNR_dB | City_Record_SNR_Coverage | Village_Record_SNR_Coverage | Synchronization_s | Decoding_s | Reconciliation_s | Elapsed_s
1013_000000_250926.raw | processed | See per-second status and decoder diagnostics. | C:\Users\m_dolejs\Desktop\C_PASMO_A\analyza_ramcu_v0_1_6_dni\FRAME_6D_20261023_153428_392\1013_000000_250926_frames.mat | 10 | 10 | 16 | 7.4147116256477 | 8.32739291367853 | 0.925925925925926 | 0.925833333333333 | 81.6273726 | 76.8111763 | 0.1076307 | 161.087602
1014_001000_250926.raw | processed | See per-second status and decoder diagnostics. | C:\Users\m_dolejs\Desktop\C_PASMO_A\analyza_ramcu_v0_1_6_dni\FRAME_6D_20261023_153428_392\1014_001000_250926_frames.mat | 10 | 10 | 16 | 7.46577296462697 | 8.34398895870357 | 0.925925925925926 | 0.925740740740741 | 59.9305575 | 75.3003509 | 0.0621675 | 137.1052423
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
