miradolejs/c-band-downlink-analysis/results/downlink_frames/visualization/2026-09-25_2026-09-30/02_daily_summary.pdf

## Daily frame summary

| 70.12%
| | | 66.40%
48.28% | | 55.89% | | 48.21% | 49.09% | Global 53.59 %

Daily ratio = sum(common) / sum(village)

25.09. | 26.09. | 27.09. | 28.09. | 29.09. | 30.09.

C

o

m

m

o

n / villa

g

e (%)

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
25.09. | 26.09. | 27.09. | 28.09. | 29.09. | 30.09.

Fra

m

e

s / a

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
City Village

Common
