miradolejs/c-band-downlink-analysis/results/downlink_frames/visualization/2026-09-25_2026-09-30/04_coverage.pdf

### Coverage: 747 / 864 paired records, 7470 analyzed seconds

### Day

25.09. | 26.09. | 27.09. | 28.09. | 29.09. | 30.09.

N

u

m

b

### er of p

aire

d re

c

ord

s

0

50

100

150

Analyzed

Skipped: likely noise (SNR)

Skipped: PPS

Other / no analyzed seconds
