miradolejs/c-band-downlink-analysis/results/downlink_frames/long_term_analysis/2026-09-25_2026-09-30/all_seconds.csv

File_Name | Second | Status | Stable_Run | Delta_Center_s | Drift_ppm | City_Total | Village_Total | Common | City_Only | Village_Only | Common_Over_Village | City_SNR_dB | Village_SNR_dB | City_SNR_Class | Village_SNR_Class | Excluded_Context_Or_Boundary_City | Excluded_Context_Or_Boundary_Village | Ambiguous_Repeated_Matches | Counted_Start_Interval_Lo_s | Counted_Start_Interval_Hi_s
1013_000000_250926.raw | 5 | analyzed | 1 | 0.00689491567748372 | 0.00353016842811 | 19 | 29 | 19 | 0 | 10 | 0.655172413793103 | 7.19813269420102 | 8.22464444932928 | signal_likely | signal_likely | 0 | 0 | 0 | 5.03 | 5.997
1013_000000_250926.raw | 6 | analyzed | 1 | 0.00689491345863192 | 0.0094476986620491 | 20 | 27 | 20 | 0 | 7 | 0.740740740740741 | 7.19813269420102 | 8.22464444932928 | signal_likely | signal_likely | 0 | 0 | 0 | 6.003 | 6.997
1013_000000_250926.raw | 7 | analyzed | 1 | 0.00689491398917579 | 0.000326709673807411 | 36 | 44 | 34 | 2 | 10 | 0.772727272727273 | 7.19813269420102 | 8.22464444932928 | signal_likely | signal_likely | 0 | 0 | 0 | 7.003 | 7.997
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
