miradolejs/c-band-downlink-analysis/results/downlink_frames/long_term_analysis/2026-09-25_2026-09-30/summary.csv

Analyzed_Seconds | Excluded_Seconds | City_Total | Village_Total | Common | City_Only | Village_Only | Common_Over_Village | Pairs_Processed | Pairs_Excluded_Or_Error
7470 | 0 | 143803 | 263171 | 141026 | 2777 | 122145 | 0.535872113568744 | 747 | 117
