miradolejs/c-band-downlink-analysis/results/downlink_frames/visualization/2026-09-25_2026-09-30/daily_summary.csv

Day | Pairs_Total | Pairs_Analyzed | Pairs_SNR_Skipped | Pairs_PPS_Skipped | Pairs_Other | Analyzed_Seconds | City_Total | Village_Total | Common | City_Only | Village_Only | Common_Over_Village
25-Sep-2026 | 144 | 144 | 0 | 0 | 0 | 1440 | 25560 | 51801 | 25010 | 550 | 26791 | 0.482809212177371
26-Sep-2026 | 144 | 78 | 65 | 1 | 0 | 780 | 14628 | 20671 | 14494 | 134 | 6177 | 0.701175559963234
27-Sep-2026 | 144 | 97 | 45 | 2 | 0 | 970 | 15317 | 26965 | 15071 | 246 | 11894 | 0.558909697756351
28-Sep-2026 | 144 | 143 | 0 | 1 | 0 | 1430 | 25543 | 38033 | 25254 | 289 | 12779 | 0.664002313780138
29-Sep-2026 | 144 | 142 | 0 | 2 | 0 | 1420 | 28770 | 58096 | 28009 | 761 | 30087 | 0.482115808317268
30-Sep-2026 | 144 | 143 | 0 | 1 | 0 | 1430 | 33985 | 67605 | 33188 | 797 | 34417 | 0.490910435618667
