miradolejs/c-band-downlink-analysis/results/downlink_frames/visualization/2026-09-25_2026-09-30/global_summary.csv

Pairs_Total | Pairs_Analyzed | Pairs_SNR_Skipped | Pairs_PPS_Skipped | Pairs_Other | Analyzed_Seconds | City_Total | Village_Total | Common | City_Only | Village_Only | Common_Over_Village
864 | 747 | 110 | 7 | 0 | 7470 | 143803 | 263171 | 141026 | 2777 | 122145 | 0.535872113568744
