miradolejs/c-band-downlink-analysis/results/downlink_frames/visualization/2026-09-25_2026-09-30/records_summary.csv

File_Name | Record_Time | Status | Day | Analyzed_Seconds | City_Total | Village_Total | Common | City_Only | Village_Only | Common_Over_Village | Second_Ratio_SD_pp | Second_Ratio_Min_pct | Second_Ratio_Max_pct | City_SNR_dB | Village_SNR_dB
1013_000000_250926.raw | 25-Sep-2026 00:00:00 | processed | 25-Sep-2026 | 10 | 236 | 311 | 233 | 3 | 78 | 0.7491961414791 | 5.43451890009462 | 65.5172413793103 | 80.9523809523809 | 7.4147116256477 | 8.32739291367853
1014_001000_250926.raw | 25-Sep-2026 00:10:00 | processed | 25-Sep-2026 | 10 | 190 | 272 | 186 | 4 | 86 | 0.683823529411765 | 8.93619328494992 | 55.5555555555556 | 82.1428571428571 | 7.46577296462697 | 8.34398895870357
1015_002000_250926.raw | 25-Sep-2026 00:20:00 | processed | 25-Sep-2026 | 10 | 196 | 256 | 193 | 3 | 63 | 0.75390625 | 11.2550249898447 | 47.6190476190476 | 85.2941176470588 | 7.50837748778934 | 8.45296823751898
1016_003000_250926.raw | 25-Sep-2026 00:30:00 | processed | 25-Sep-2026 | 10 | 186 | 256 | 185 | 1 | 71 | 0.72265625 | 9.1494661874625 | 60 | 88.8888888888889 | 7.6393292207298 | 8.4550029108677
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
