miradolejs/c-band-downlink-analysis/results/downlink_frames/visualization/2026-09-25_2026-09-30/02_daily_summary.png

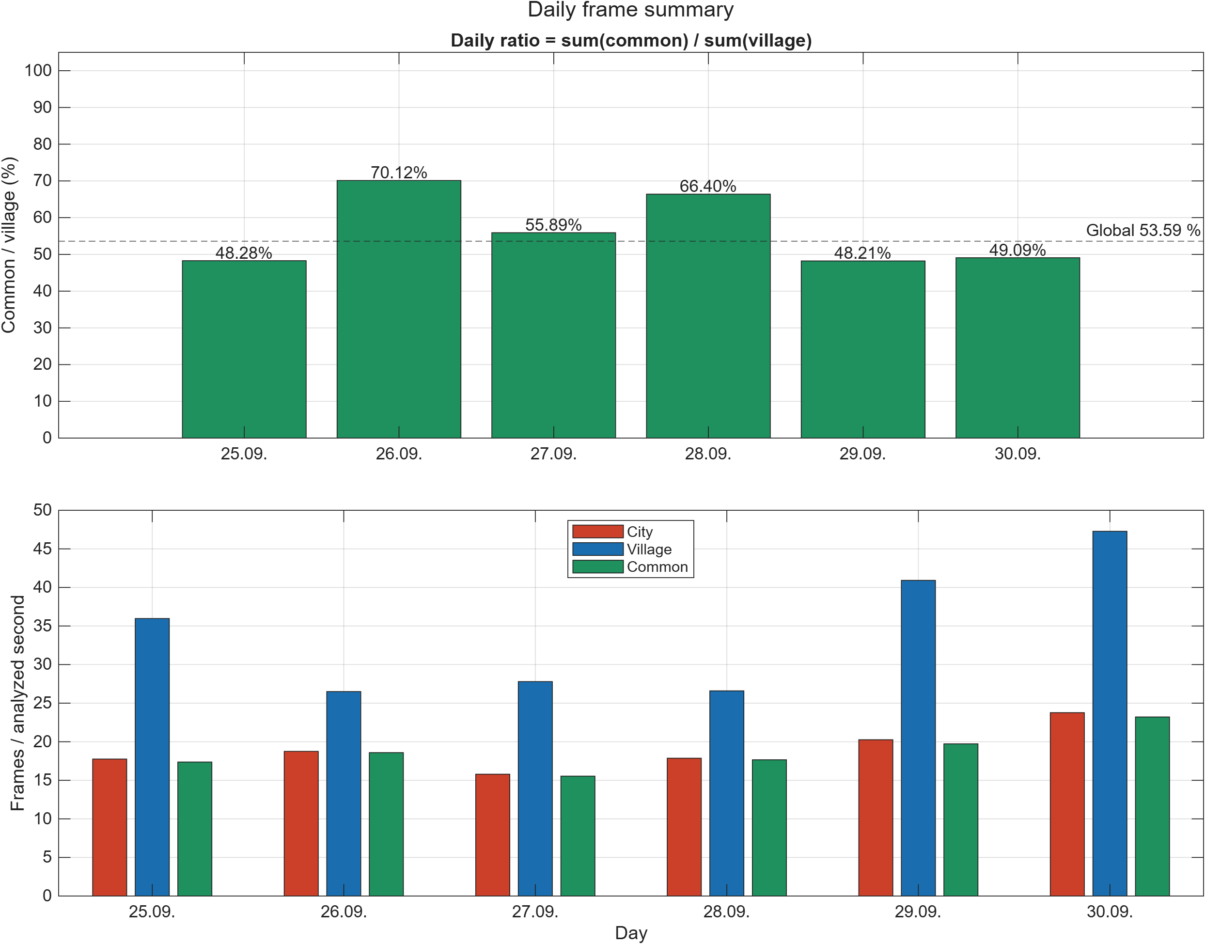
results/downlink_frames/visualization/2026-09-25_2026-09-30/02_daily_summary.png
