miradolejs/c-band-downlink-analysis/results/noise_statistics/2026-09-18_2026-09-30/Merged_noise_20260918_20260930_20261029_070140_463.png

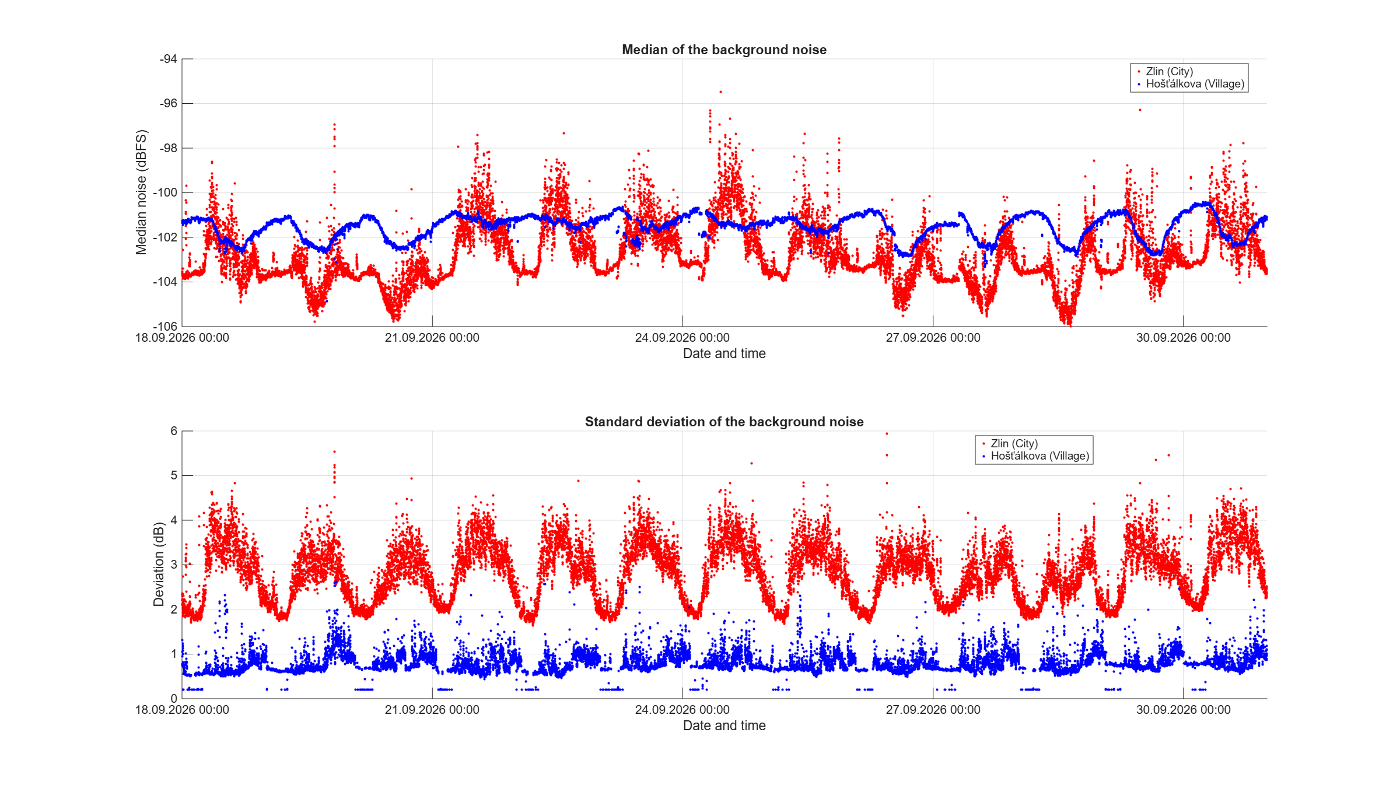
results/noise_statistics/2026-09-18_2026-09-30/Merged_noise_20260918_20260930_20261029_070140_463.png
