miradolejs/c-band-downlink-analysis/results/noise_statistics/2026-10-16_2026-10-25/Merged_noise_20261016_20261025_20261030_060948_432.png

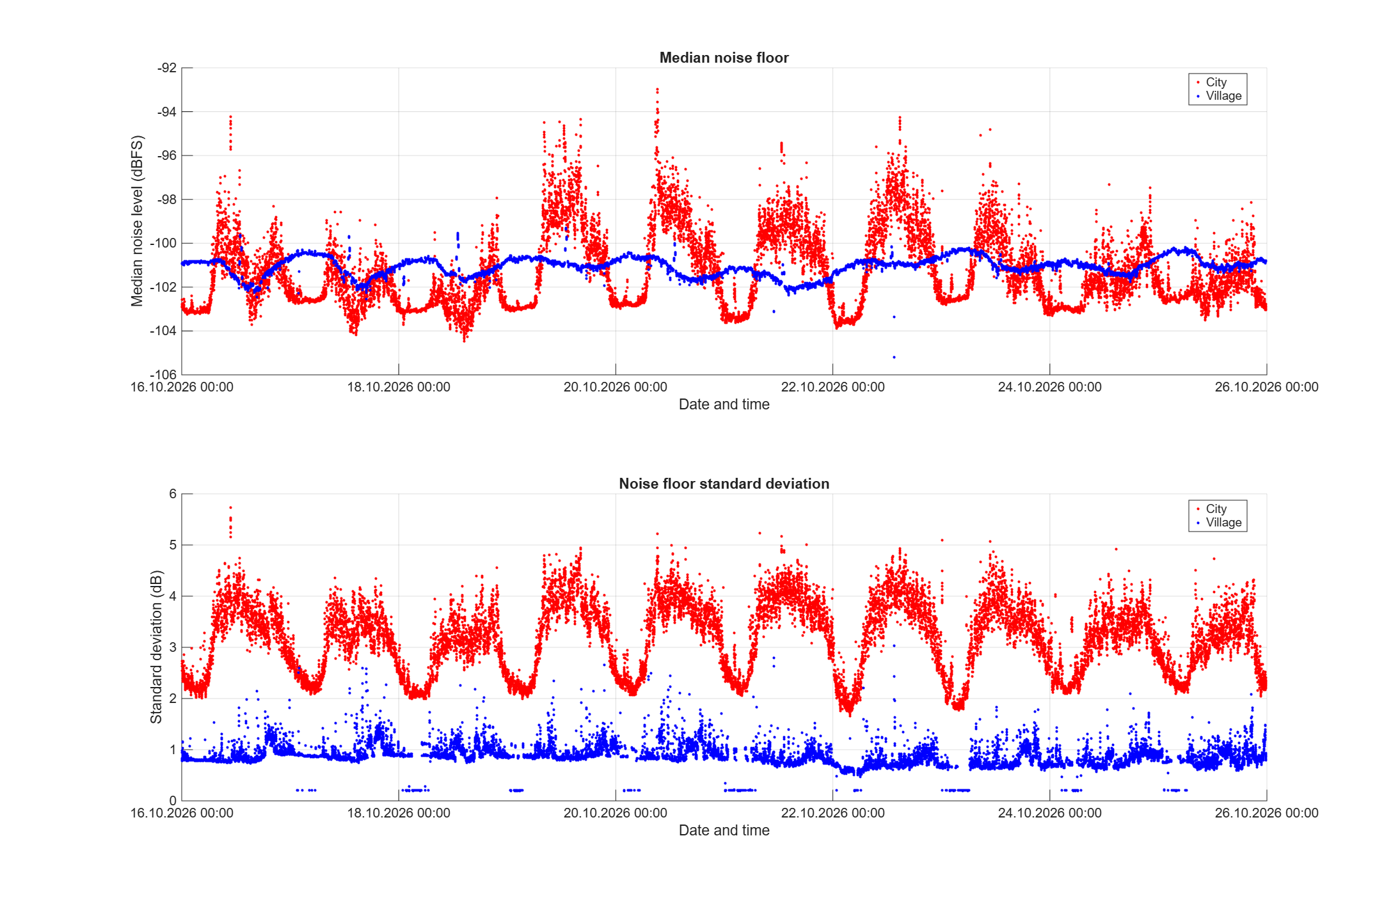
results/noise_statistics/2026-10-16_2026-10-25/Merged_noise_20261016_20261025_20261030_060948_432.png
