miradolejs/c-band-downlink-analysis/results/noise_temperature/2026-09-18_2026-09-30/city/Merged_temperature_noise_city_20260918_20260930_20261029_074336_285.png

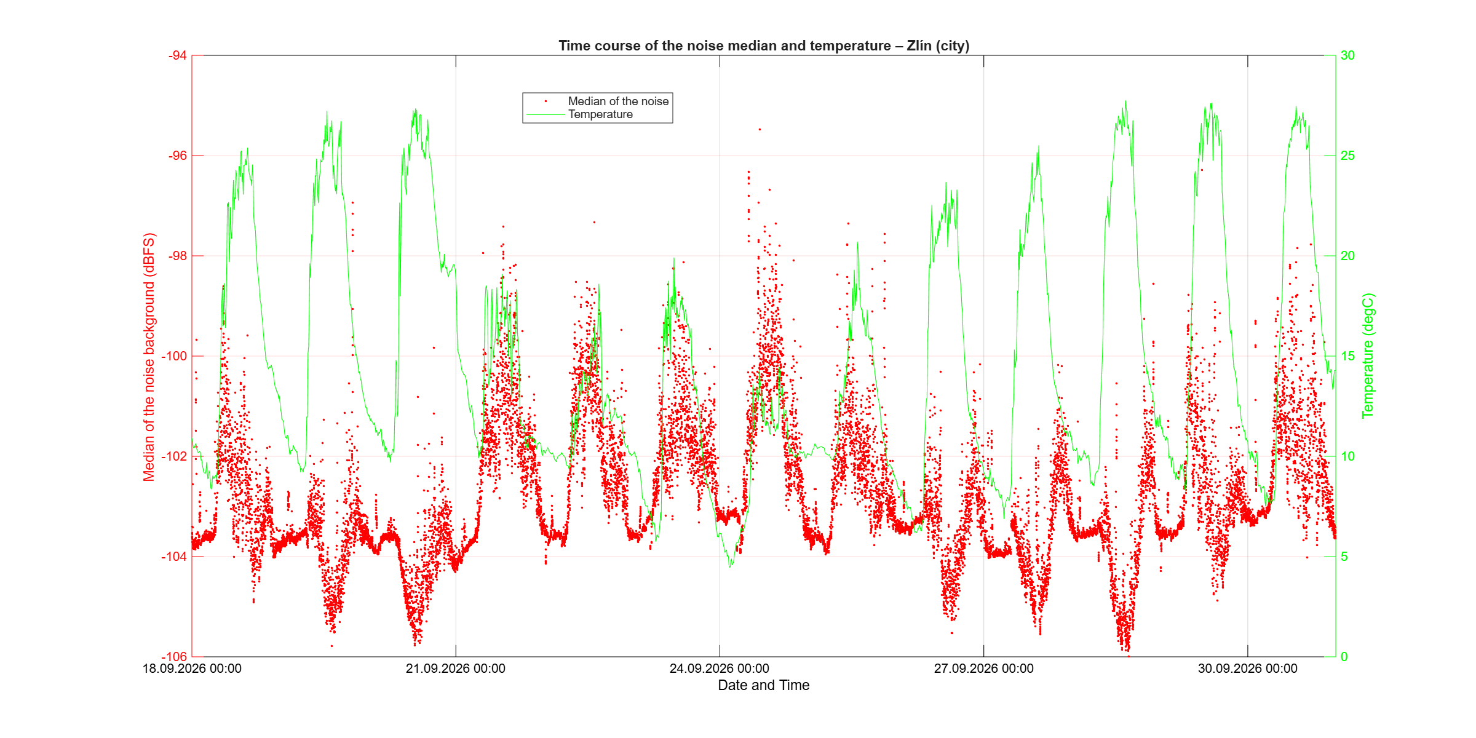
results/noise_temperature/2026-09-18_2026-09-30/city/Merged_temperature_noise_city_20260918_20260930_20261029_074336_285.png
