miradolejs/c-band-downlink-analysis/results/noise_temperature/2026-09-18_2026-09-30/village/Merged_temperature_noise_village_20260918_20260930_20261029_074619_887.png

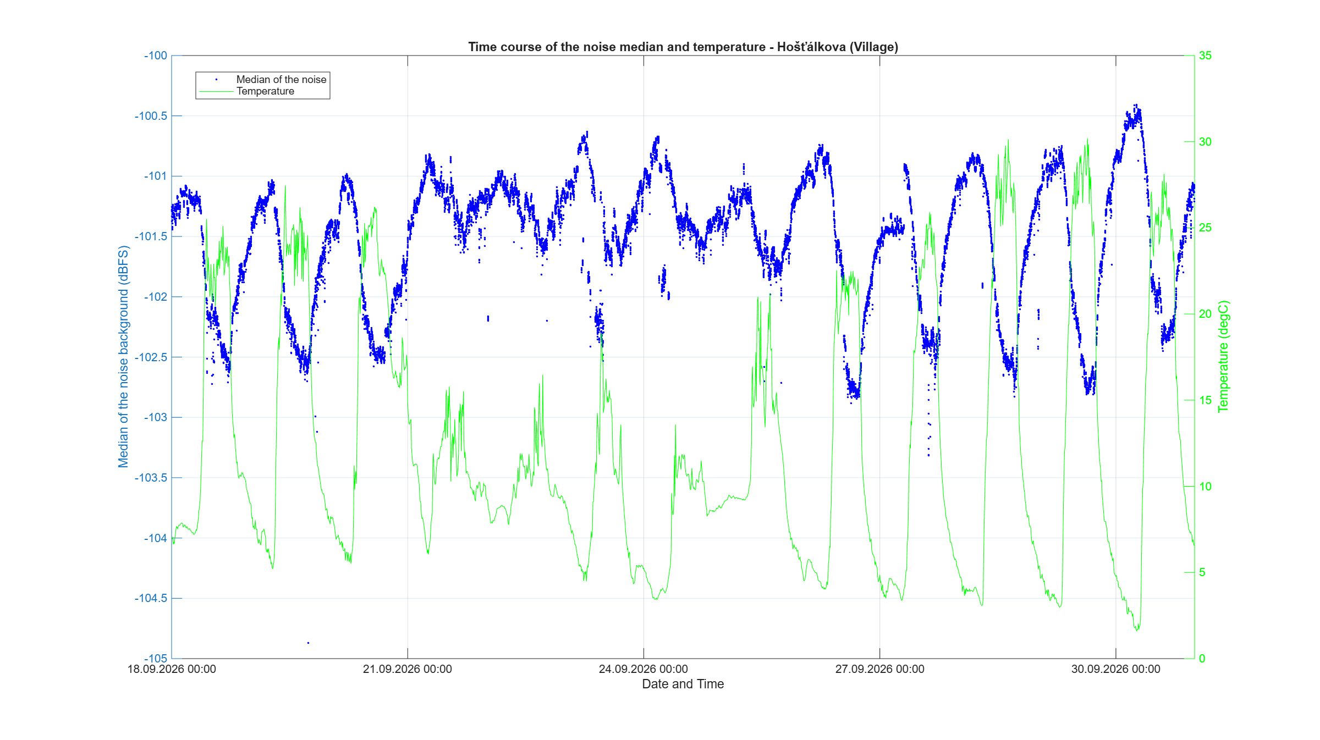
results/noise_temperature/2026-09-18_2026-09-30/village/Merged_temperature_noise_village_20260918_20260930_20261029_074619_887.png
