miradolejs/c-band-downlink-analysis/results/noise_temperature/2026-10-16_2026-10-25/city/Merged_temperature_noise_city_20261016_20261025_20261030_063521_560.png

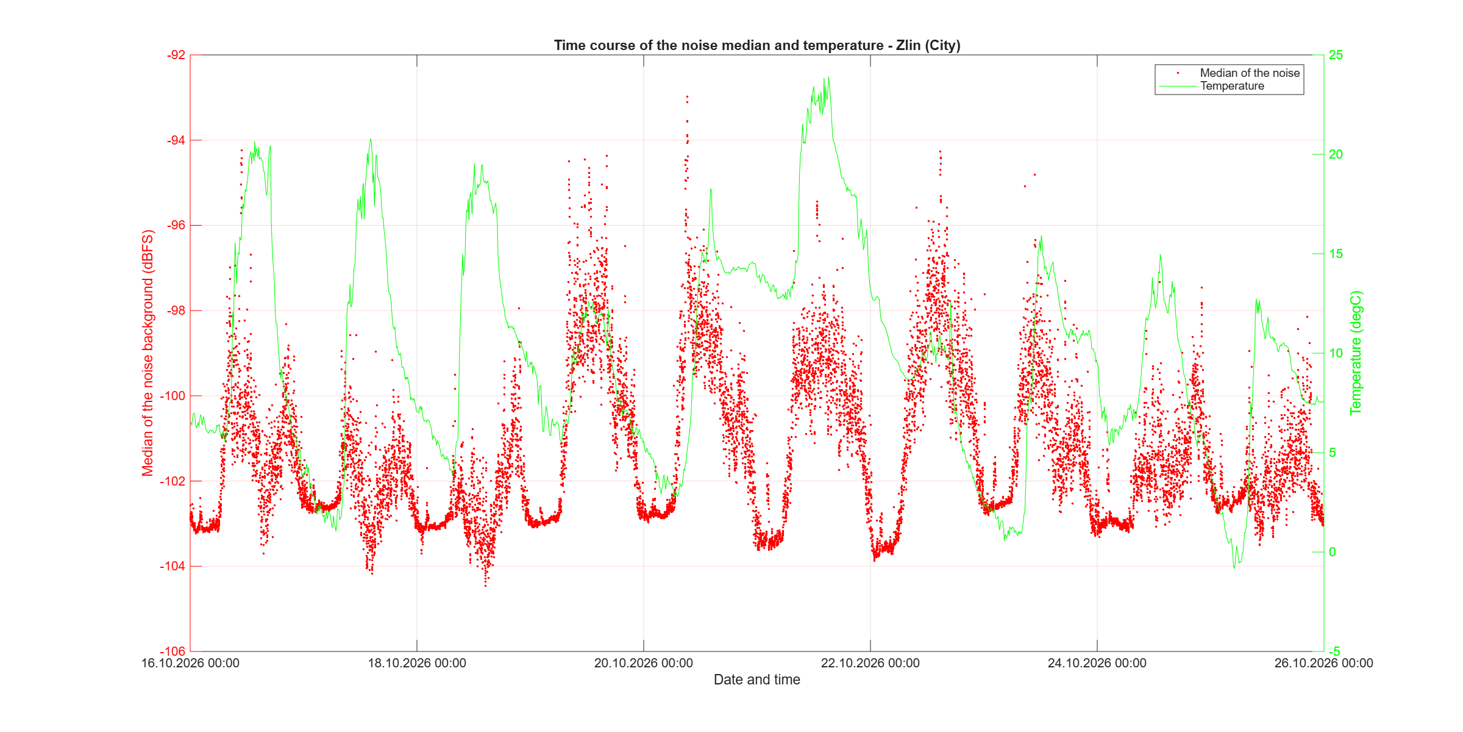
results/noise_temperature/2026-10-16_2026-10-25/city/Merged_temperature_noise_city_20261016_20261025_20261030_063521_560.png
