miradolejs/c-band-downlink-analysis/results/noise_temperature/2026-10-16_2026-10-25/village/Merged_temperature_noise_village_20261016_20261025_20261030_064547_654.png

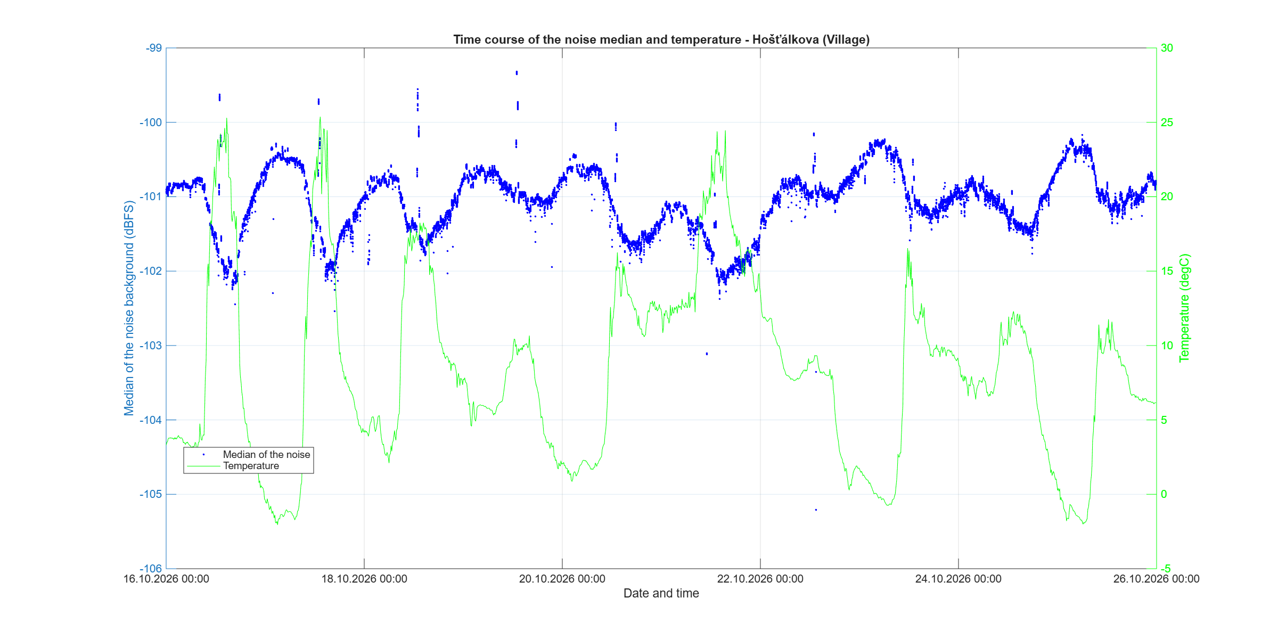
results/noise_temperature/2026-10-16_2026-10-25/village/Merged_temperature_noise_village_20261016_20261025_20261030_064547_654.png
