miradolejs/c-band-downlink-analysis/results/snr/2026-09-18_2026-09-30/Merged_snr_20260918_20260930_20261029_071306_686_band01.png

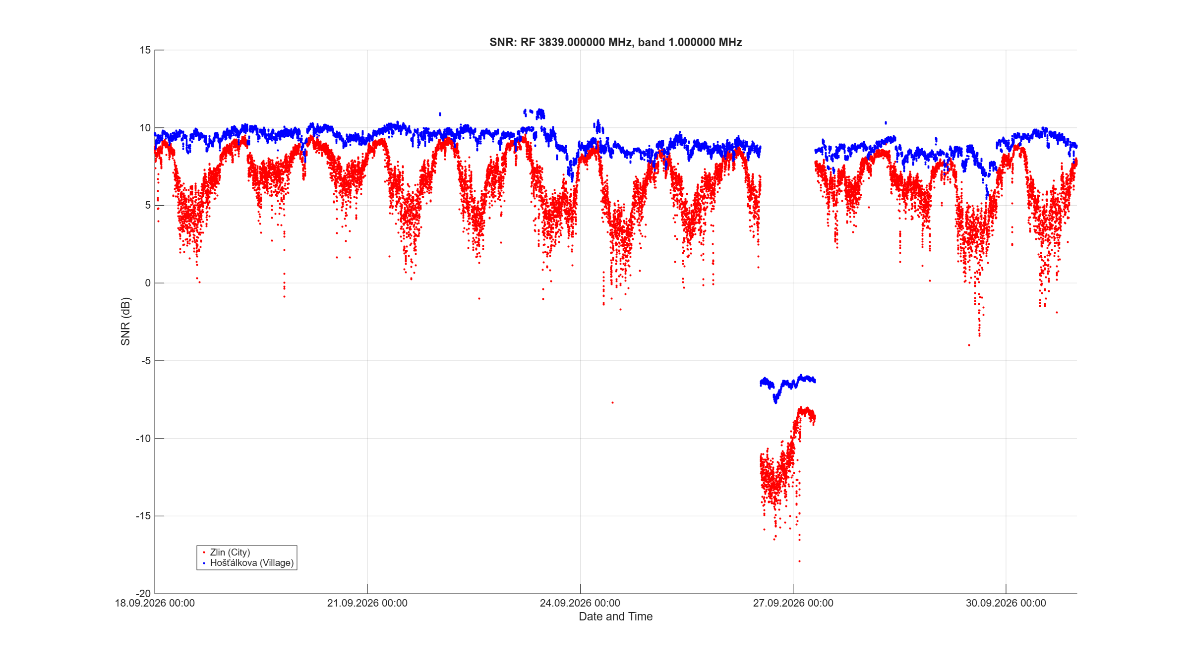
results/snr/2026-09-18_2026-09-30/Merged_snr_20260918_20260930_20261029_071306_686_band01.png
