miradolejs/c-band-downlink-analysis/results/snr/2026-10-16_2026-10-25/Merged_snr_20261016_20261025_20261030_061232_408_band02.png

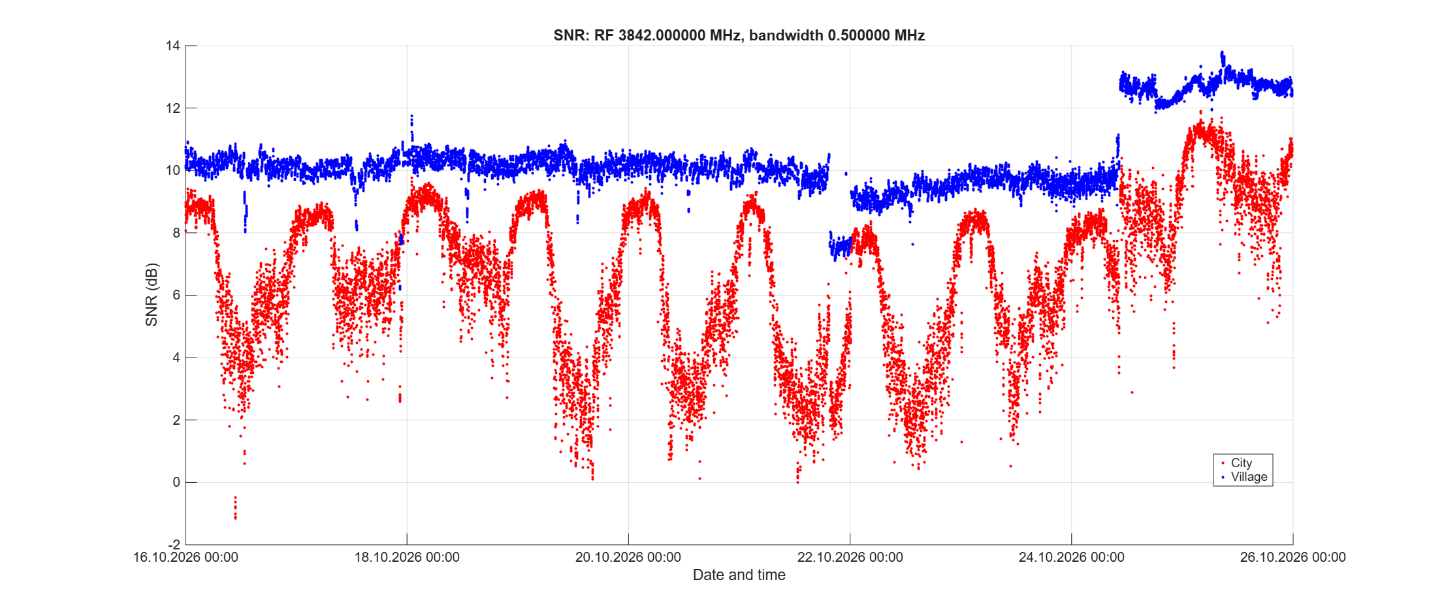
results/snr/2026-10-16_2026-10-25/Merged_snr_20261016_20261025_20261030_061232_408_band02.png
