miradolejs/c-band-downlink-analysis/results/downlink_frames/visualization/2026-09-25_2026-09-30/01_time_series.pdf

## Six

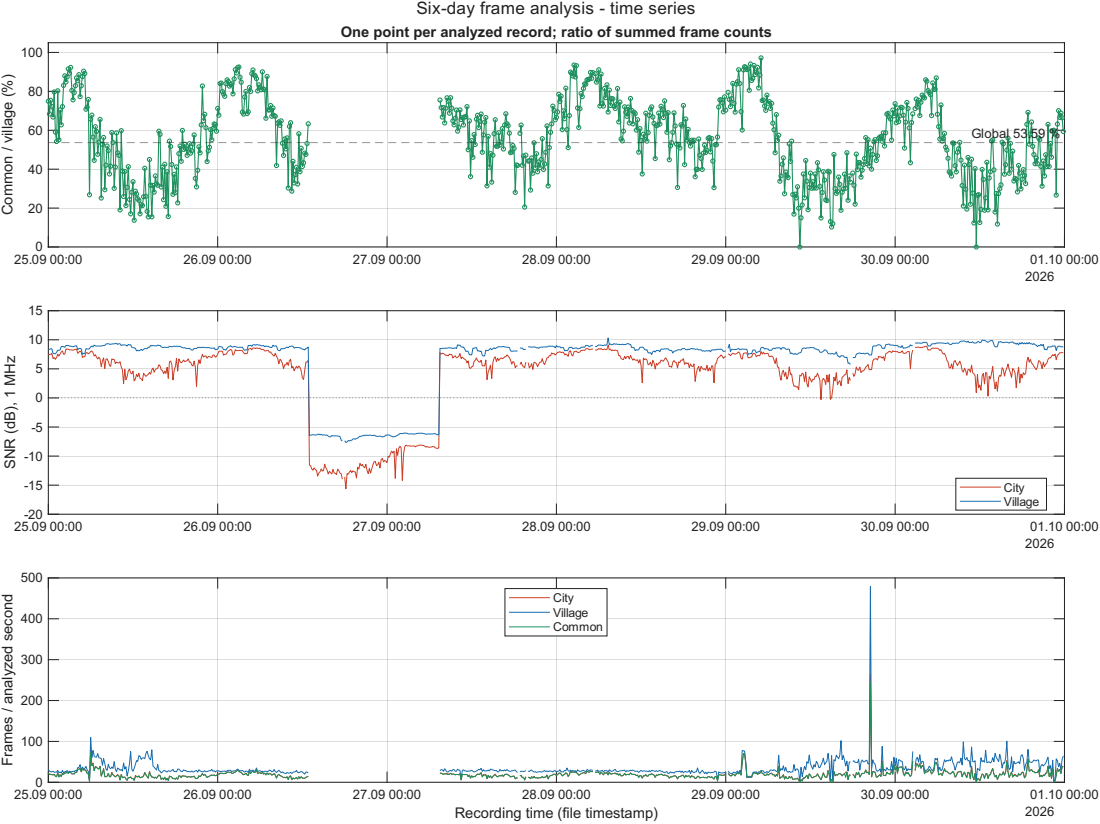
[picture p51: page 1]
aly; sis; tim; rie; Common / village (%); oin; tio; Glo; Cit; y Villa; din; file

SNR (dB), 1 MHz

Cit y Villa g e

Frames / analyzed second
