miradolejs/c-band-downlink-analysis/results/downlink_frames/visualization/2026-09-25_2026-09-30/03_snr_relationship.pdf

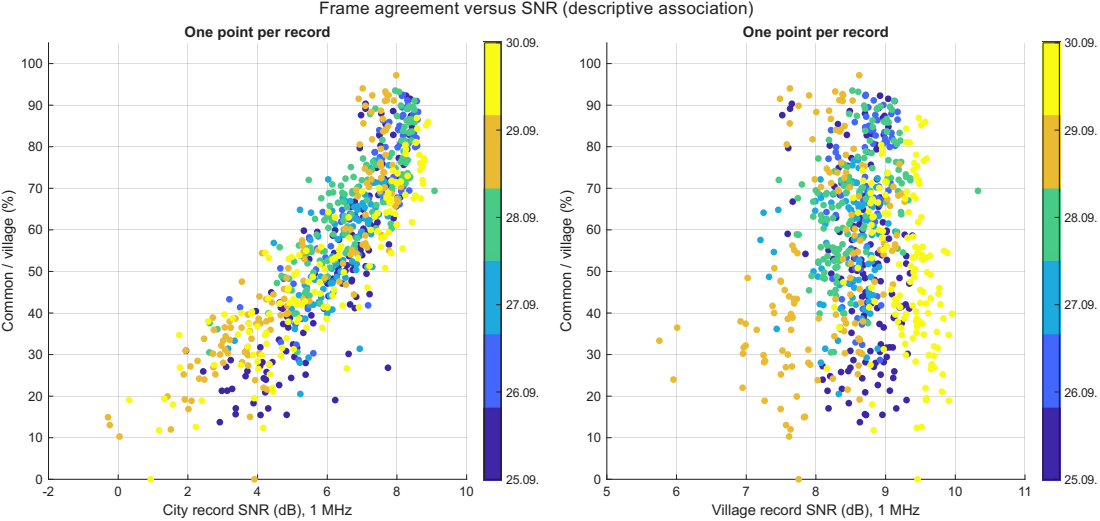
[picture p52: page 1]
n / villa

Frame agreement versus SNR (descriptive association)

One point per record

City record SNR (dB), 1 MHz

Village record SNR (dB), 1 MHz
