miradolejs/c-band-downlink-analysis/results/downlink_frames/visualization/2026-09-25_2026-09-30/05_within_record_variability.pdf

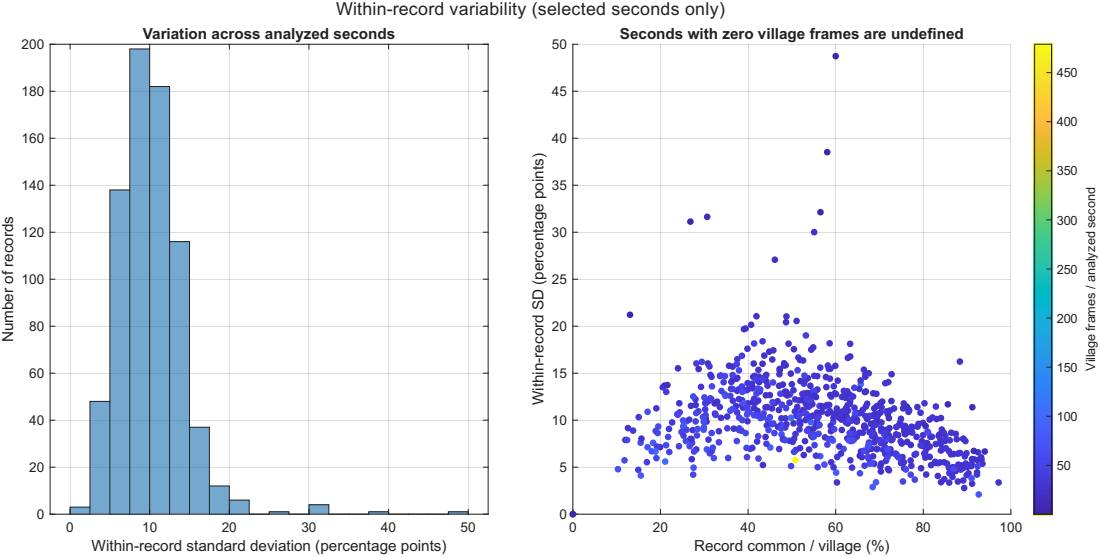
[picture p53: page 1]
ord; Within-re; erc; nta; oints)

Within-record variability (selected seconds only)

Variation across analyzed seconds

Seconds with zero village frames are undefined

Village frames / analyzed second

Within-record standard deviation (percentage points)

Record common / village (%)
