miradolejs/c-band-downlink-analysis/measurement_stations/hardware/photos/urban_antenna_front.jpeg

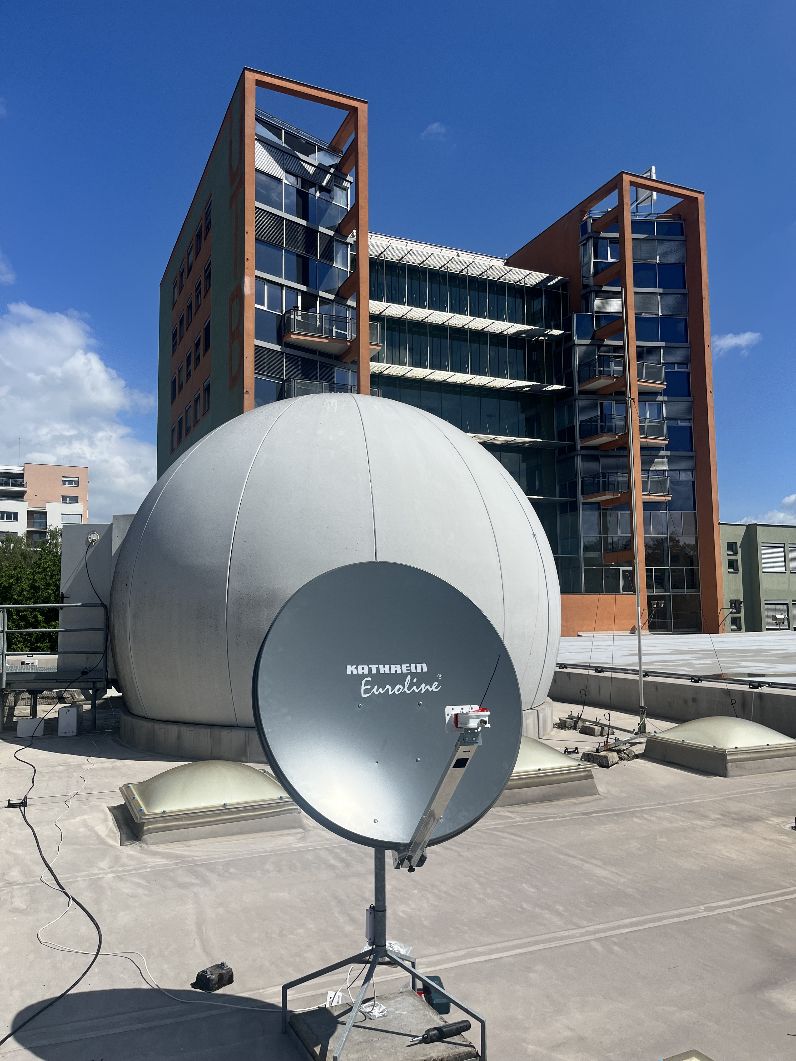
[picture p3: measurement_stations/hardware/photos/urban_antenna_front.jpeg]
measurement_stations/hardware/photos/urban_antenna_front.jpeg
